tomrodinger/RS485_Controller/datasheet/assets/connection-diagram-prompt.txt

Use case: infographic-diagram
Asset type: professional technical datasheet connection illustration, landscape white background.
Primary request: Show one Gearotons RS485 Controller and exactly TWO NEMA 17 intelligent servomotors, with accurate, easy-to-follow power, RS485 A, RS485 B and COMMON GROUND connections. Use polished restrained semi-isometric technical cartoon objects with clean vector-like wiring and readable sans-serif labels. Reference image 1 shows controller hardware appearance, reference image 2 the controller including the external flat antenna. The controller is a small green ESP32-S3 PCB with two USB-C sockets, green 2-way screw terminal, 8-pin right-angle header, metal RF module and external flat black antenna.
Layout: controller left, Motor 1 center-right, Motor 2 far right. A small USB-C PD power adapter above the controller is labelled "USB-C PD supply" and "20 V capable". Its one cable goes ONLY to controller port labelled "J3 · PD POWER". Another OPTIONAL dashed cable from a small laptop goes ONLY to the OTHER controller USB-C port labelled "J5 · PROGRAM". Keep laptop tiny.
Electrical topology must be exact: controller exposes labelled functional terminal points "J1 +20 V", "J1 GND", "J2 A", "J2 B", "J2 GND". Each motor exposes four clearly separated labelled terminals "V+", "GND", "A", "B". RED power line runs from J1 +20 V to BOTH motors' V+. GREEN line runs from J2 A to Motor 1 A then Motor 2 A. BLUE line runs from J2 B to Motor 1 B then Motor 2 B. BLACK common-ground line runs from J1 GND to BOTH motor GND terminals AND connects to J2 GND. The GND connection is prominent, continuous and explicitly labelled "COMMON GROUND". Controller J1 GND and J2 GND are the same ground net. No lines connect unlike nets. Show branches using junction dots. Keep all connection routes legible and separated. The controller header 3.3 V and 5 V outputs MUST NOT connect to motor V+. You may simplify terminals into labelled schematic ports beside the illustrated objects to keep connectivity precise. All four nets are parallel shared nets; do not connect motors in series.
Text (verbatim): "Motor 1", "Motor 2", "RS485 Controller", "A → A", "B → B", "COMMON GROUND", "20 V to V+".
Style: elegant engineering documentation, green and dark charcoal palette, thin even linework, subtle shadows, realistic proportions, large whitespace and clear hierarchy. No invented specifications, no extra motors, no decorative wires, no title banner. Physical port locations are schematic, not a mating-face pinout. Do not add resistors. Make artwork large, at least 1536 pixels wide if possible.

Generated with the built-in image_gen tool on 2026-10-26. Reference images: owner-supplied component-side photo and front photo with antenna. This is a functional connection illustration; drawn terminal positions are not physical connector locations. All four nets were visually checked after generation.
