tomrodinger/RS485_Controller/diagram-review/prompts/02-motor-asset.txt

Use case: scientific-educational
Asset type: isolated product illustration asset for a technically accurate wiring manual. This is ONE motor asset only, no full diagram.
Reference image shows the real Gearotons M17 motors. Illustrate exactly ONE Gearotons M17-48 intelligent servomotor, three-quarter view slightly from above and from the connector side. Make the white SIX-position JST-PH-style SIDE connector near the bottom clearly visible, with a white mating pigtail plug seated in it. The six wire-exit positions must be individually countable. The motor is a black ribbed rectangular NEMA17 body with silver square top faceplate, four mounting holes and central short metal shaft rising upwards. Keep the form close to reference; no invented front panel or coloured screw terminals.
Style: polished restrained semi-isometric engineering illustration with subtle material shading, crisp edges, soft neutral illumination. More precise and professional than a playful cartoon. Transparent background, no desk, no labels, no text, no wire looms, no connecting cables, no arrows, no shadow on a background. Use a high enough resolution for a printable manual.
Composition: motor centered, completely within frame, generous 10% whitespace around it. Orient the connector low on the near-facing side and the mating plug's six wire-exit holes horizontally aligned and facing the viewer at the bottom. The plug should be large enough to support later precise vector wiring. Do not generate any wires; this asset will be used with exact overlaid technical connections.
