tomrodinger/RS485_Controller/diagram-review/reviews/ai-flat-technical-v1-visual-rejection.md

# Visual rejection: ai-flat-technical-v1

Inspected `diagram-review/candidates/ai-flat-technical-v1.png`.

Status: rejected; do not treat a style score as a technical pass.

- The realistic controller header shows two exposed male pins above the first attached black GND jumper. Black/green/blue therefore appear attached at physical positions 3/4/5 while the detached pinout inset claims 1/2/3. This is a hard rejection: physical endpoints disagree with the claimed pin map.
- Motor 1's duplicate A/B pair appears to end below the motor rather than continue to Motor 2. The blue network needs a separate exact trace; at a glance it appears to bypass Motor 1. The requested daisy-chain topology cannot be established confidently from the image.
- Motor 2's harness appears to contain an extra blue/teal lead, making the six-wire function/count unclear. The unused second pair is not visually distinct enough from the incoming pair.
- The two-way distribution block is a convincing physical object, but the wiring/terminal grouping is not clear enough to establish two separately isolated DC nets. Prefer explicitly separated + and GND blocks or exact vector-composed distribution wiring.

The image has stronger real-product appearance and avoids the old invented expansion-pad row, but those gains cannot overcome pin attachment and wire-count errors. I notified the parent and requested an independent electrical trace. The appropriate repair is exact wiring composition over trustworthy part artwork, not another unconstrained full-image regeneration with the same topology burden.
