tomrodinger/RS485_Controller/diagram-review/reviews/final-illustrated-and-gallery-ux-review.md

# Final illustrated revision and gallery screenshot review

## p06 / p07 targeted visual sign-off

Rendered each SVG at 1300 px width and inspected `p06-illustrated-natural-v2` and `p07-illustrated-stylized-v2`.

**Pass for owner preference review.** Scores: natural p06 **90/100**, stylized p07 **91/100**. No new endpoint, crossing, header-count, or false physical motor-face mapping veto found. This is visual sign-off on the schematic preference candidates, not product qualification or publication approval.

- GND and V+ now have an actual visible gap at the test size; neither reads as one merged label.
- “Six-wire pigtail functions” identifies the detached key locally.
- “A leads linked” / “B leads linked” communicates internal continuity without ambiguous references to J2 pin numbers.
- “Use a twisted pair” makes the intended cable treatment explicit.
- Motor connector artwork stays unmated; colored electrical lines terminate in the function key, not unverified physical cavities.
- Optional J2 reference, substantial motor returns, independent spare caps and crossing separation remain clear.

The natural rendering remains slightly stronger as a product presentation; stylized remains slightly more coherent with the schematic controller. Both merit inclusion so the owner can make that aesthetic choice. Smaller fit widths still require zoom and the existing shallow datasheet placement would require a separate print adaptation.

## Website screenshot review scope

Viewed `/tmp/rs485-gallery-desktop.png` (1512 × 1556) and `/tmp/rs485-gallery-mobile.png` (390 × 2695). The desktop capture showed the earlier three-item set; mobile showed six candidates. Findings concern visible UX, not a new independent interaction/storage test. Main agent is conducting browser tests.

## What supports the requested review task

- The active candidate, large star control, rating caption, comment label and textarea form a clear review flow.
- Desktop keeps the image beside the feedback form. Mobile stacks them without hiding the review controls.
- Candidate names, revision metadata and current position identify what receives feedback.
- The progress count, selected-card outline and comparison state provide useful orientation.
- Autosave/account/browser-copy language and export notice make persistence and sharing visible. I cannot independently certify synchronization behavior from screenshots.
- Notes are not forced into a small one-line field. Existing stars and comments remain visible in the mobile capture.

## Highest-priority UX repair

**Make diagram enlargement much easier to discover and tap on mobile.** The mobile fit view is around 12%, so the connection labels are necessarily unreadable there. Much of the viewer's height becomes empty space around a shallow landscape image, while Expand/100%/+/− are tiny toolbar actions. A user can reach the rating form without ever seeing a legible pinout.

Recommended repair: promote a clear “Expand diagram” button with a generous touch target adjacent to the viewer and add a short cue such as “Zoom in before rating; pin labels are small in fit view.” The existing expansion feature can be retained; this is a discoverability/touch-size change. Reduce unnecessary fit-view height on mobile if practical, but retain enough space for panning after zoom.

The mobile hint currently describes Ctrl/⌘ scroll and arrow keys, which does not teach touch users how to inspect the image. Replace it at mobile widths with the actual supported interaction, such as “Drag to pan. Use +/− or Expand to inspect labels.” Do not promise pinch zoom unless it is implemented and tested.

## Secondary UX issues

1. **Passive card stars resemble rating controls.** Card footers display stars beside the comparison checkbox. A user may try to rate there, but the large active-review stars are the actual control. Make card stars open/focus the corresponding review, or label them as a rating summary and add “Open to rate.” This is a potential expectation mismatch, not a demonstrated interaction failure.
2. **Small touch controls.** Compare checkboxes, viewer arrows and zoom actions look much smaller than the main review stars/buttons. The large detail-panel comparison button offers a good alternative. Improving hit areas can preserve the visual size of the icons.
3. **Small secondary text on mobile.** The save help, status chip, revision metadata, card subtitles and viewer hint are dense. They are secondary, but the enlargement instruction and save status should be easier to read than the least-important metadata.
4. **Top actions compete for limited mobile width.** Download PNGs, account status, export and import all occupy the header. They remain usable in the screenshot, but a compact overflow area for infrequent import/download actions would leave review navigation clearer. This is optional and should not delay tested rating/comment persistence.
5. **Comparison selection is reasonably clear.** A 2/2 comparison count and checked cards are shown. The screenshot cannot establish how a third selection is handled; browser testing should confirm an understandable message rather than silently refusing.

No screenshot-level blocker was found for entering stars or comments. The enlargement affordance is the most material usability improvement because reliable feedback depends on inspecting the actual connection labels.
