tomrodinger/RS485_Controller/diagram-review/round2/r2-05-natural-pigtails.pdf

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
ESP32-S3

MINI-1U

J1

J3

J5

S1

S2

GEAROTONS / RS485 CONTROLLER
Two motors. One complete connection map.

USB-C PD input · parallel motor power · one continuous RS485 bus

Controller · PCB 0.5 geometry J2 pins 2 / 3 share one paired housing

## Motor 1

White 6-way motor plug

GND | V+ | A | B | A | B

Schematic harness · mating face not shown

A ↔ A
B ↔ B

Inside motor

## Motor 2

White 6-way motor plug

GND | V+ | A | B | A | B

Schematic harness · mating face not shown

A ↔ A
B ↔ B

Inside motor

V+ · direct PD VBUS from J1

GND · full-size motor return

MOTOR POWER · PARALLEL

A/B DAISY-CHAIN · KEEP EACH PAIR TOGETHER

Spare A/B pair
Two isolated cavities

### 20 V-capable USB-C PD supply

USB-C cable → J3 PD POWER

Power in parallel. A/B continues through Motor 1 to Motor 2.
J1 and J2 GND are common on the PCB; both motors have full-size power-return wires.
20 V is nominal after PD negotiation. Wire with power off; verify voltage and polarity.
A/B lines show electrical pairing; select compatible mating parts. Each black shell has two isolated cavities.
