tomrodinger/RS485_Controller/datasheet/assets/connection-v0.4/two-motor-connection-v0.4.png

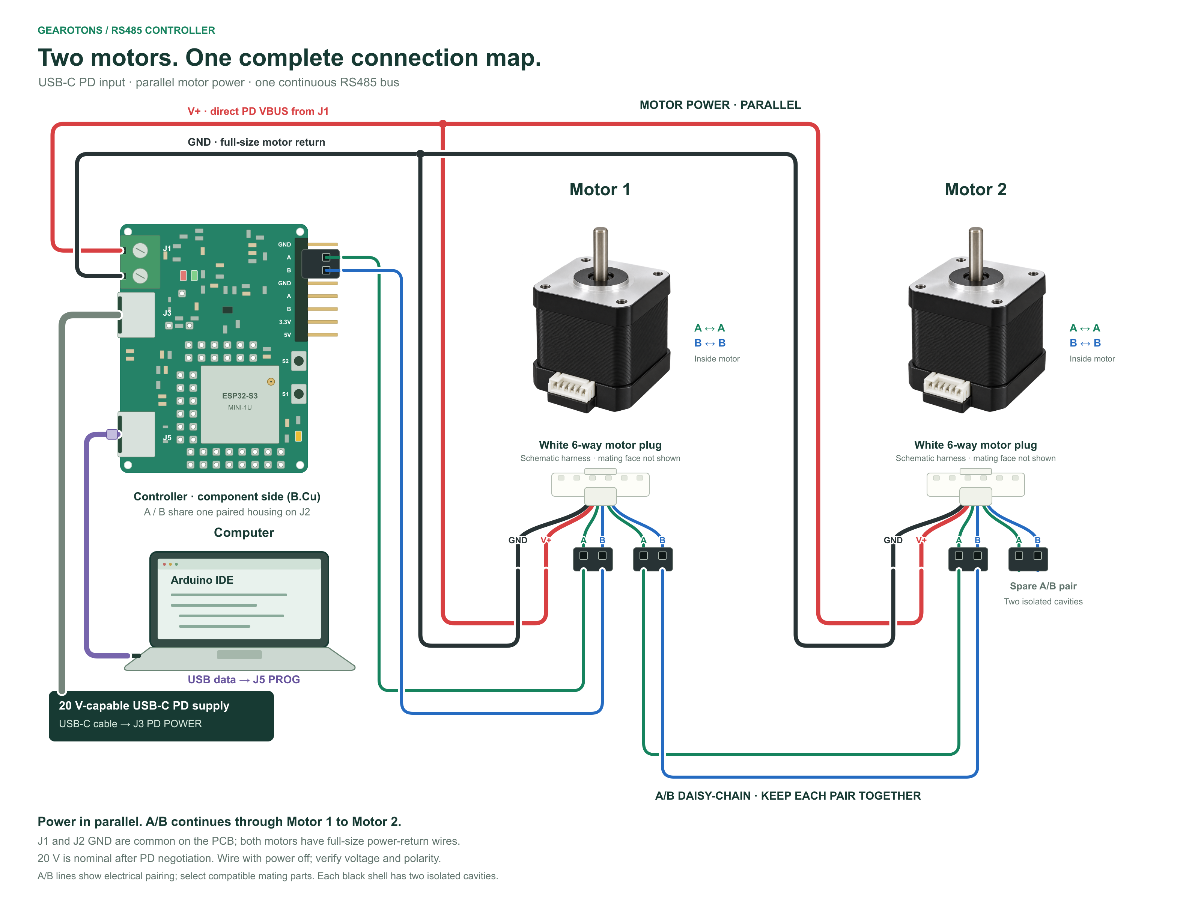
datasheet/assets/connection-v0.4/two-motor-connection-v0.4.png
