tomrodinger/RS485_Controller/datasheet/assets/technical-v4/breakout-headers.png

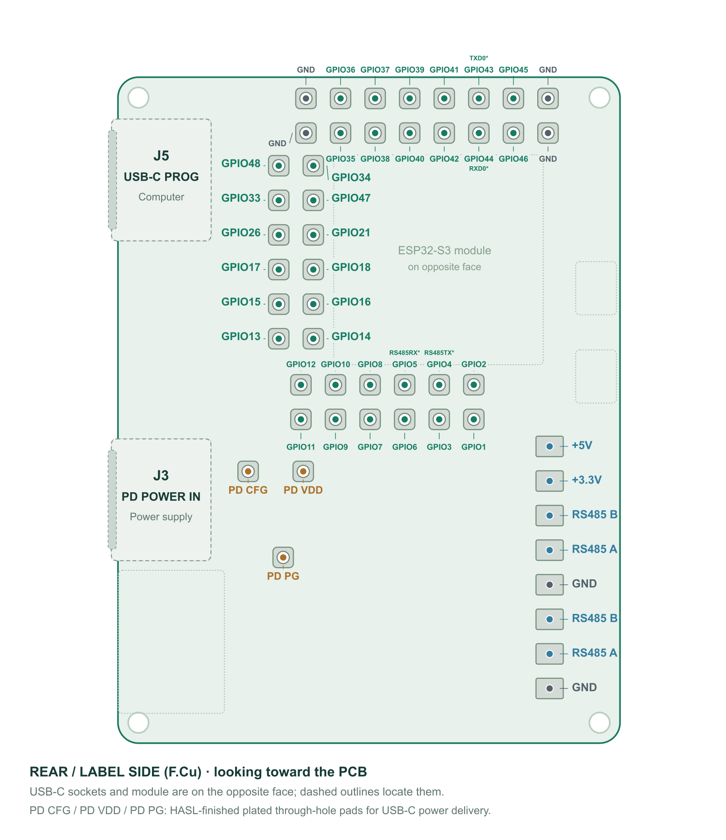
datasheet/assets/technical-v4/breakout-headers.png
