tomrodinger/RS485_Controller/datasheet/assets/technical-v4/connector-locator.png

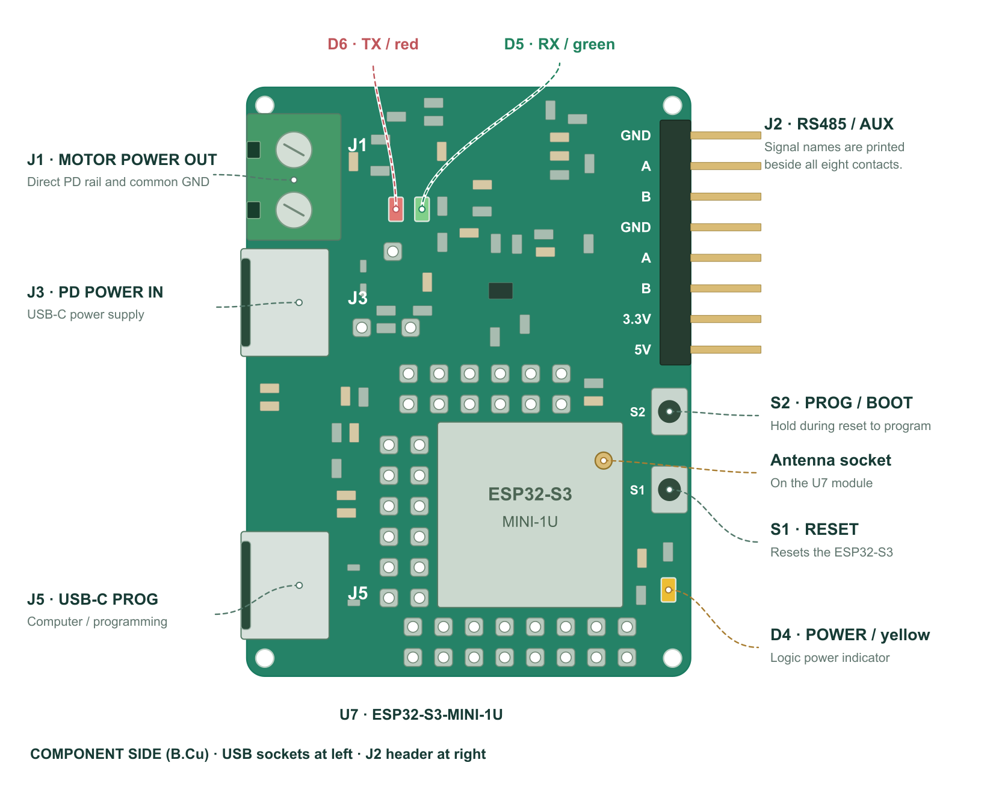
datasheet/assets/technical-v4/connector-locator.png
