tomrodinger/RS485_Controller/datasheet/assets/technical-v4/mechanical-dimensions.png

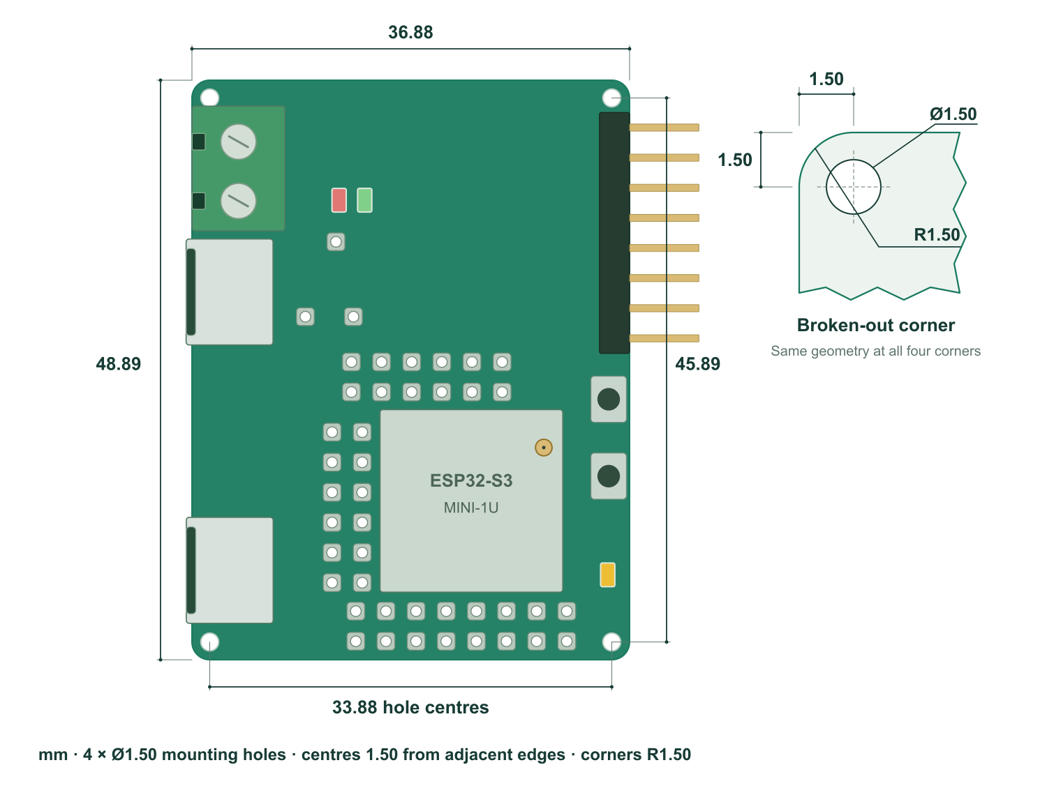
datasheet/assets/technical-v4/mechanical-dimensions.png
