tomrodinger/RS485_Controller/datasheet/assets/two-motor-connection-ai.png

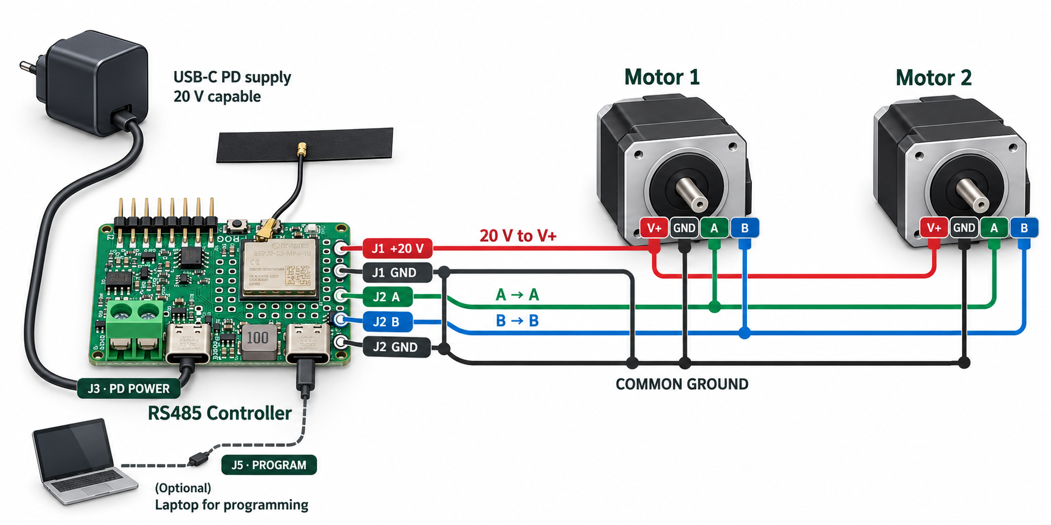
datasheet/assets/two-motor-connection-ai.png
