tomrodinger/RS485_Controller/diagram-review/candidates/ai-flat-technical-v1.png

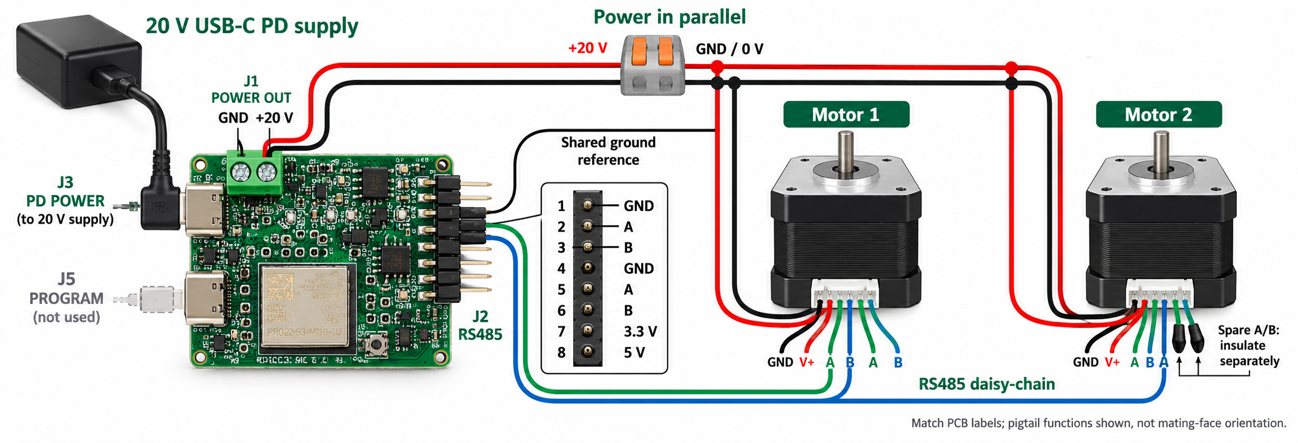
diagram-review/candidates/ai-flat-technical-v1.png
