tomrodinger/RS485_Controller/diagram-review/candidates/p01-connector-landmarks-v1.png

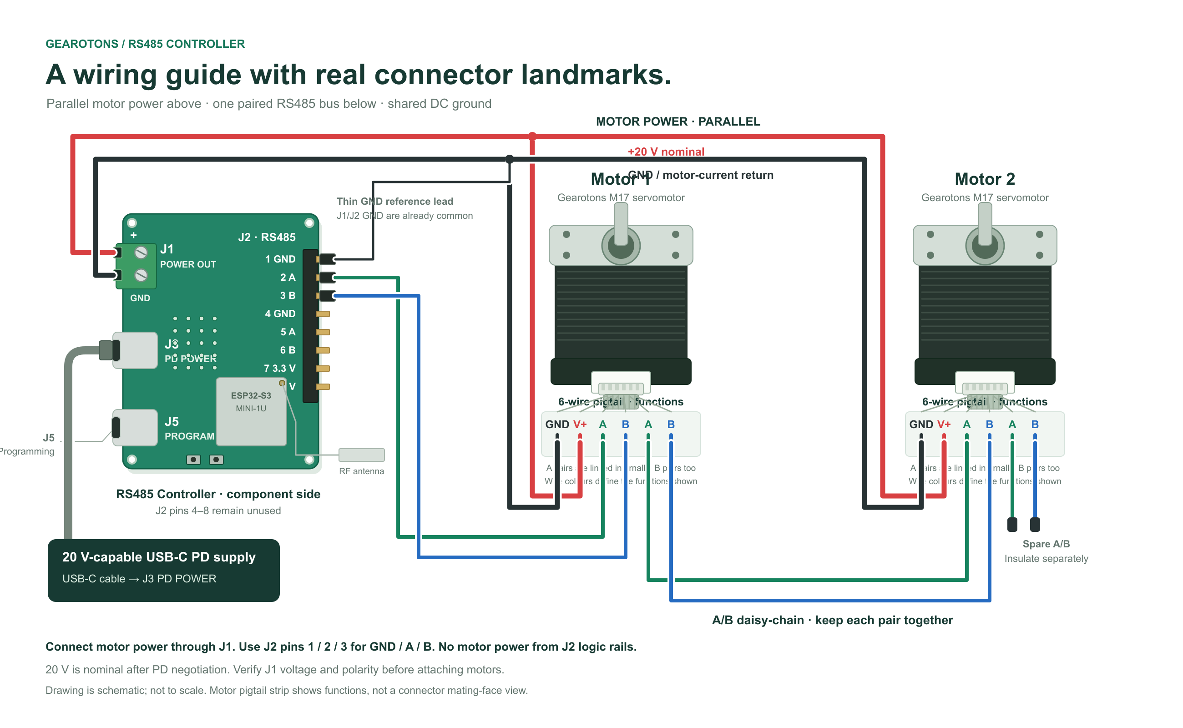
diagram-review/candidates/p01-connector-landmarks-v1.png
