tomrodinger/RS485_Controller/diagram-review/candidates/p04-illustrated-natural-v1.png

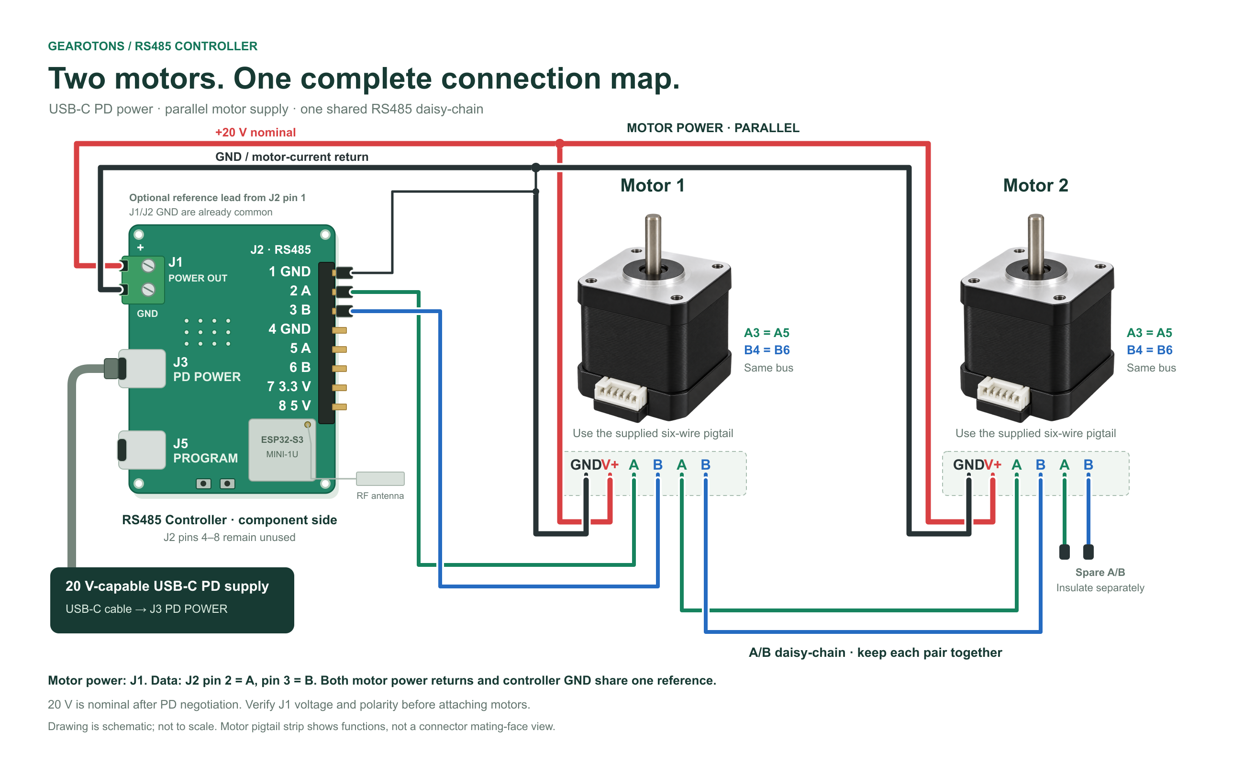
diagram-review/candidates/p04-illustrated-natural-v1.png
