tomrodinger/RS485_Controller/diagram-review/exports/connector-landmarks.png

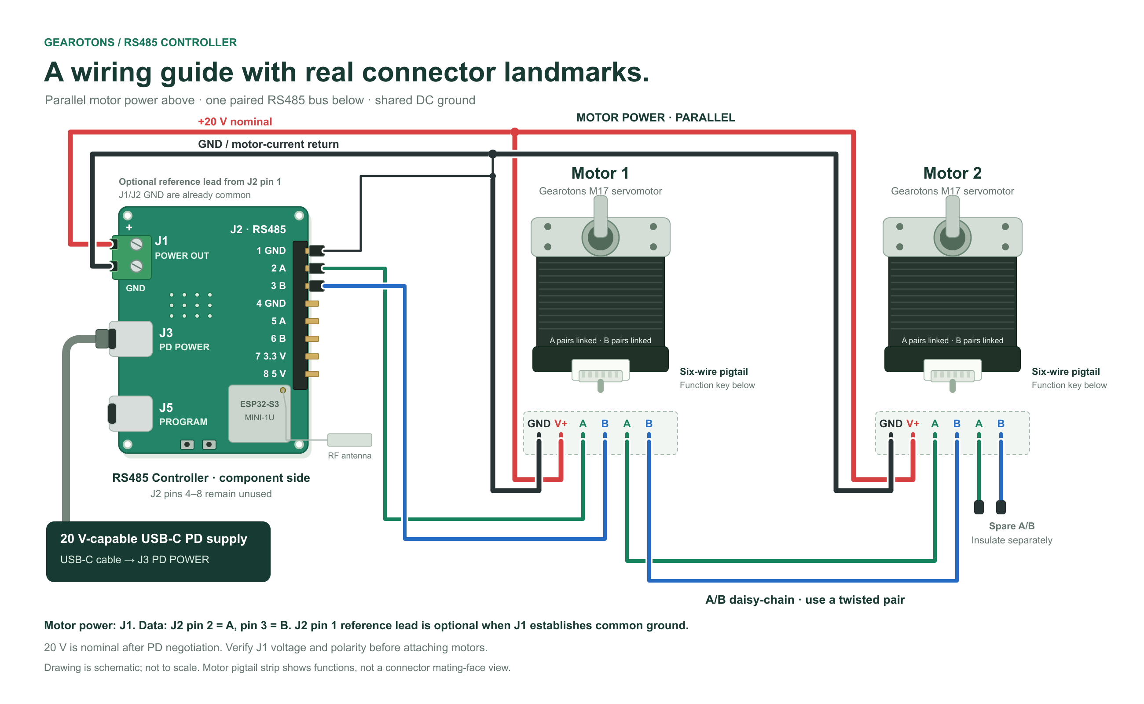
diagram-review/exports/connector-landmarks.png
