tomrodinger/RS485_Controller/diagram-review/exports/r2-01-photo-harness.png

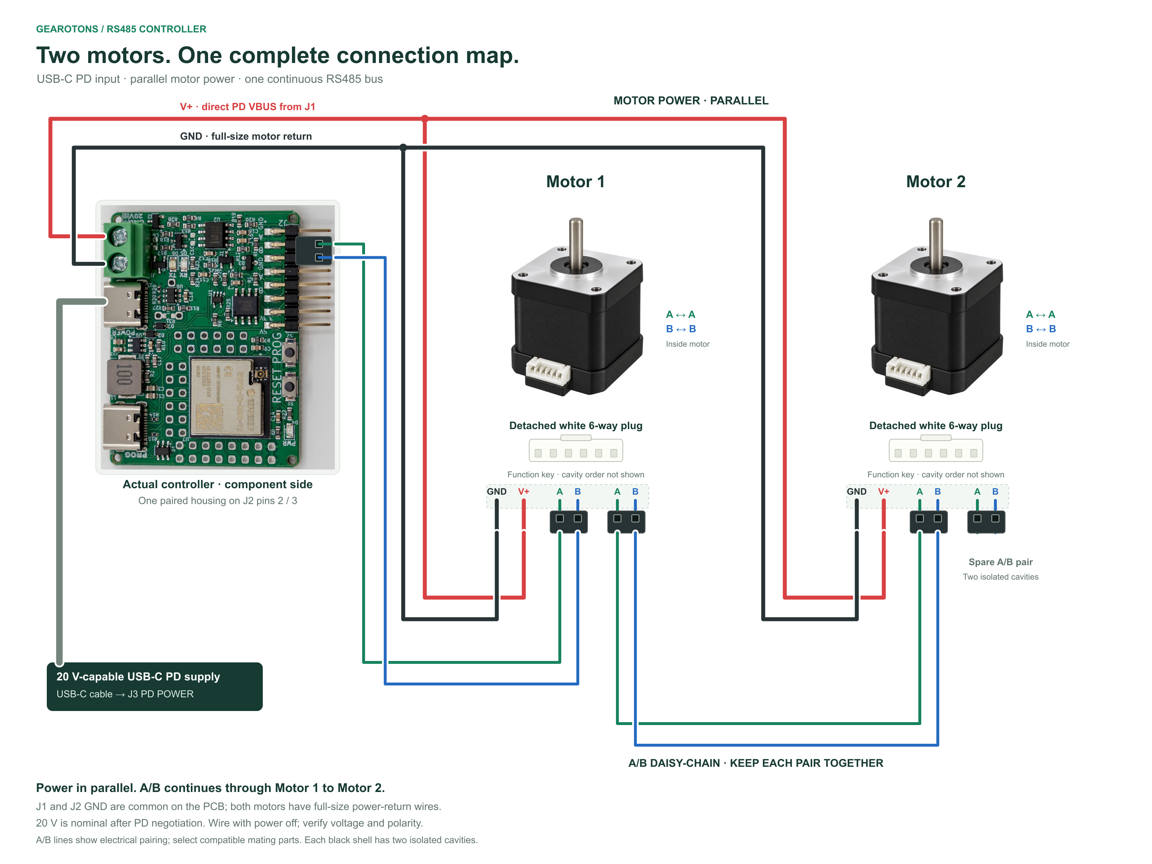
diagram-review/exports/r2-01-photo-harness.png
