tomrodinger/RS485_Controller/diagram-review/exports/round2-pngs/r2-05-natural-pigtails.png

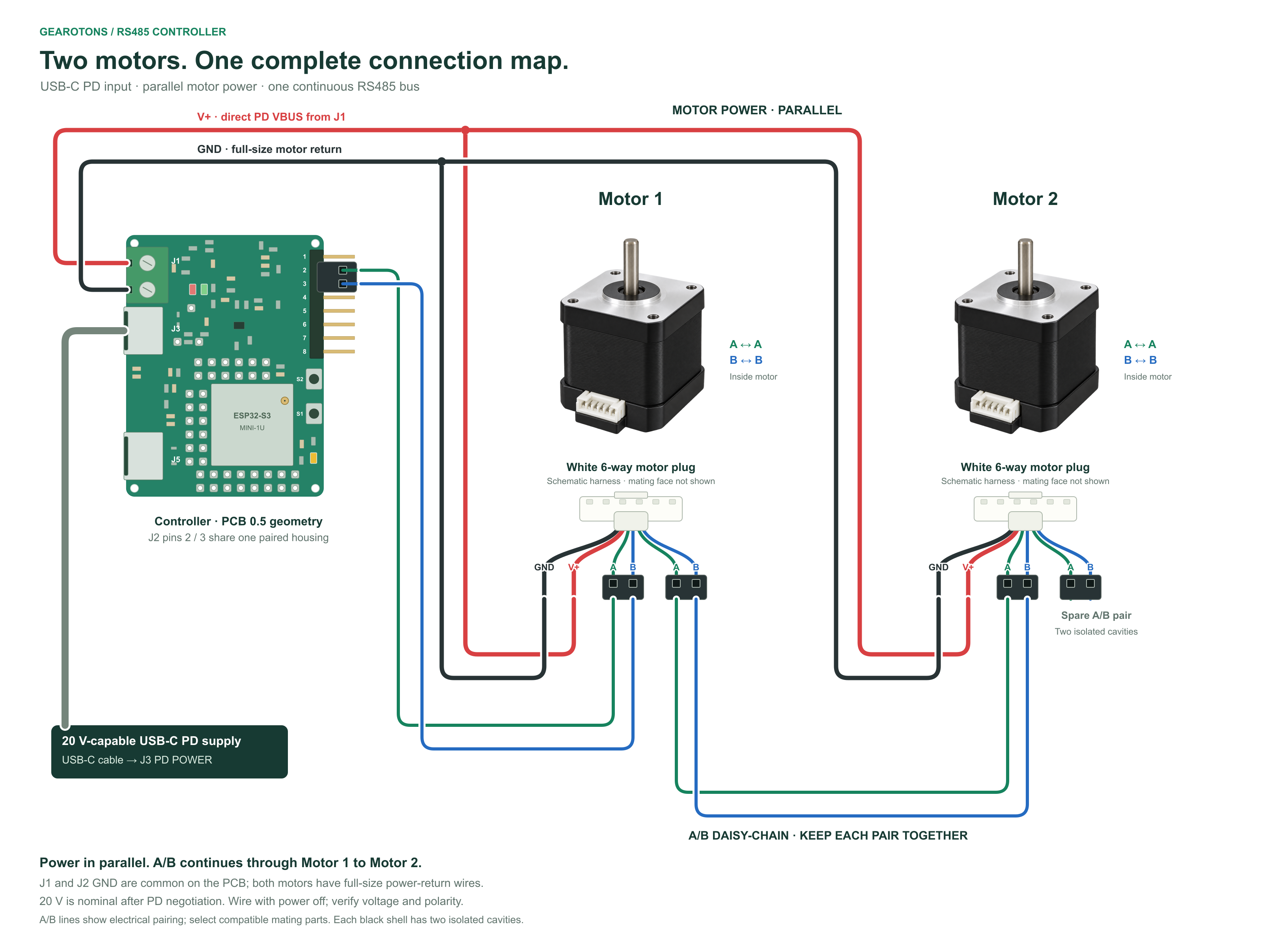
diagram-review/exports/round2-pngs/r2-05-natural-pigtails.png
