tomrodinger/RS485_Controller/diagram-review/visual-candidates/v01-precise-electrical-preview.png

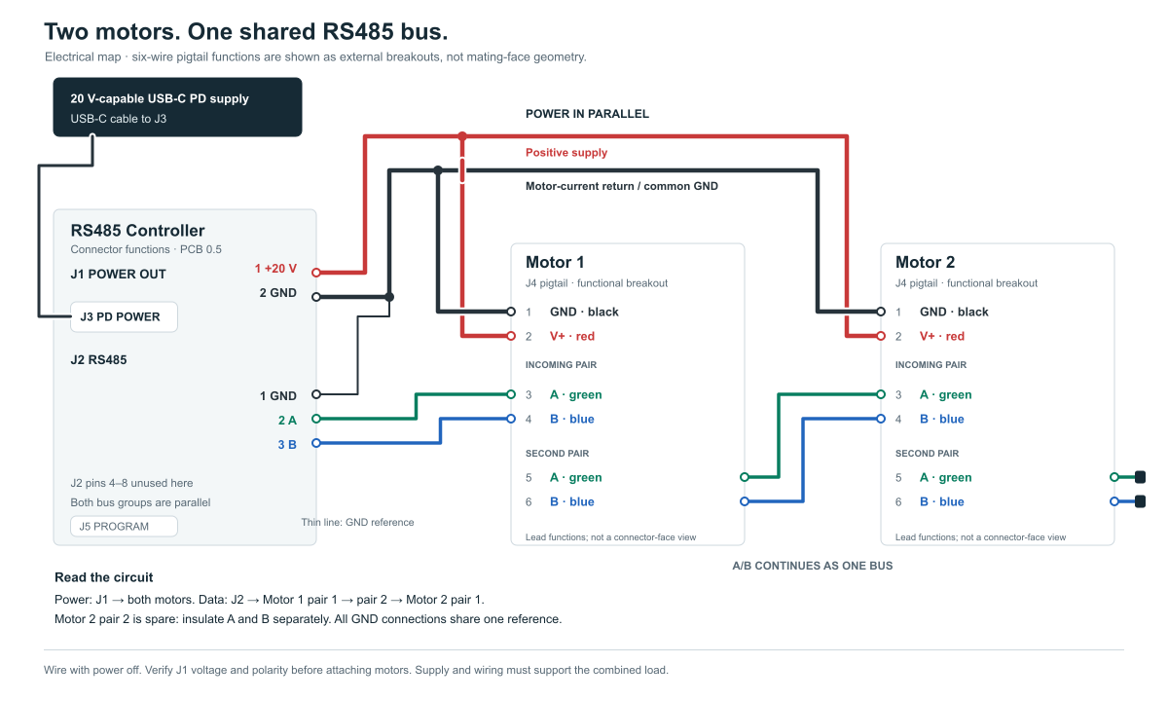
diagram-review/visual-candidates/v01-precise-electrical-preview.png
