tomrodinger/RS485_Controller/diagram-review/working/motor-asset-stylized-v1.png

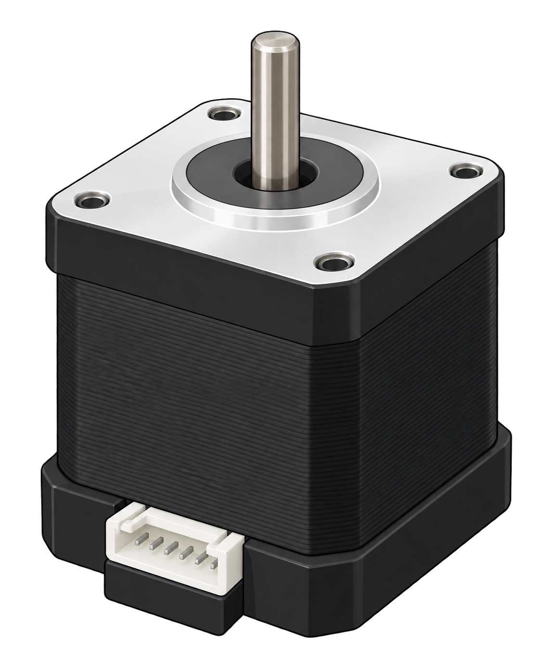
diagram-review/working/motor-asset-stylized-v1.png
