tomrodinger/RS485_Controller/diagram-review/working/motor-asset-v1.png

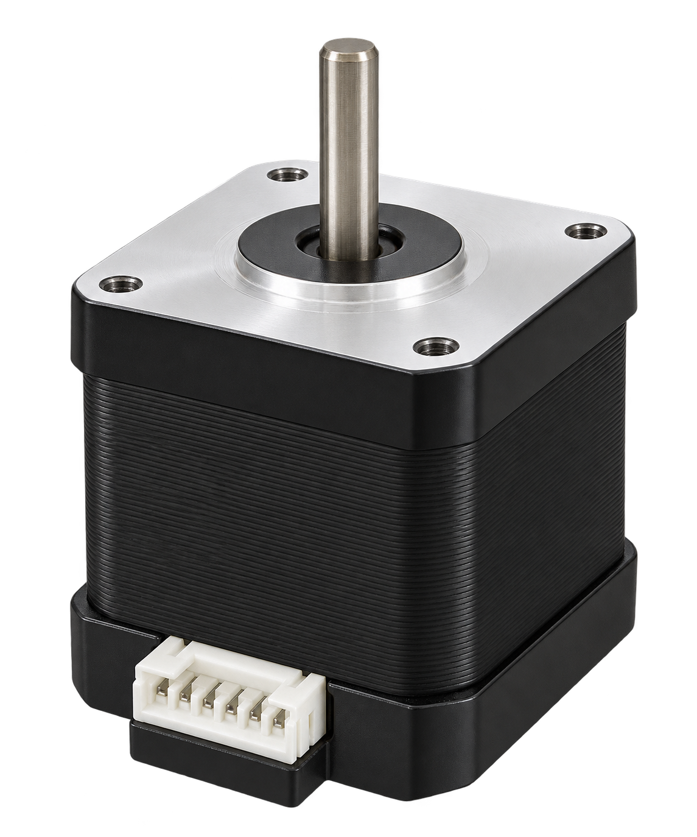
diagram-review/working/motor-asset-v1.png
