tomrodinger/RS485_Controller/images/rs485-controller/label-side-800.webp

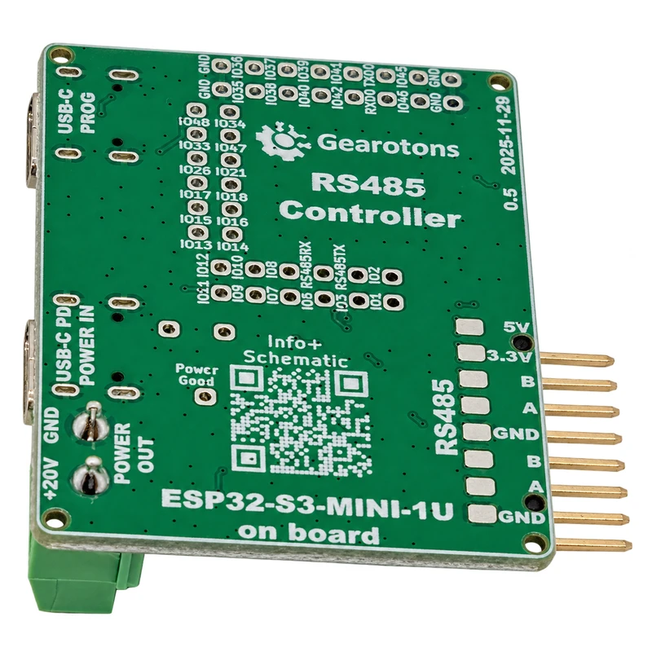
images/rs485-controller/label-side-800.webp
