tomrodinger/RS485_Controller/images/rs485-controller/ports-800.webp

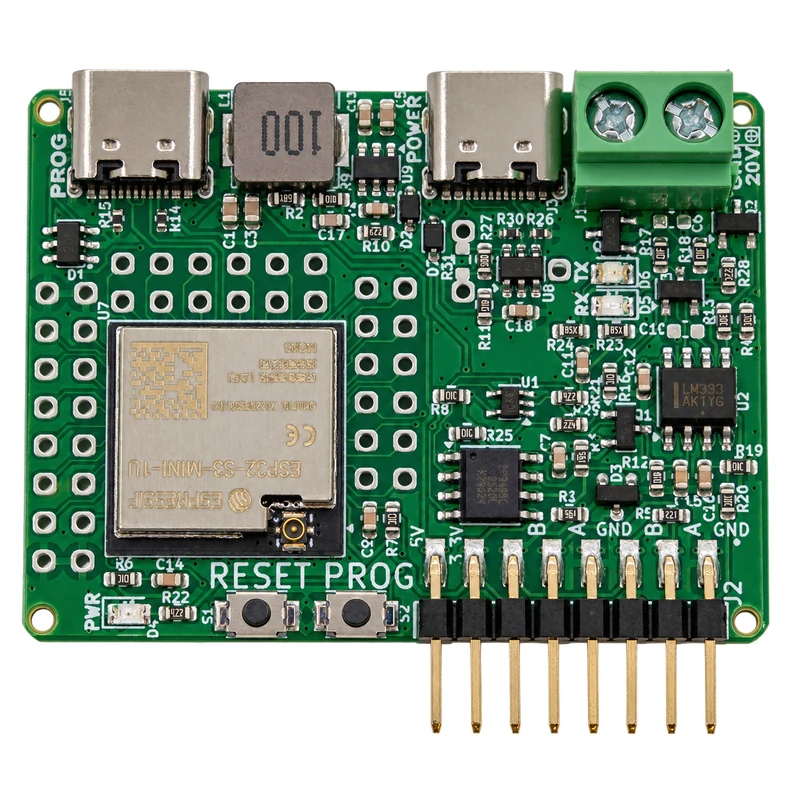
images/rs485-controller/ports-800.webp
