tomrodinger/RS485_Controller/PCB/V1_not_completed/screenshots/3Dtop.png

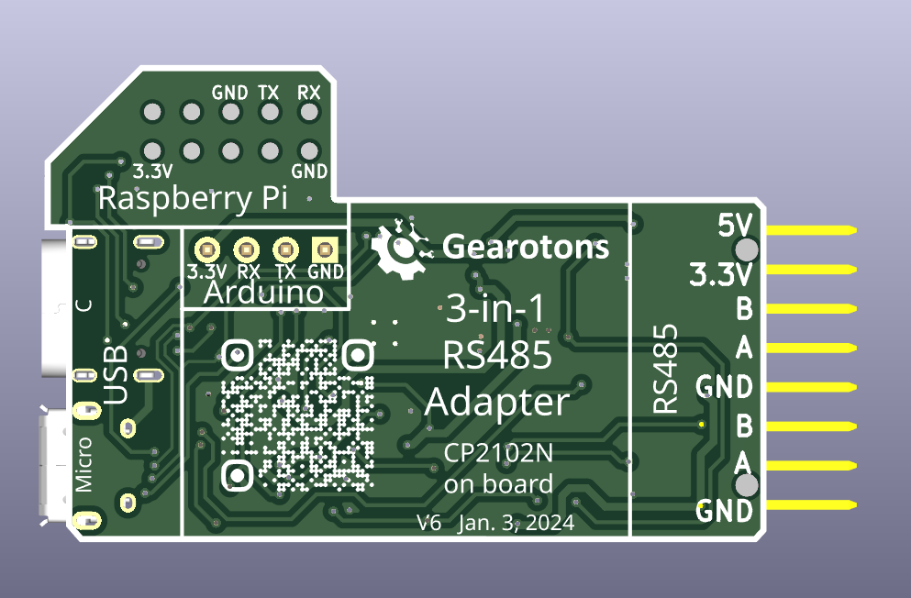
PCB/V1_not_completed/screenshots/3Dtop.png
