tomrodinger/RS485_Controller/images/rs485-controller/component-side-background-prompt.txt

Use case: background-extraction. Edit target: the supplied real product photograph of a Gearotons RS485 Controller. Remove ONLY the gray tabletop/background and all tabletop shadows, replacing them with genuinely transparent pixels. Angled isometric component-side view of the PCB without antenna; preserve the two USB-C ports, the green two-way screw terminal, eight long gold header pins, module shield and every small component and marking. Preserve the original product pixels, photographic detail, geometry, colors, focus, solder, traces, silkscreen lettering and fine edges. Cleanly cut out the board and every protruding pin/port, including the background visible between pins and through holes. Do not redraw or retouch the product or invent any text or parts. Keep the complete product and original square framing. No background color, gray matte, checkerboard artwork, halo, drop shadow, captions or watermark. Output a high-resolution transparent PNG.
