tomrodinger/RS485_Controller/PCB/0.5/production/bom.csv

Designator | Footprint | Quantity | Value | LCSC Part #
C1, C3 | 0603 | 2 | 22uF/6.3V | C59461
C11, C12, C13, C16, C4, C7 | 0603 | 6 | 100nF/50V | C14663
C14, C9 | 0603 | 2 | 10nF | C57112
C15 | 0603 | 1 | 1nF | C1588
C17 | 0603 | 1 | 47pF | C1671
C18 | 0603 | 1 | 1uF/25V | C15849
C5 | 0603 | 1 | 10uF/25V | C96446
D1 | SOT23-6L | 1 | TVS_5V | C558417
D2, D7 | SOD323 | 2 | 1N5819WS | C191023
D3 | SOT23-3 | 1 | SM712 | C293966
D4 | 0805 | 1 | yellow | C2296
D5 | 0805 | 1 | green | C2297
D6 | 0805 | 1 | red | C84256
J1 | 2P_screw_terminal | 1 | Screw_Terminal_01x02 | C8404
J2 | Connector_8-pin_SMT_hole_1.5mm | 1 | TSM-108-01-T-SH-A-P-TR | C9900147851
J3, J5 | USB_C_Receptacle_Palconn_UTC16-G | 2 | USB_C_Receptacle | C2765186
L1 | Inductor_7.3x6.6mm | 1 | 10uH | C128692
Q1, Q2, Q3 | SOT-23 | 3 | BSS84AK,215 | C127273
Q4 | SOT-23 | 1 | Q_NMOS_GSD | C8545
R1, R3 | 0603 | 2 | 560R | C23204
R10 | 0603 | 1 | 22k | C31850
R11, R12 | 0603 | 2 | 1k | C21190
R13, R20, R4 | 0603 | 3 | 20k | C4184
R14, R15, R26, R30 | 0402 | 4 | 5.1k | C25905
R16, R19, R25, R6, R7, R8 | 0603 | 6 | 10k | C25804
R17, R18 | 0603 | 2 | 10M | C7250
R2 | 0603 | 1 | 49.9 | C23185
R21, R22, R28, R29 | 0603 | 4 | 4.7k | C23162
R23, R24 | 0603 | 2 | 75R | C4275
R27 | 0603 | 1 | 200k | C25811
R5 | 0603 | 1 | 220R | C22962
R9 | 0603 | 1 | 100k | C25803
S1, S2 | button | 2 | SW_Push | C720477
U1 | Texas_R-PDSO-G5_DCK-5 | 1 | SN74LVC1G00DCK | C2976658
U2 | SOIC-8_3.9x4.9mm_P1.27mm | 1 | LM393DR2G | C7955
U5 | SOIC-8_3.9x4.9mm_P1.27mm | 1 | SP3485EN | C8963
U7 | ESP32-S2-MINI-1U | 1 | ESP32-S3-MINI-1U | C2980299
U8 | SOT-23-6 | 1 | CH221K | C5125736
U9 | SOT-23-6 | 1 | TPS54202DDC | C191884
