tomrodinger/RS485_Controller/PCB/V1_not_completed/3D/RPH1-V6-04-01-24.step

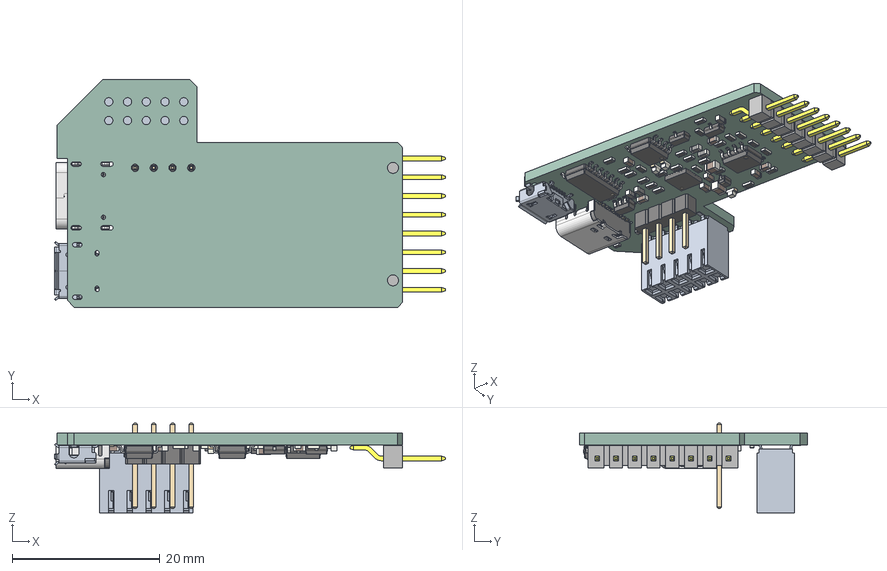
[picture p22: CAD file, 2026-11-04]
PCB/V1_not_completed/3D/RPH1-V6-04-01-24.step
52.9 x 30.9 x 12.1 mm
uw-rs485_hat-V6 PCB
