tomrodinger/RS485_Controller/diagram-review/exports/two-step.png

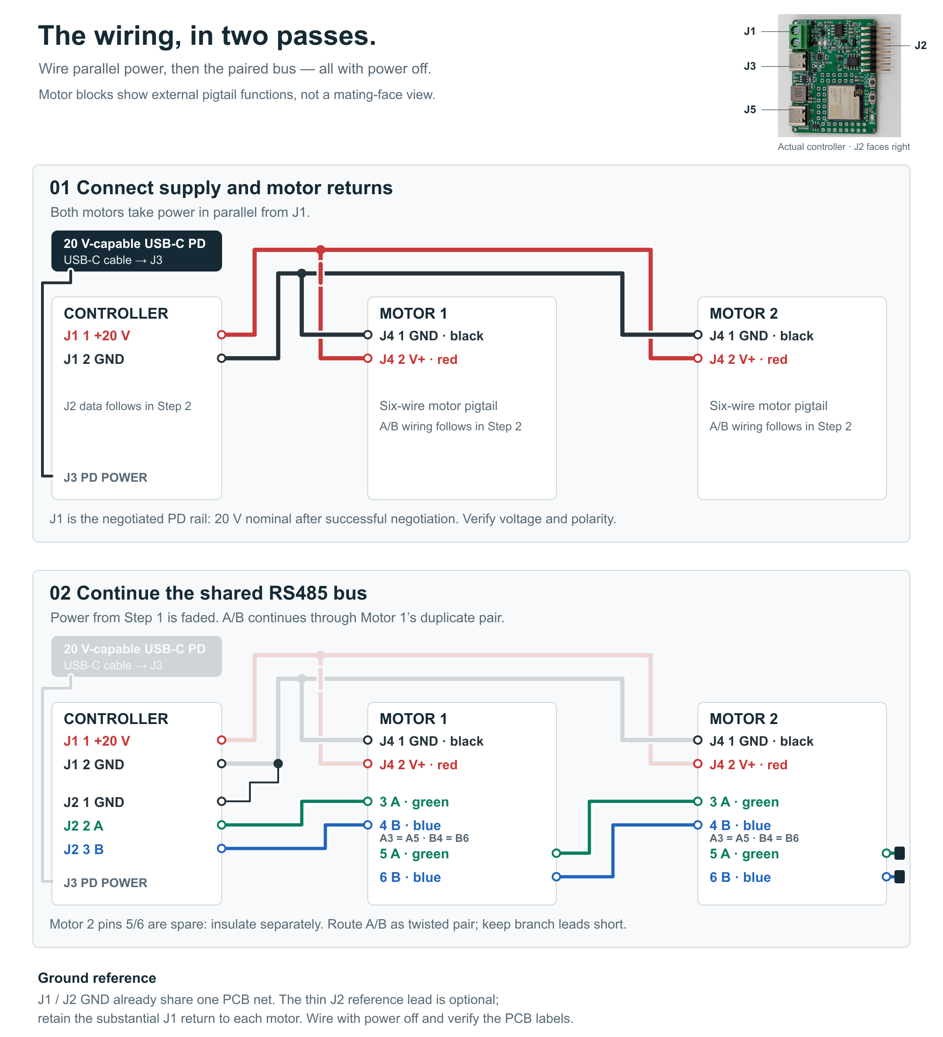
diagram-review/exports/two-step.png
