tomrodinger/RS485_Controller/diagram-review/round2/r2-03-photo-field-guide.png

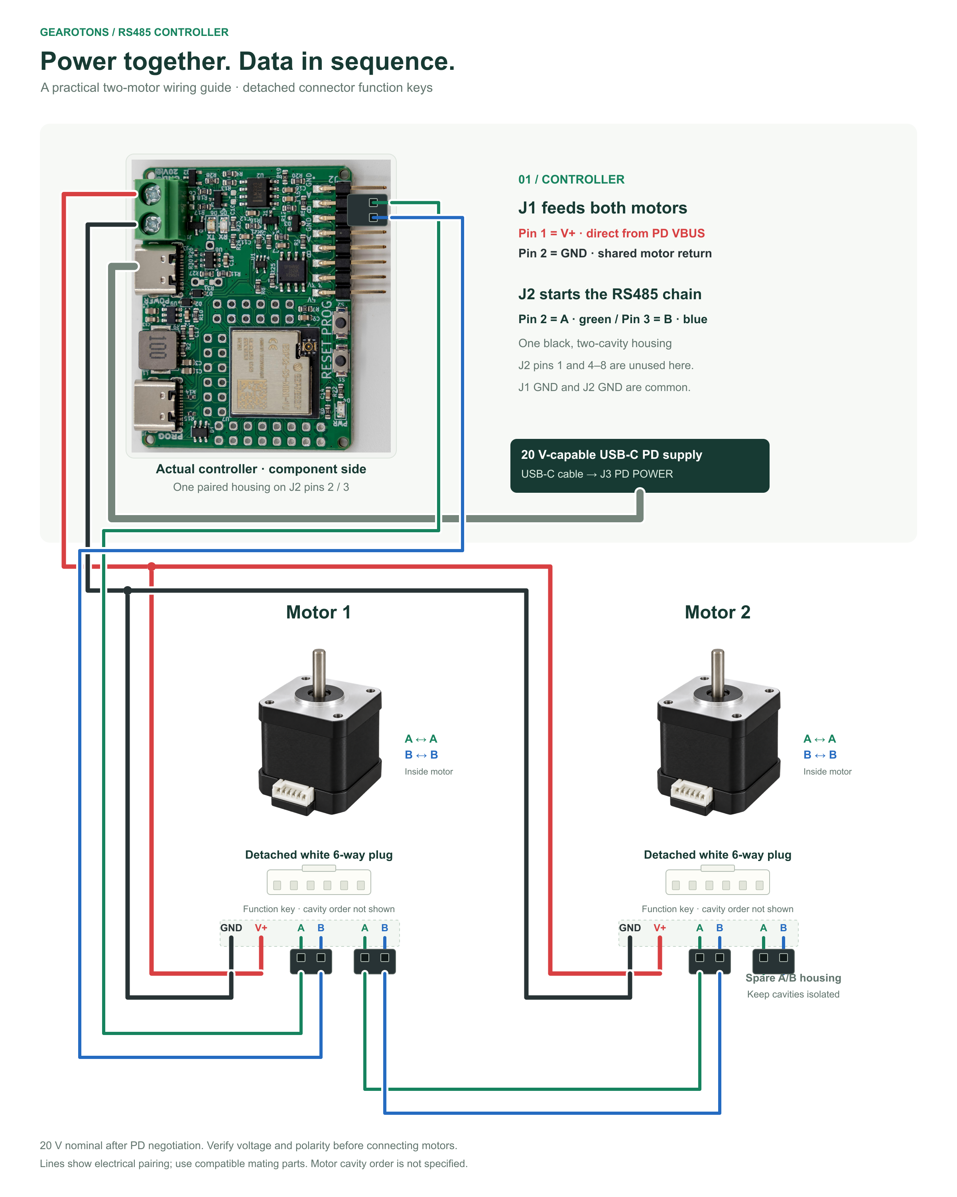
diagram-review/round2/r2-03-photo-field-guide.png
