tomrodinger/RS485_Controller/diagram-review/visual-candidates/v02-photo-guided-preview.png

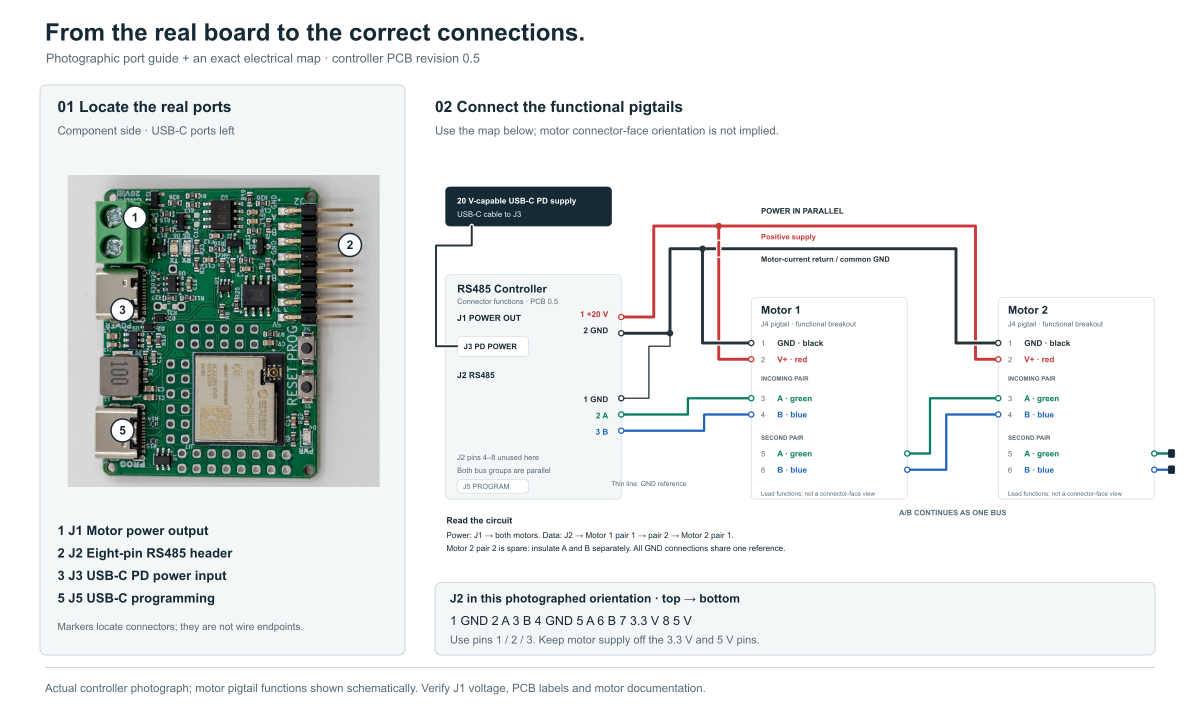
diagram-review/visual-candidates/v02-photo-guided-preview.png
