tomrodinger/RS485_Controller/PCB/V1_not_completed/schematic/V10-index-schTop.pdf

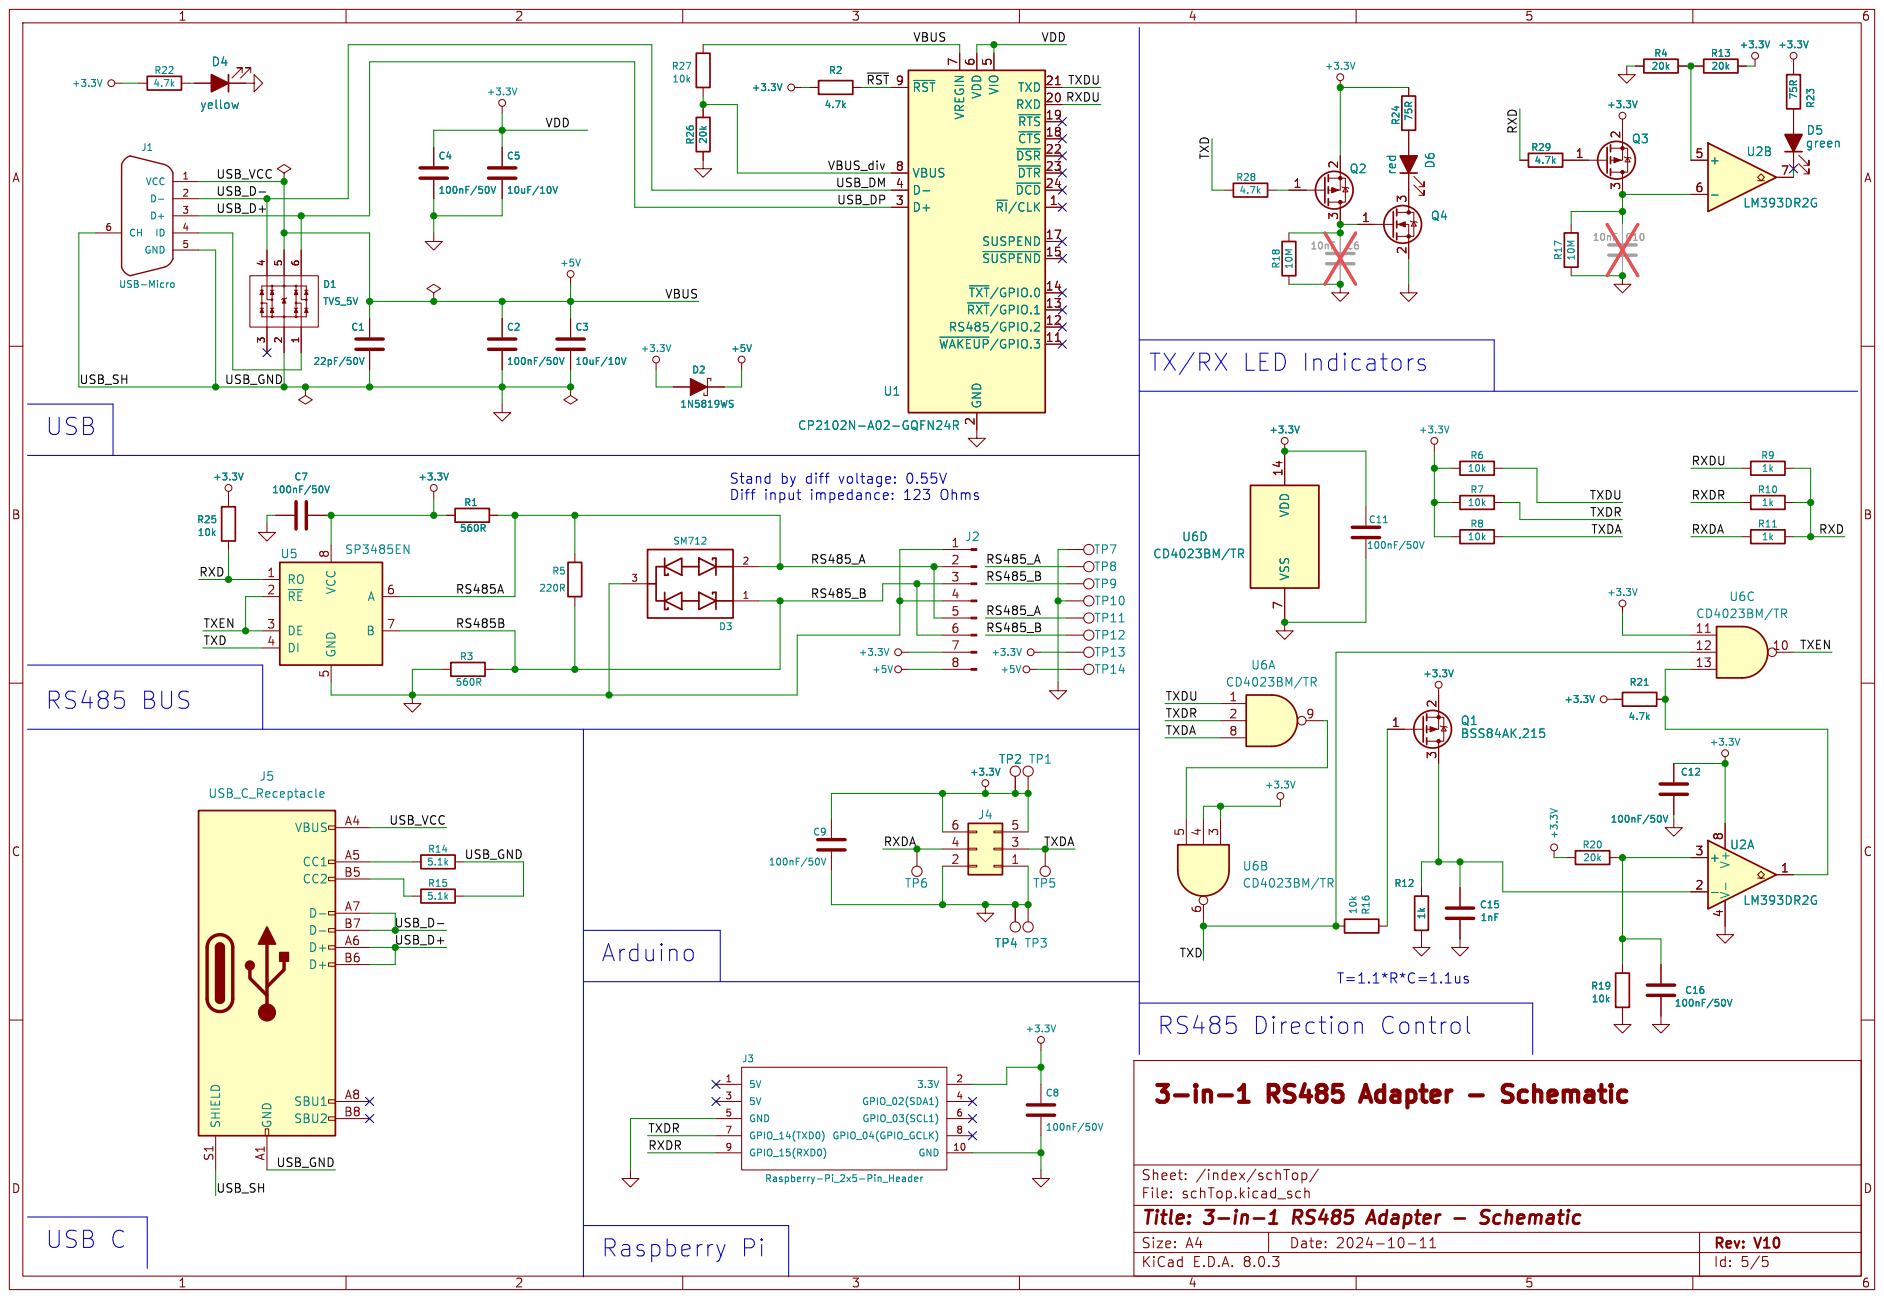
[picture p26: page 1]

2 RXD 20 TXD 21 ~{DSR} 22 ~{DTR} 23 ~{DCD} 24 D+ 3 D- 4 VIO

TX/RX LED Indicators

File: schTop.kicad_sch Sheet: /index/schTop/
