tomrodinger/RS485_Controller/PCB/0.5/schematic/0.5-index-schTop.pdf

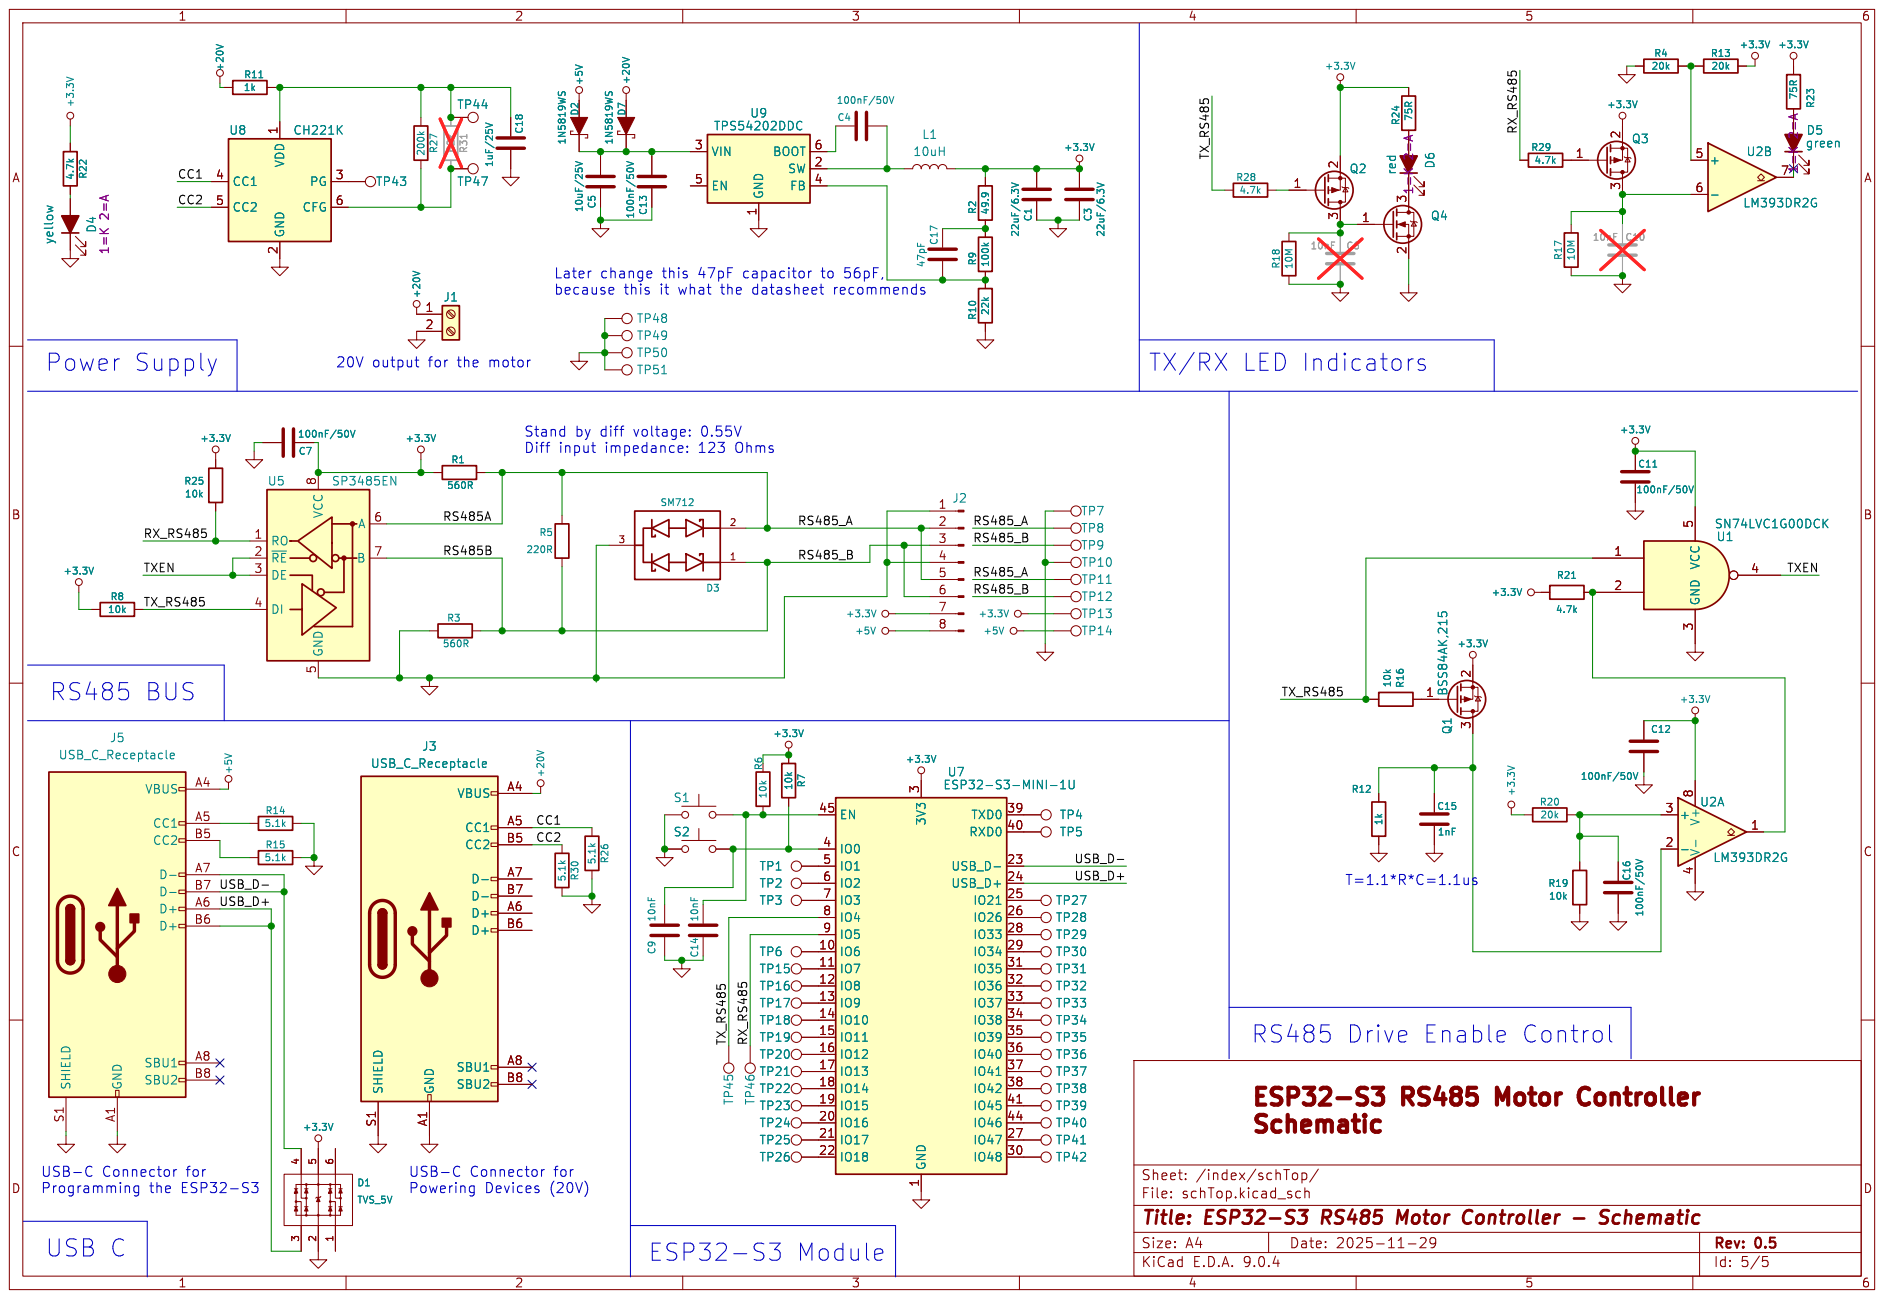
[picture p27: page 1]

T=1.1*R*C=1.1us TX/RX LED Indicators

File: schTop.kicad_sch Sheet: /index/schTop/
