tomrodinger/RS485_Controller/PCB/0.2/schematic/0.2-index-schTop.pdf

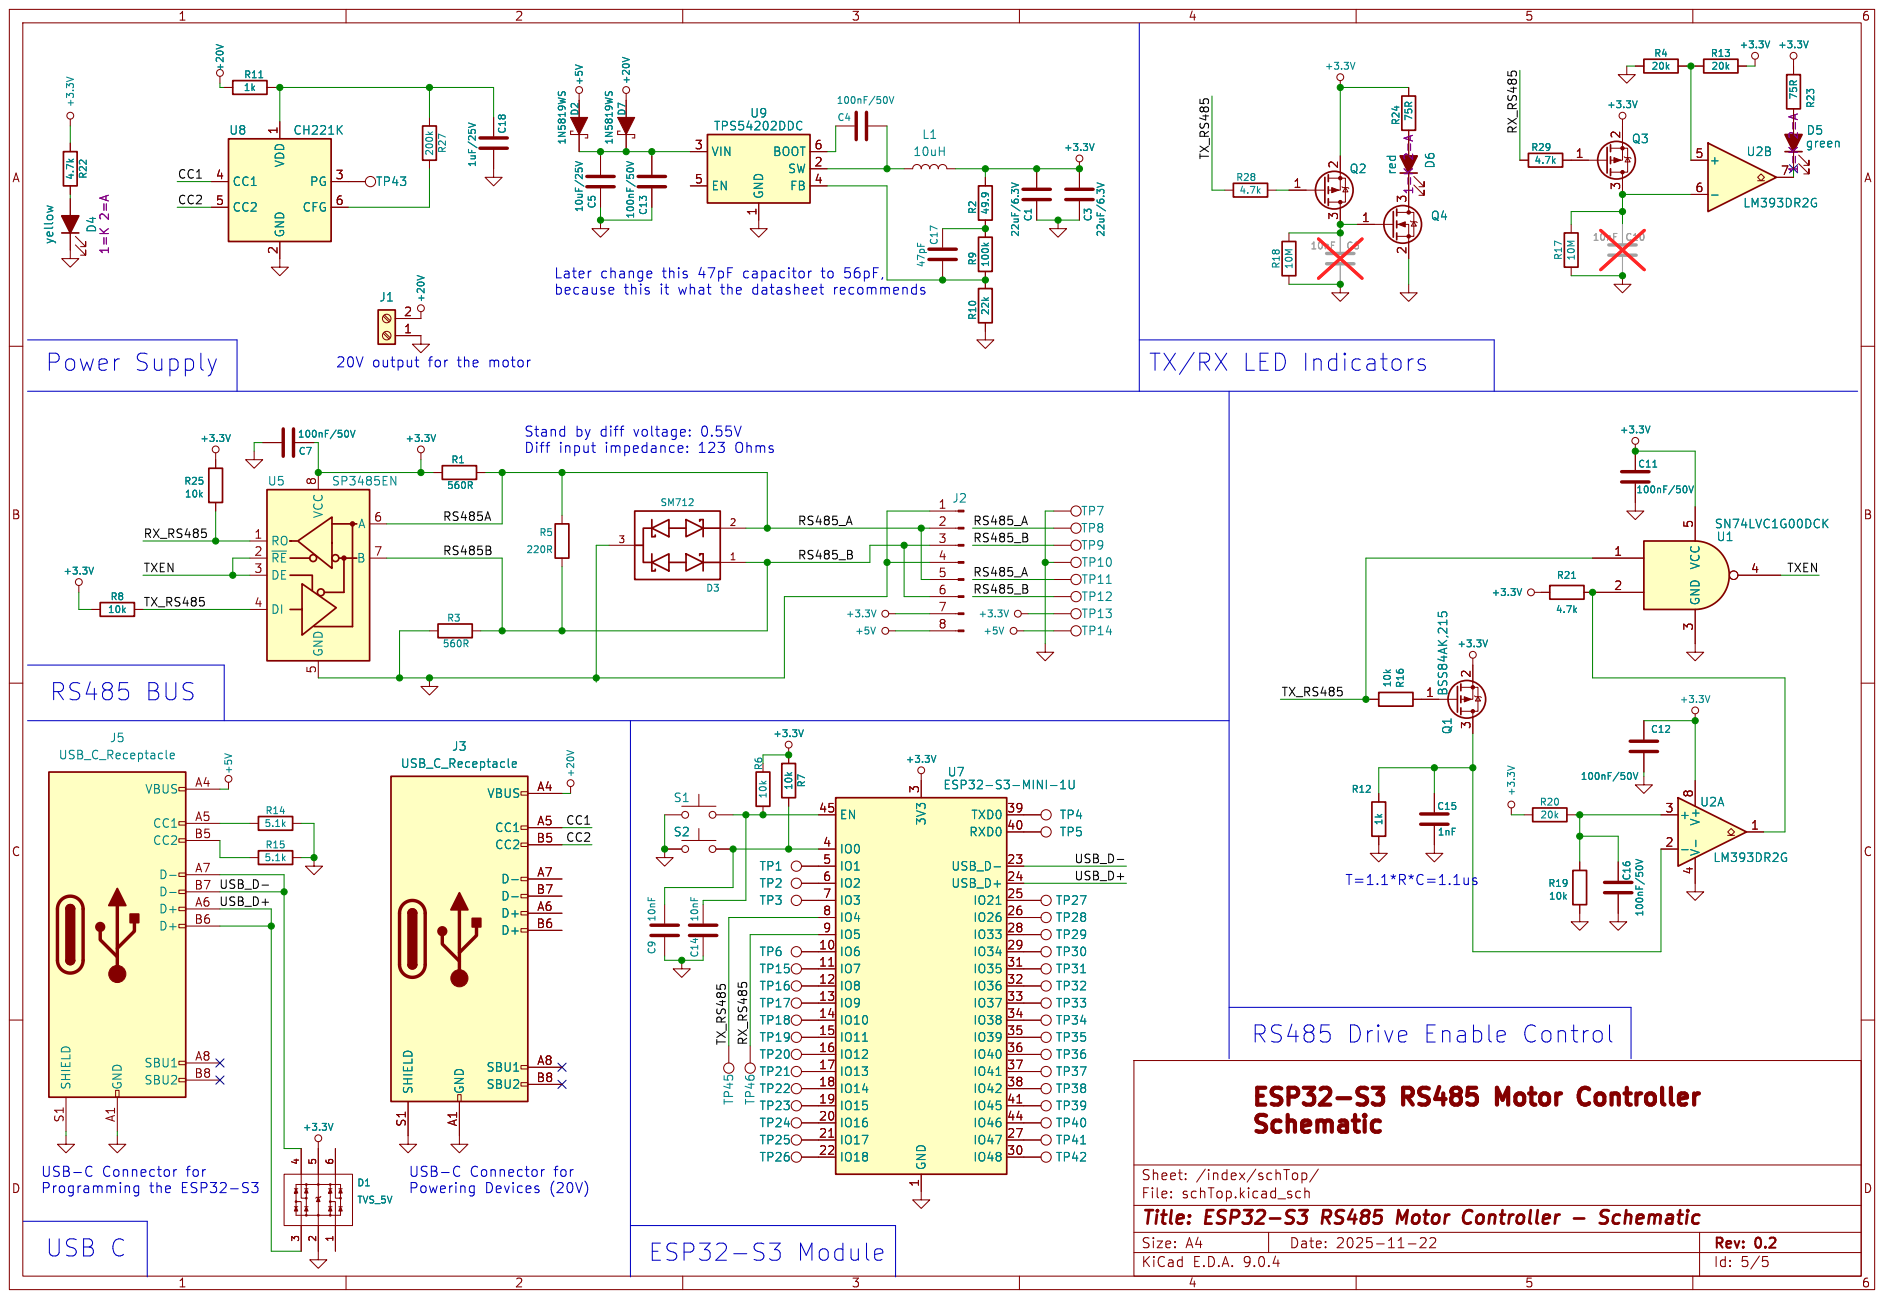
[picture p28: page 1]

TX/RX LED Indicators

File: schTop.kicad_sch Sheet: /index/schTop/
