tomrodinger/RS485_Controller/PCB/0.1/schematic/0.1-index-schTop.pdf

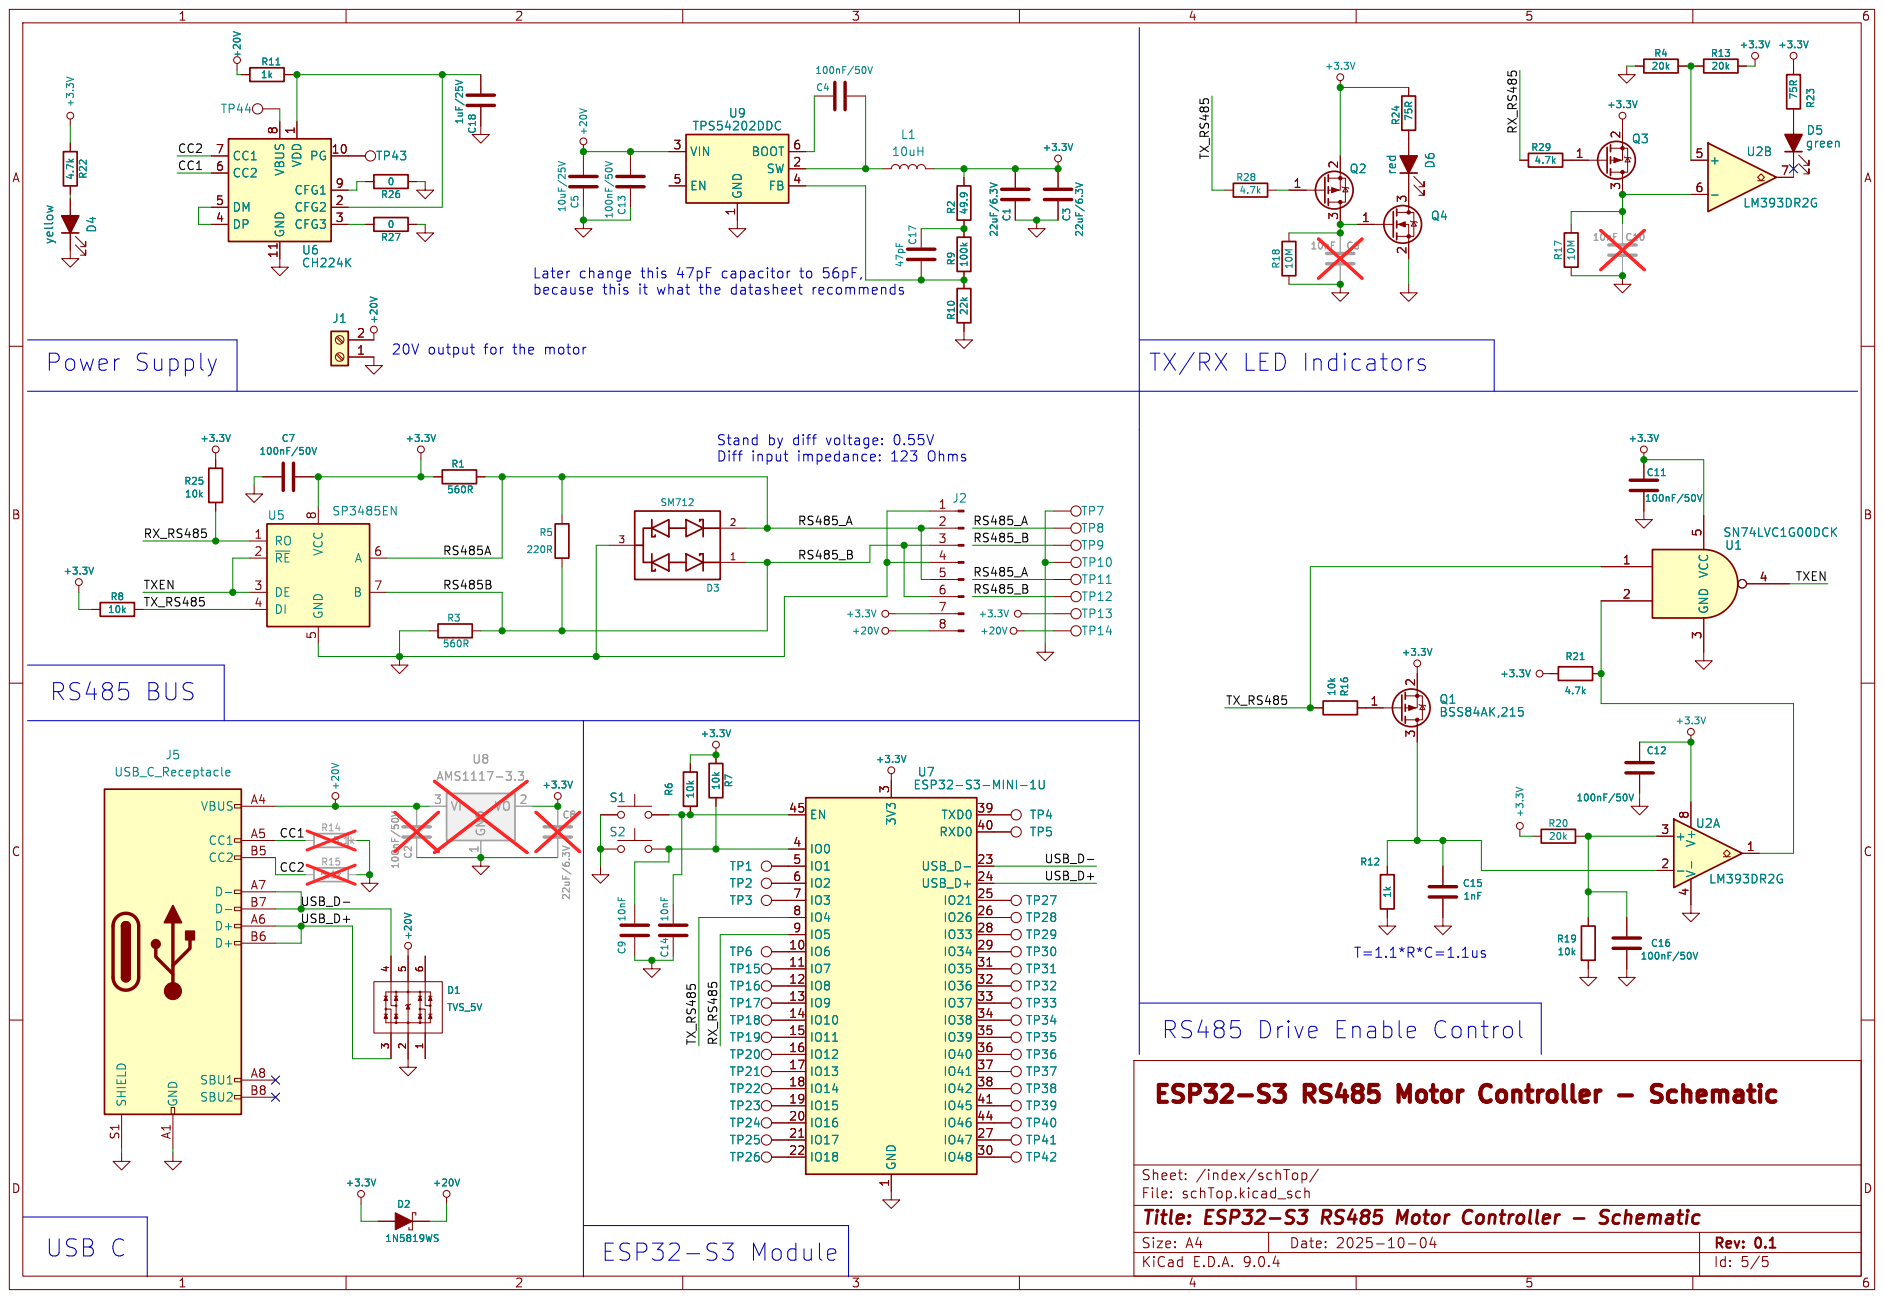
[picture p29: page 1]

File: schTop.kicad_sch Sheet: /index/schTop/ TP5 R5
