tomrodinger/RS485_Controller/(list of files, drawings)

Other design files:
datasheet/assets/technical-v2/pcb-geometry.json
