tomrodinger/RS485_Controller/PCB/V1_not_completed/V1.kicad_pcb

## KiCad design PCB/V1_not_completed/V1.kicad_pcb (2026-11-04)

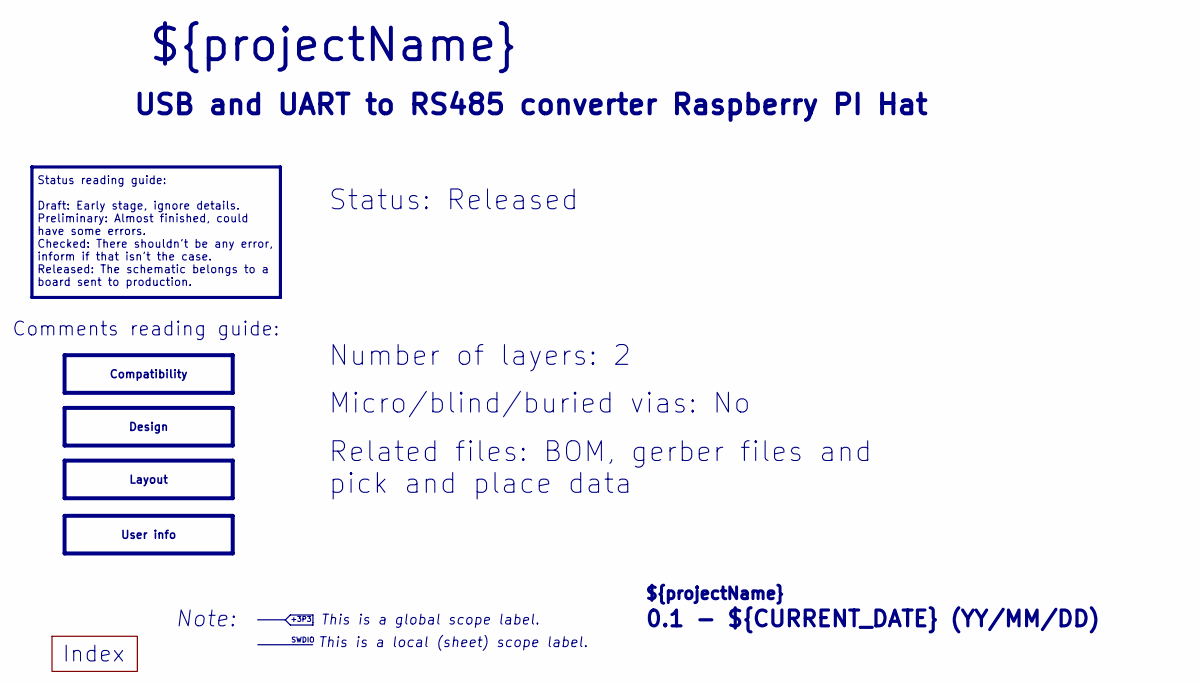
[picture p30: schematic V1.kicad_sch, ${boardName} - ${coverName}]

Notes on the sheet:
${REVISION} - ${CURRENT_DATE} (YY/MM/DD)
Status reading guide: Draft: Early stage, ignore details. Preliminary: Almost finished, could have some errors. Checked: There shouldn't be any error, inform if that isn't the case. Released: The schematic belongs to a board sent to production.
${projectName}
This is a global scope label.
Micro/blind/buried vias: No
Status: Released
Comments reading guide:
Note:
USB and UART to RS485 converter Raspberry PI Hat
Related files: BOM, gerber files and pick and place data
This is a local (sheet) scope label.
SWDIO
Index
+3P3
Number of layers: 2
Design
Compatibility
User info
Layout

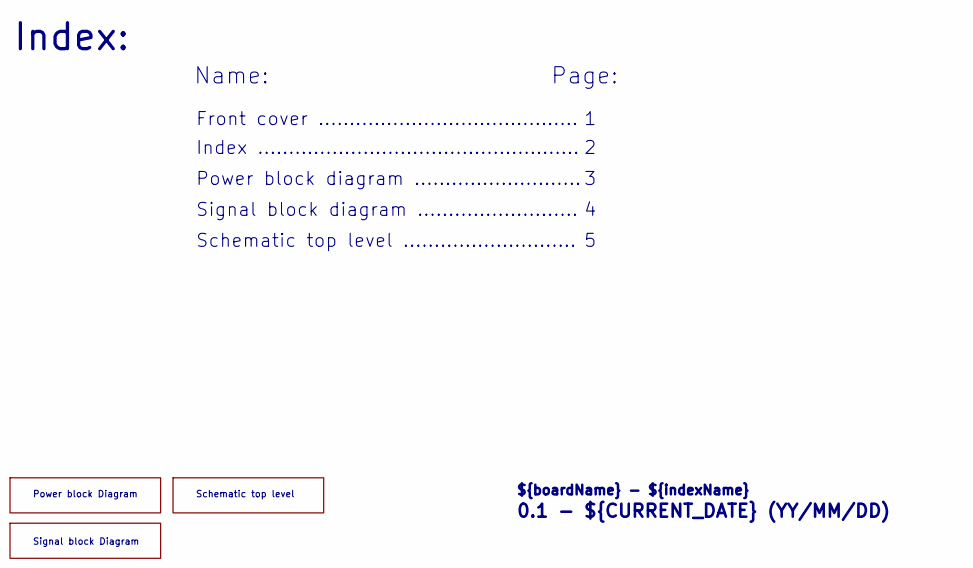
[picture p31: schematic index.kicad_sch, ${boardName} - ${indexName}]

Notes on the sheet:
Power block Diagram
Front cover ..........................................
Schematic top level
${boardName} - ${indexName}
Schematic top level ............................
Index ....................................................
${REVISION} - ${CURRENT_DATE} (YY/MM/DD)
Signal block diagram ..........................
Signal block Diagram
Name:
Page:
Power block diagram ...........................
Index:

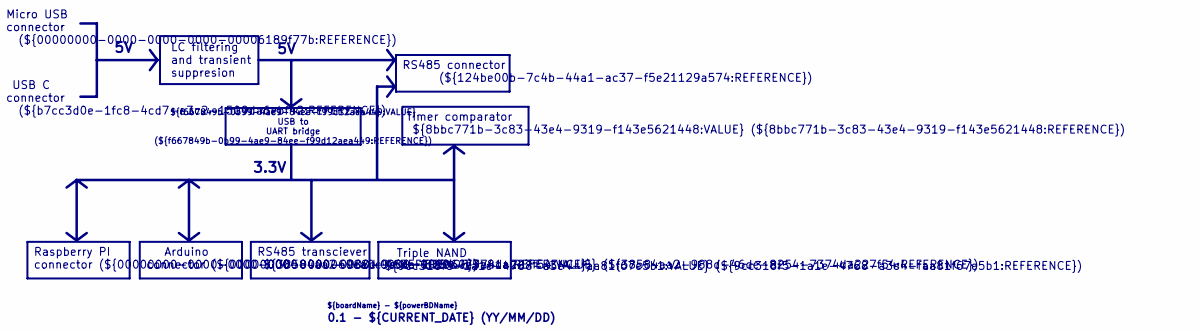
[picture p32: schematic PowerBD.kicad_sch, ${boardName} - ${powerBDName}]

Notes on the sheet:
Arduino connector (${00000000-0000-0000-0000-000060e9a81a:REFERENCE})
RS485 connector (${124be00b-7c4b-44a1-ac37-f5e21129a574:REFERENCE})
Triple NAND ${9cc318f5-1a1e-4768-a3e4-faa81f67e5b1:VALUE} (${9cc318f5-1a1e-4768-a3e4-faa81f67e5b1:REFERENCE})
Raspberry PI connector (${00000000-0000-0000-0000-000060ea0c9e:REFERENCE})
RS485 transciever ${38584aa2-988d-46de-8254-7374da227f54:VALUE} (${38584aa2-988d-46de-8254-7374da227f54:REFERENCE})
LC filtering and transient suppresion
${REVISION} - ${CURRENT_DATE} (YY/MM/DD)
USB C connector (${b7cc3d0e-1fc8-4cd7-a3c2-1509da6ebf42:REFERENCE})
Timer comparator ${8bbc771b-3c83-43e4-9319-f143e5621448:VALUE} (${8bbc771b-3c83-43e4-9319-f143e5621448:REFERENCE})
${boardName} - ${powerBDName}
Micro USB connector (${00000000-0000-0000-0000-00006189f77b:REFERENCE})
3.3V
${f667849b-0b99-4ae9-84ee-f99d12aea449:VALUE} USB to UART bridge (${f667849b-0b99-4ae9-84ee-f99d12aea449:REFERENCE})

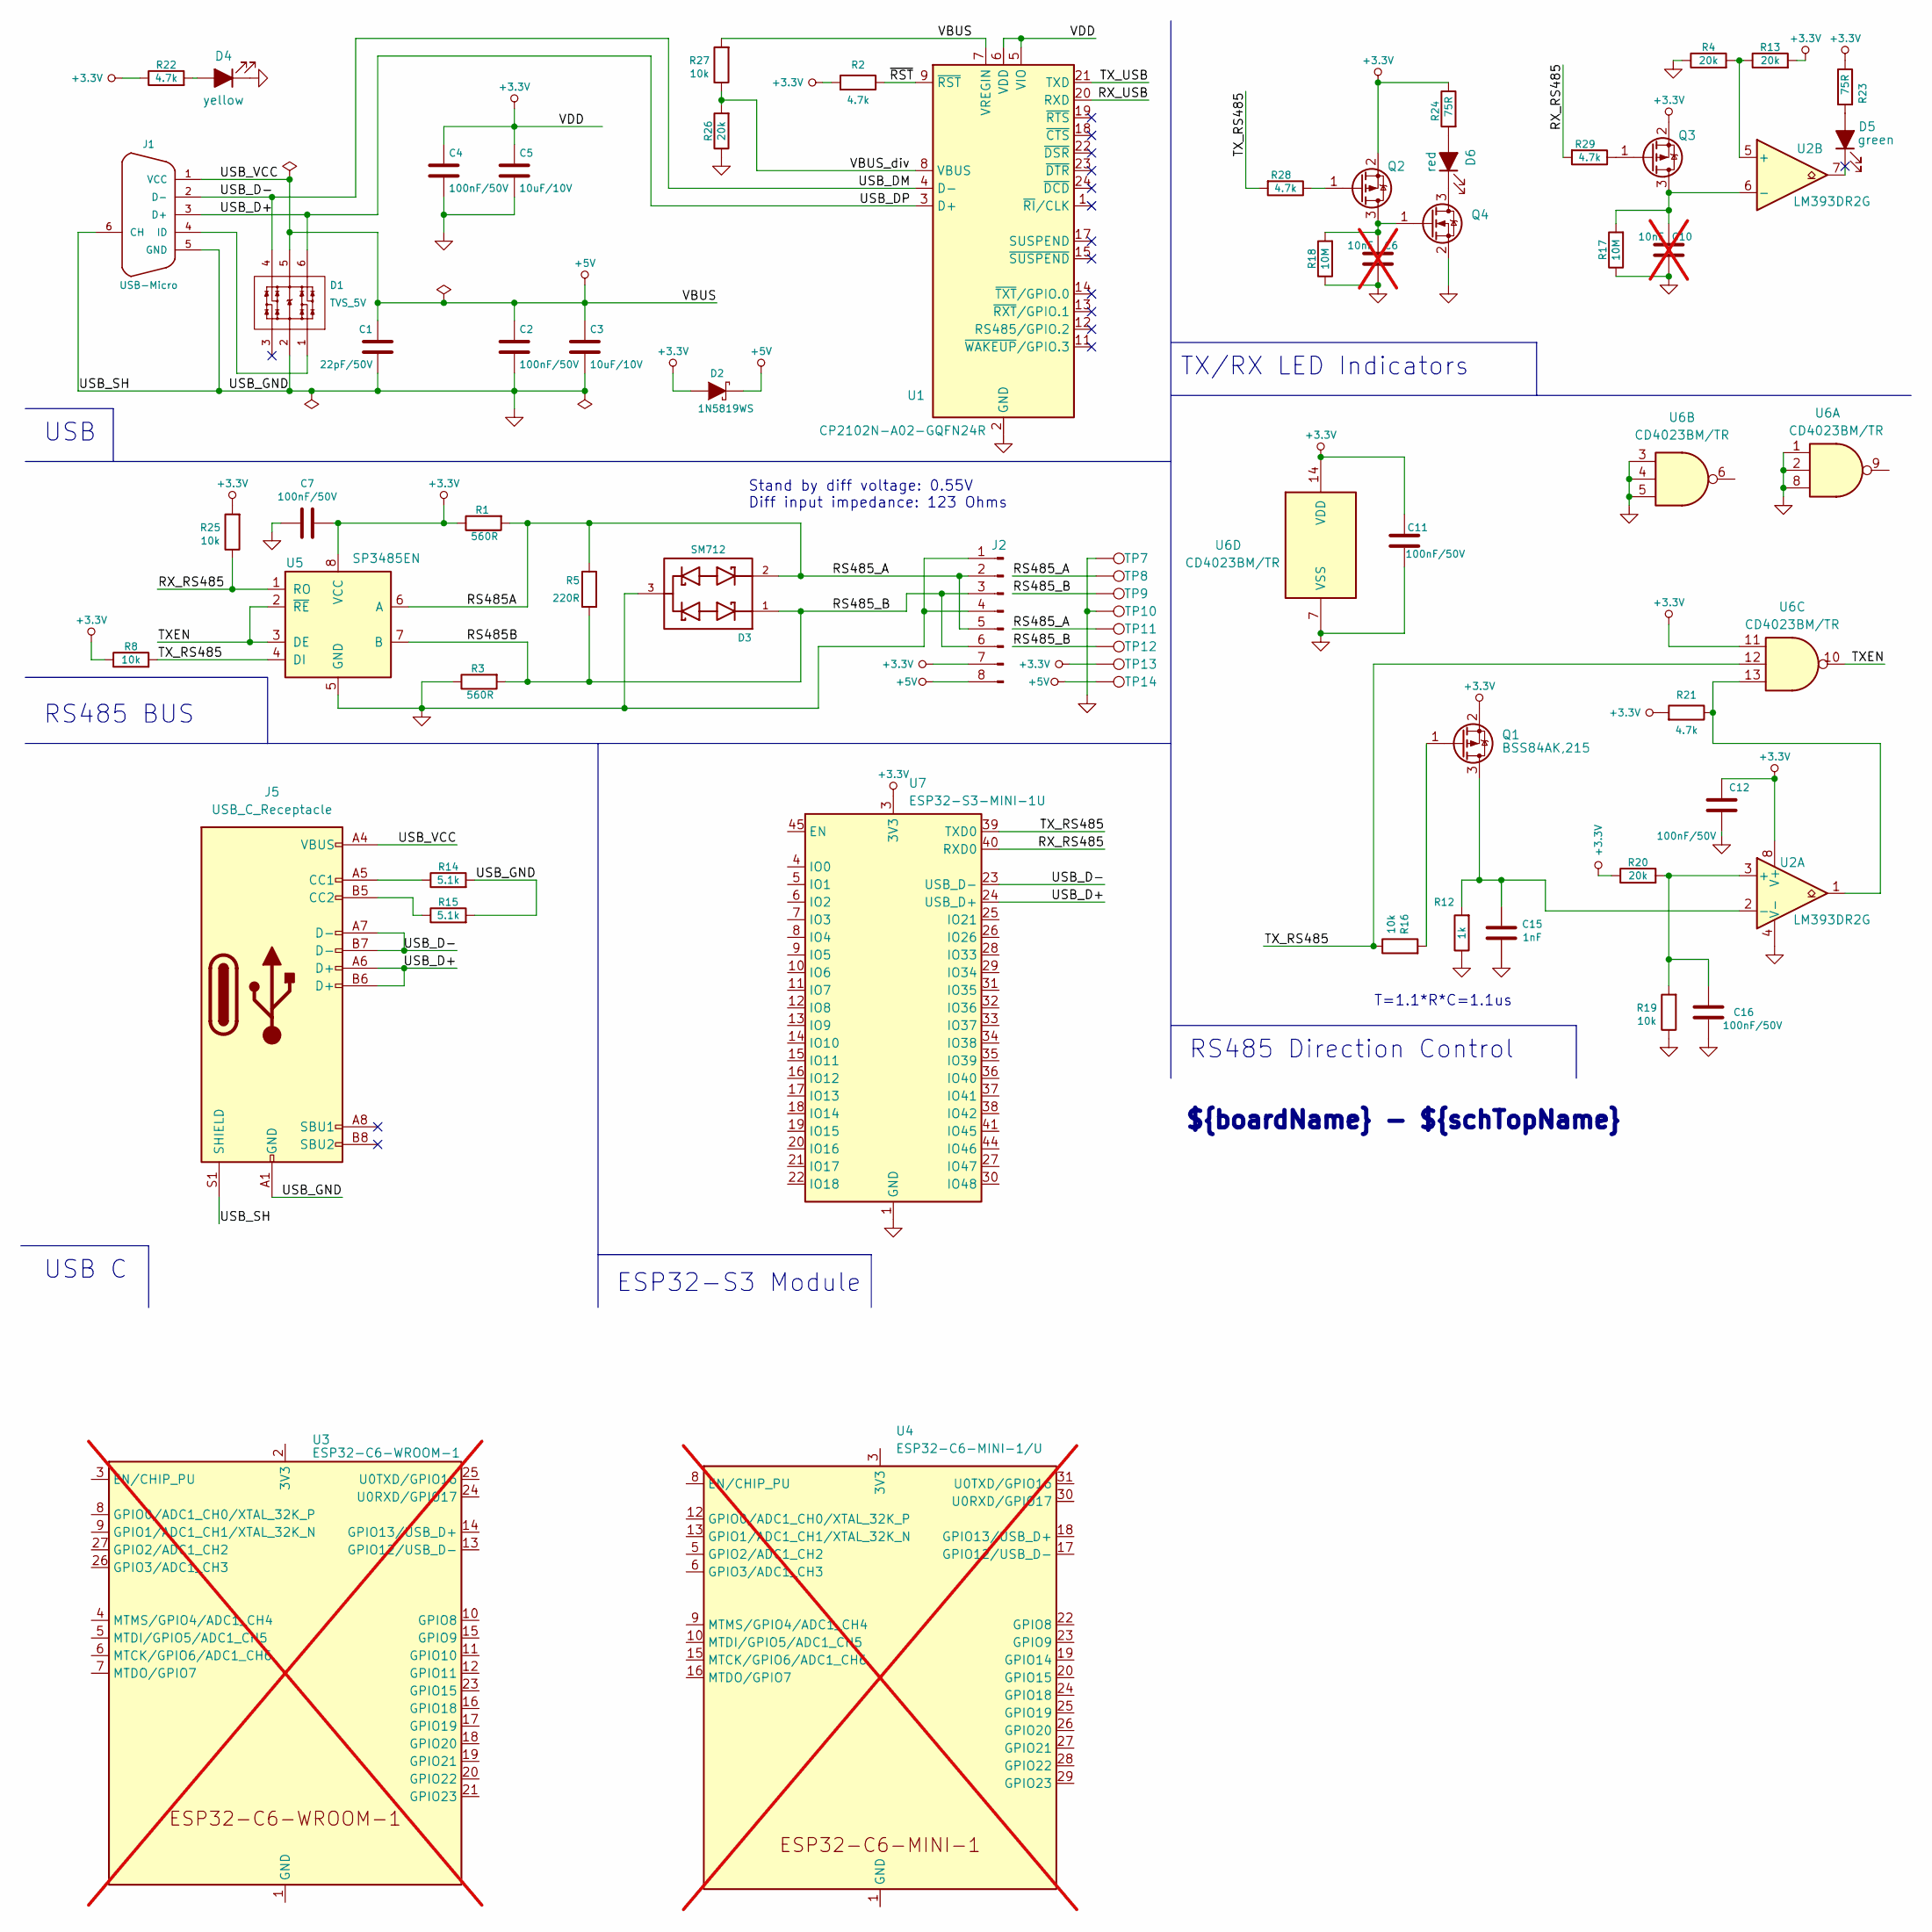
[picture p33: schematic schTop.kicad_sch, ${boardName} - ${schTopName}]

Parts:
C1: 22pF/50V; C_0603_1608Metric; Tolerance 5%; PartNumber CL10C220JB8NNNC; Digikey 1276-1023-1-ND
C2, C4, C7, C11, C12, C16: 100nF/50V; C_0603_1608Metric; Tolerance 10%; PartNumber CC0603KRX7R9BB104; Digikey 1276-6854-1-ND
C3, C5: 10uF/10V; C_0603_1608Metric; Tolerance 10%; PartNumber CL10A106KP8NNNC; LCSC C19702
C6: 10nF; C_0603_1608Metric; Tolerance 10%; PartNumber 0603B103K500NT; LCSC C57112; not fitted
C10: 10nF; C_0603_1608Metric; Tolerance 10%; PartNumber 0603B103K500NT; Digikey ---; not fitted
C15: 1nF; C_0603_1608Metric; Tolerance 10%; PartNumber CL10B102KB8NNNC; LCSC C1588
D1: TVS_5V; SOT23-6L; Tolerance _; PartNumber TPIP4220CZ6; Digikey !1727-2751-1-ND
D2: 1N5819WS; SOD323; LCSC C191023
D3: SM712; SOT23-3; Tolerance _; PartNumber SM712; Digikey !F6450CT-ND
D4: yellow; LED_0805_2012Metric; PartNumber KT-0805Y; LCSC C2296
D5: green; LED_0805_2012Metric; PartNumber KT-0805G; LCSC C2297
D6: red; LED_0805_2012Metric; PartNumber NCD0805R1; LCSC C84256
J1: USB-Micro; usb-MicroXNJ; Tolerance _; PartNumber MicroXNJ; Digikey !732-5961-1-ND
J2: TSM-108-01-T-SH-A-P-TR; SAMTEC_TSM-108-01-T-SH-A-P-TR_hole1.5mm
J5: USB_C_Receptacle; USB_C_Receptacle_Palconn_UTC16-G; LCSC C2765186
Q1, Q2, Q3: BSS84AK,215; SOT-23; Tolerance _; PartNumber BSS84AK,215; Digikey ---
Q4: Q_NMOS_GSD; SOT-23; Part Number 2N7002; LCSC C8545
R1, R3: 560R; R_0603_1608Metric; Tolerance 1%; PartNumber 0603WAF5600T5E; LCSC C23204
R2, R21, R22, R28, R29: 4.7k; R_0603_1608Metric; Tolerance 1%; PartNumber 0603WAF4701T5E; LCSC C23162
R4, R13, R20, R26: 20k; R_0603_1608Metric; Tolerance 1%; PartNumber 0603WAF2002T5E; LCSC C4184
R5: 220R; R_0603_1608Metric; Tolerance 5%; PartNumber 0603WAF2200T5E; LCSC C22962
R8, R16, R19, R25, R27: 10k; R_0603_1608Metric; Tolerance 1%; PartNumber 0603WAF1002T5E; LCSC C25804
R12: 1k; R_0603_1608Metric; Tolerance 1%; PartNumber 0603WAF1001T5E; Digikey 311-1.00KHRCT-ND
R14, R15: 5.1k; R_0402_1005Metric; Tolerance 1%; LCSC C25905
R17, R18: 10M; R_0603_1608Metric; PartNumber 0603WAF1005T5E; LCSC C7250
R23, R24: 75R; R_0603_1608Metric; Tolerance 1%; PartNumber 0603WAF750JT5E; LCSC C4275
TP7, TP8, TP9, TP10, TP11, TP12, TP13, TP14: TestPoint; testpoint_no_border
U1: CP2102N-A02-GQFN24R; QFN-24-1EP_4x4mm_P0.5mm_EP2.6x2.6mm; Tolerance _; PartNumber CP2102N-A02-GQFN24R; Digikey _
U2: LM393DR2G; SOIC-8_3.9x4.9mm_P1.27mm; Tolerance _; PartNumber LM393DR2G; Digikey _
U3: ESP32-C6-WROOM-1; not fitted
U4: ESP32-C6-MINI-1/U; ESP32-C6-MINI-1; not fitted
U5: SP3485EN; SOIC-8_3.9x4.9mm_P1.27mm; Tolerance _; PartNumber SP3485EN-L/TR; LCSC C8963
U6: CD4023BM/TR; SOIC-14_3.9x8.7mm_P1.27mm; Tolerance _; PartNumber CD4023BM/TR; Digikey _
U7: ESP32-S3-MINI-1U; ESP32-S2-MINI-1U

Connections:
+3.3V: C4.1, C5.1, C7.2, C11.2, C12.2, D2.1 (A), J2.7, Q1.2 (S), Q2.2 (S), Q3.2 (S), R1.1, R2.2, R8.1, R13.2, R20.1, R21.2, R22.1, R23.1, R24.1, R25.2, TP13.1, U1.5 (VIO), U1.6 (VDD), U2.8 (V+), U5.8 (VCC), U6.11, U6.14 (VDD), U7.3 (3V3); also elsewhere on the board
+5V: C1.1, C2.1, C3.1, D1.5 (VDD), D2.2 (K), J1.1 (VCC), J2.8, J5.A4 (VBUS), J5.A9 (VBUS), J5.B4 (VBUS), J5.B9 (VBUS), R27.2, TP14.1, U1.7 (VREGIN)
/index/schTop/RS485A: D3.2 (cathode), J2.2, J2.5, R1.2, R5.1, TP8.1, TP11.1, U5.6 (A)
/index/schTop/RS485B: D3.1 (Anode), J2.3, J2.6, R3.2, R5.2, TP9.1, TP12.1, U5.7 (B)
/index/schTop/RX_RS485: R25.1, R29.2, U5.1 (RO), U7.40 (RXD0)
/index/schTop/RX_USB: U1.20 (RXD)
/index/schTop/TXEN: U5.2 (~RE), U5.3 (DE), U6.10
/index/schTop/TX_RS485: R8.2, R16.1, R28.2, U5.4 (DI), U6.12, U7.39 (TXD0)
/index/schTop/TX_USB: U1.21 (TXD)
/index/schTop/USB_D+: D1.6 (IO4), J1.3 (D+), J5.A6 (D+), J5.B6 (D+), U1.3 (D+), U7.24 (USB_D+)
/index/schTop/USB_D-: D1.4 (IO3), J1.2 (D-), J5.A7 (D-), J5.B7 (D-), U1.4 (D-), U7.23 (USB_D-)
/index/schTop/VBUS_div: R26.2, R27.1, U1.8 (VBUS)
/index/schTop/~RST: R2.1, U1.9 (~RST)
GND: C1.2, C2.2, C3.2, C4.2, C5.2, C6.1, C7.1, C10.1, C11.1, C12.1, C15.1, C16.1, D1.2 (GND), D3.3 (AK), D4.1 (K), J1.5 (GND), J1.6 (CH), J2.1, J2.4, J5.A1 (GND), J5.A12 (GND), J5.B1 (GND), J5.B12 (GND), J5.S1 (SHIELD), Q4.2 (S), R3.1, R4.1, R12.1, R14.2, R15.2, R17.1, R18.1, R19.1, R26.1, TP7.1, TP10.1, U1.2 (GND), U1.25 (GND), U2.4 (V-), U5.5 (GND), U6.1, U6.2, U6.3, U6.4, U6.5, U6.7 (VSS), U6.8, U7.1 (GND), U7.2 (GND), U7.42 (GND), U7.43 (GND), U7.46 (GND), U7.47 (GND), U7.48 (GND), U7.49 (GND), U7.50 (GND), U7.51 (GND), U7.52 (GND), U7.53 (GND), U7.54 (GND), U7.55 (GND), U7.56 (GND), U7.57 (GND), U7.58 (GND), U7.59 (GND), U7.60 (GND), U7.61 (GND), U7.62 (GND), U7.63 (GND), U7.64 (GND), U7.65 (GND); also elsewhere on the board
unnamed: D1.1 (IO1), J1.4 (ID)
unnamed: D4.2 (A), R22.2
unnamed: D5.2 (A), R23.2
unnamed: D6.2 (A), R24.2
unnamed: D6.1 (K), Q4.3 (D)
unnamed: J5.A5 (CC1), R14.1
unnamed: J5.B5 (CC2), R15.1
unnamed: C15.2, Q1.3 (D), R12.2, U2.2 (-)
unnamed: Q1.1 (G), R16.2
unnamed: C6.2, Q2.3 (D), Q4.1 (G), R18.2
unnamed: Q2.1 (G), R28.1
unnamed: C10.2, Q3.3 (D), R17.2, U2.6 (-)
unnamed: Q3.1 (G), R29.1
unnamed: R21.1, U2.1, U6.13
unnamed: C16.2, R19.2, R20.2, U2.3 (+)
unnamed: R4.2, R13.1, U2.5 (+)
unnamed: U3.1 (GND), U3.28 (GND), U3.29 (GND)
unnamed: U4.1 (GND), U4.2 (GND), U4.11 (GND), U4.14 (GND), U4.36 (GND), U4.37 (GND), U4.38 (GND), U4.39 (GND), U4.40 (GND), U4.41 (GND), U4.42 (GND), U4.43 (GND), U4.44 (GND), U4.45 (GND), U4.46 (GND), U4.47 (GND), U4.48 (GND), U4.49 (GND), U4.50 (GND), U4.51 (GND), U4.52 (GND), U4.53 (GND)

Notes on the sheet:
Stand by diff voltage: 0.55V Diff input impedance: 123 Ohms
RS485 BUS
T=1.1*R*C=1.1us
TX/RX LED Indicators
USB C
USB
RS485 Direction Control
${boardName} - ${schTopName}
ESP32-S3 Module

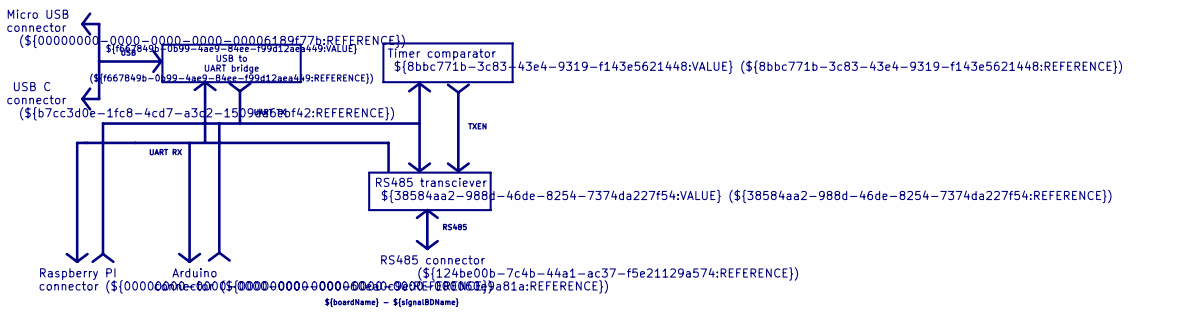
[picture p34: schematic signalBD.kicad_sch, ${boardName} - ${signalBDName}]

Notes on the sheet:
RS485 transciever ${38584aa2-988d-46de-8254-7374da227f54:VALUE} (${38584aa2-988d-46de-8254-7374da227f54:REFERENCE})
${boardName} - ${signalBDName}
RS485 connector (${124be00b-7c4b-44a1-ac37-f5e21129a574:REFERENCE})
Raspberry PI connector (${00000000-0000-0000-0000-000060ea0c9e:REFERENCE})
UART TX
USB C connector (${b7cc3d0e-1fc8-4cd7-a3c2-1509da6ebf42:REFERENCE})
UART RX
RS485
TXEN
USB
Timer comparator ${8bbc771b-3c83-43e4-9319-f143e5621448:VALUE} (${8bbc771b-3c83-43e4-9319-f143e5621448:REFERENCE})
Arduino connector (${00000000-0000-0000-0000-000060e9a81a:REFERENCE})
Micro USB connector (${00000000-0000-0000-0000-00006189f77b:REFERENCE})
${f667849b-0b99-4ae9-84ee-f99d12aea449:VALUE} USB to UART bridge (${f667849b-0b99-4ae9-84ee-f99d12aea449:REFERENCE})

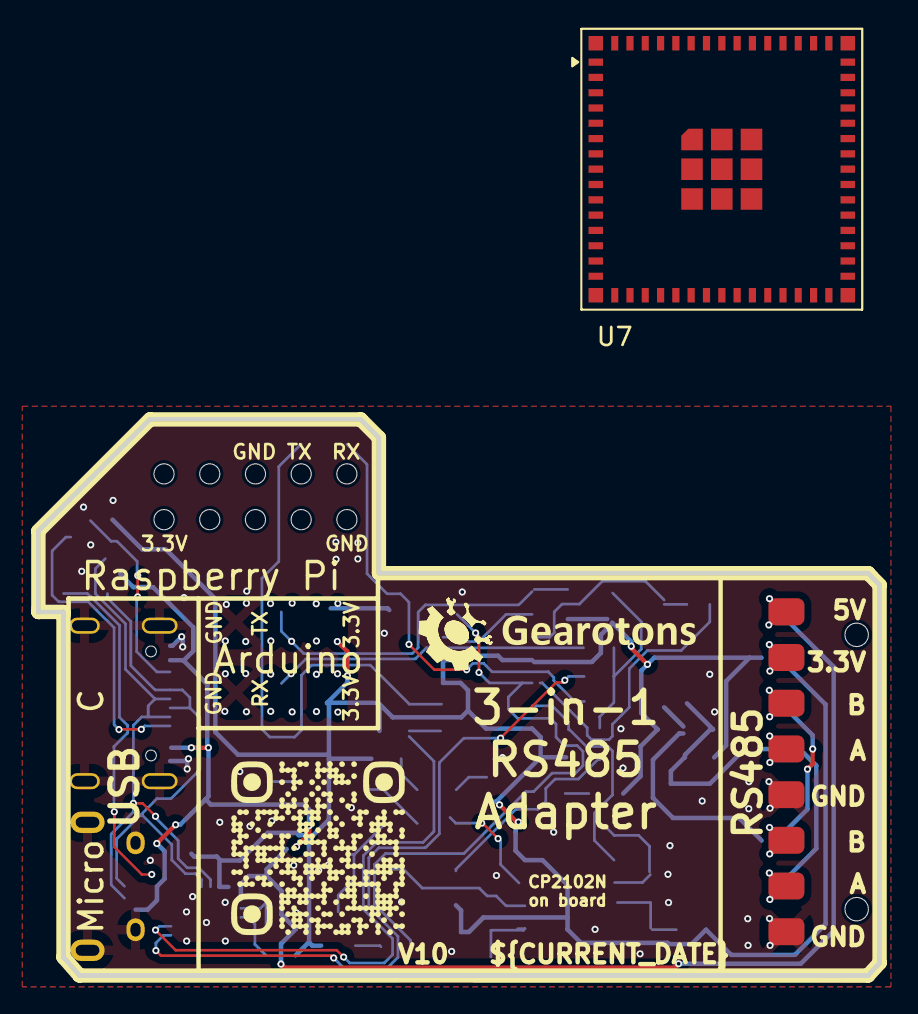
[picture p35: board V1.kicad_pcb from above]

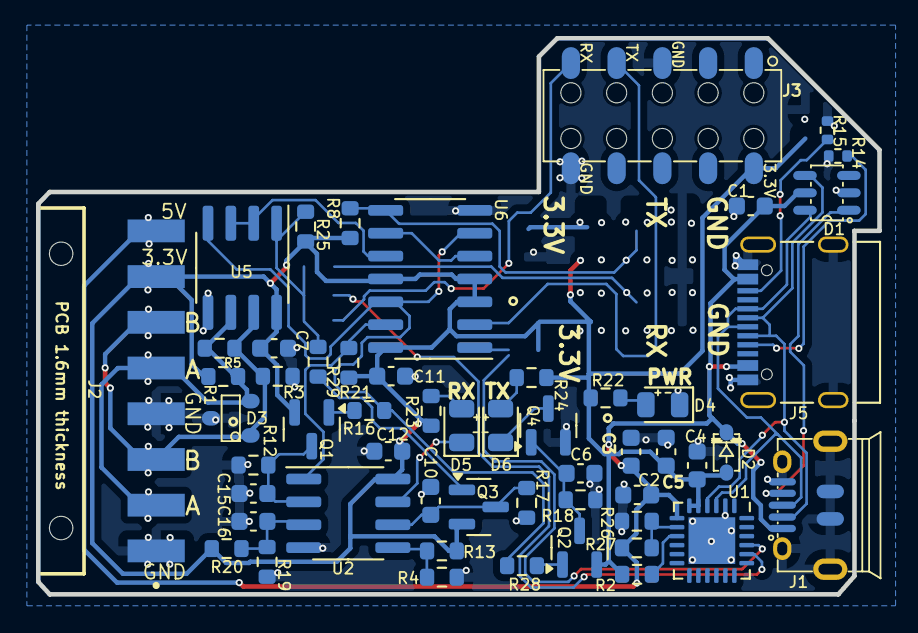
[picture p36: board V1.kicad_pcb from below]

Board: 2 copper layers, 46.7 x 30.9 mm, 63 parts (54 on the bottom side), 28 nets.

Other parts of the board:
J3: Raspberry-Pi_2x5-Pin_Header; con-WR-PHD-61031021821

Their connections:
+3.3V: J3.2 (3.3V); also elsewhere on the board
GND: J3.5 (GND), J3.10 (GND); also elsewhere on the board
