tomrodinger/RS485_Controller/PCB/0.5/0.5.kicad_pcb

## KiCad design PCB/0.5/0.5.kicad_pcb (2026-10-26)

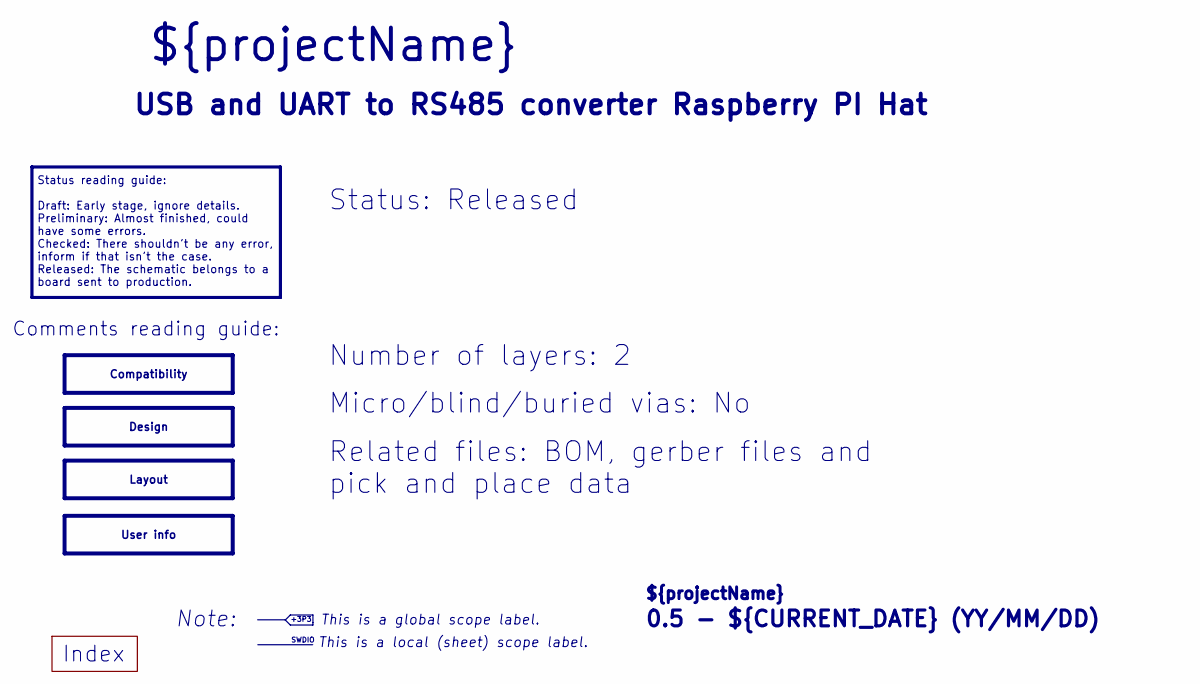
[picture p37: schematic 0.5.kicad_sch, ${boardName} - ${coverName}]

Notes on the sheet:
${REVISION} - ${CURRENT_DATE} (YY/MM/DD)
Status reading guide: Draft: Early stage, ignore details. Preliminary: Almost finished, could have some errors. Checked: There shouldn't be any error, inform if that isn't the case. Released: The schematic belongs to a board sent to production.
${projectName}
This is a global scope label.
Micro/blind/buried vias: No
Status: Released
Comments reading guide:
Note:
USB and UART to RS485 converter Raspberry PI Hat
Related files: BOM, gerber files and pick and place data
This is a local (sheet) scope label.
SWDIO
Index
+3P3
Number of layers: 2
Design
Compatibility
User info
Layout

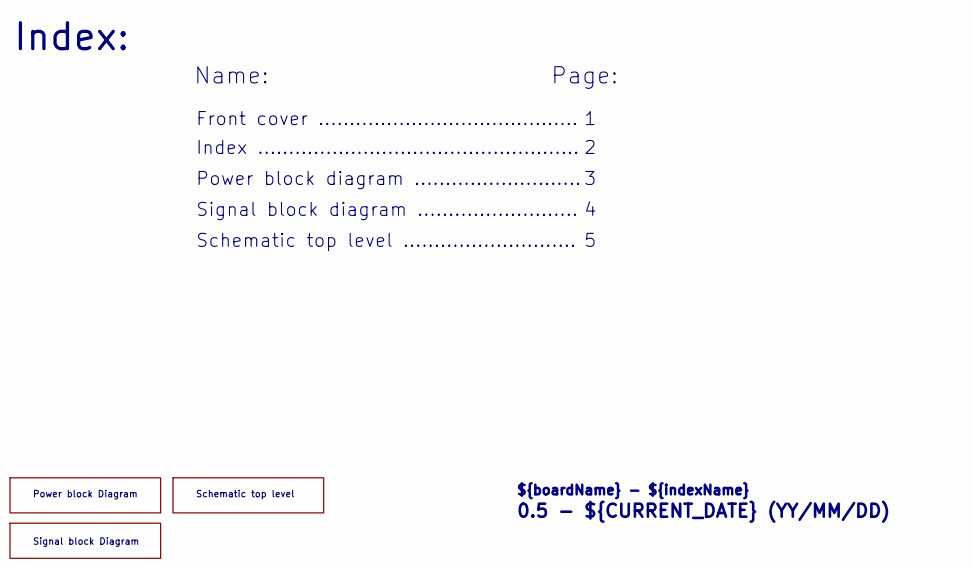
[picture p38: schematic index.kicad_sch, ${boardName} - ${indexName}]

Notes on the sheet:
Power block Diagram
Front cover ..........................................
Schematic top level
${boardName} - ${indexName}
Schematic top level ............................
Index ....................................................
${REVISION} - ${CURRENT_DATE} (YY/MM/DD)
Signal block diagram ..........................
Signal block Diagram
Name:
Page:
Power block diagram ...........................
Index:

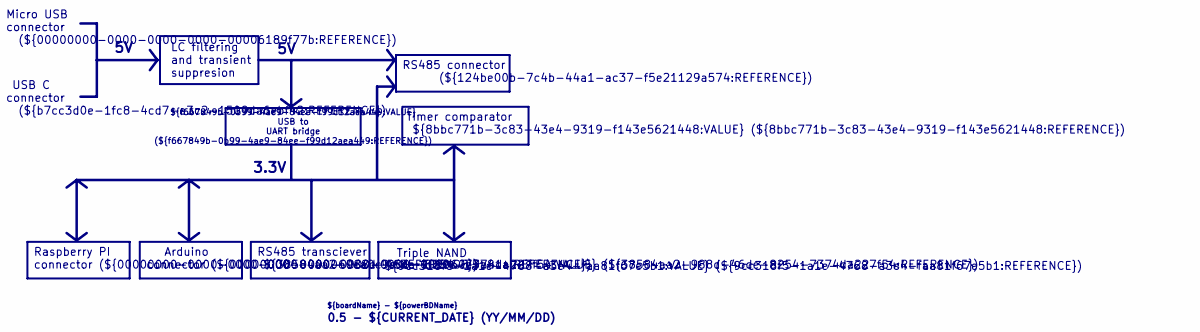
[picture p39: schematic PowerBD.kicad_sch, ${boardName} - ${powerBDName}]

Notes on the sheet:
Arduino connector (${00000000-0000-0000-0000-000060e9a81a:REFERENCE})
RS485 connector (${124be00b-7c4b-44a1-ac37-f5e21129a574:REFERENCE})
Triple NAND ${9cc318f5-1a1e-4768-a3e4-faa81f67e5b1:VALUE} (${9cc318f5-1a1e-4768-a3e4-faa81f67e5b1:REFERENCE})
Raspberry PI connector (${00000000-0000-0000-0000-000060ea0c9e:REFERENCE})
RS485 transciever ${38584aa2-988d-46de-8254-7374da227f54:VALUE} (${38584aa2-988d-46de-8254-7374da227f54:REFERENCE})
LC filtering and transient suppresion
${REVISION} - ${CURRENT_DATE} (YY/MM/DD)
USB C connector (${b7cc3d0e-1fc8-4cd7-a3c2-1509da6ebf42:REFERENCE})
Timer comparator ${8bbc771b-3c83-43e4-9319-f143e5621448:VALUE} (${8bbc771b-3c83-43e4-9319-f143e5621448:REFERENCE})
${boardName} - ${powerBDName}
Micro USB connector (${00000000-0000-0000-0000-00006189f77b:REFERENCE})
3.3V
${f667849b-0b99-4ae9-84ee-f99d12aea449:VALUE} USB to UART bridge (${f667849b-0b99-4ae9-84ee-f99d12aea449:REFERENCE})
