tomrodinger/RS485_Controller/PCB/0.5/0.5.kicad_pcb

## KiCad design PCB/0.5/0.5.kicad_pcb (continued)

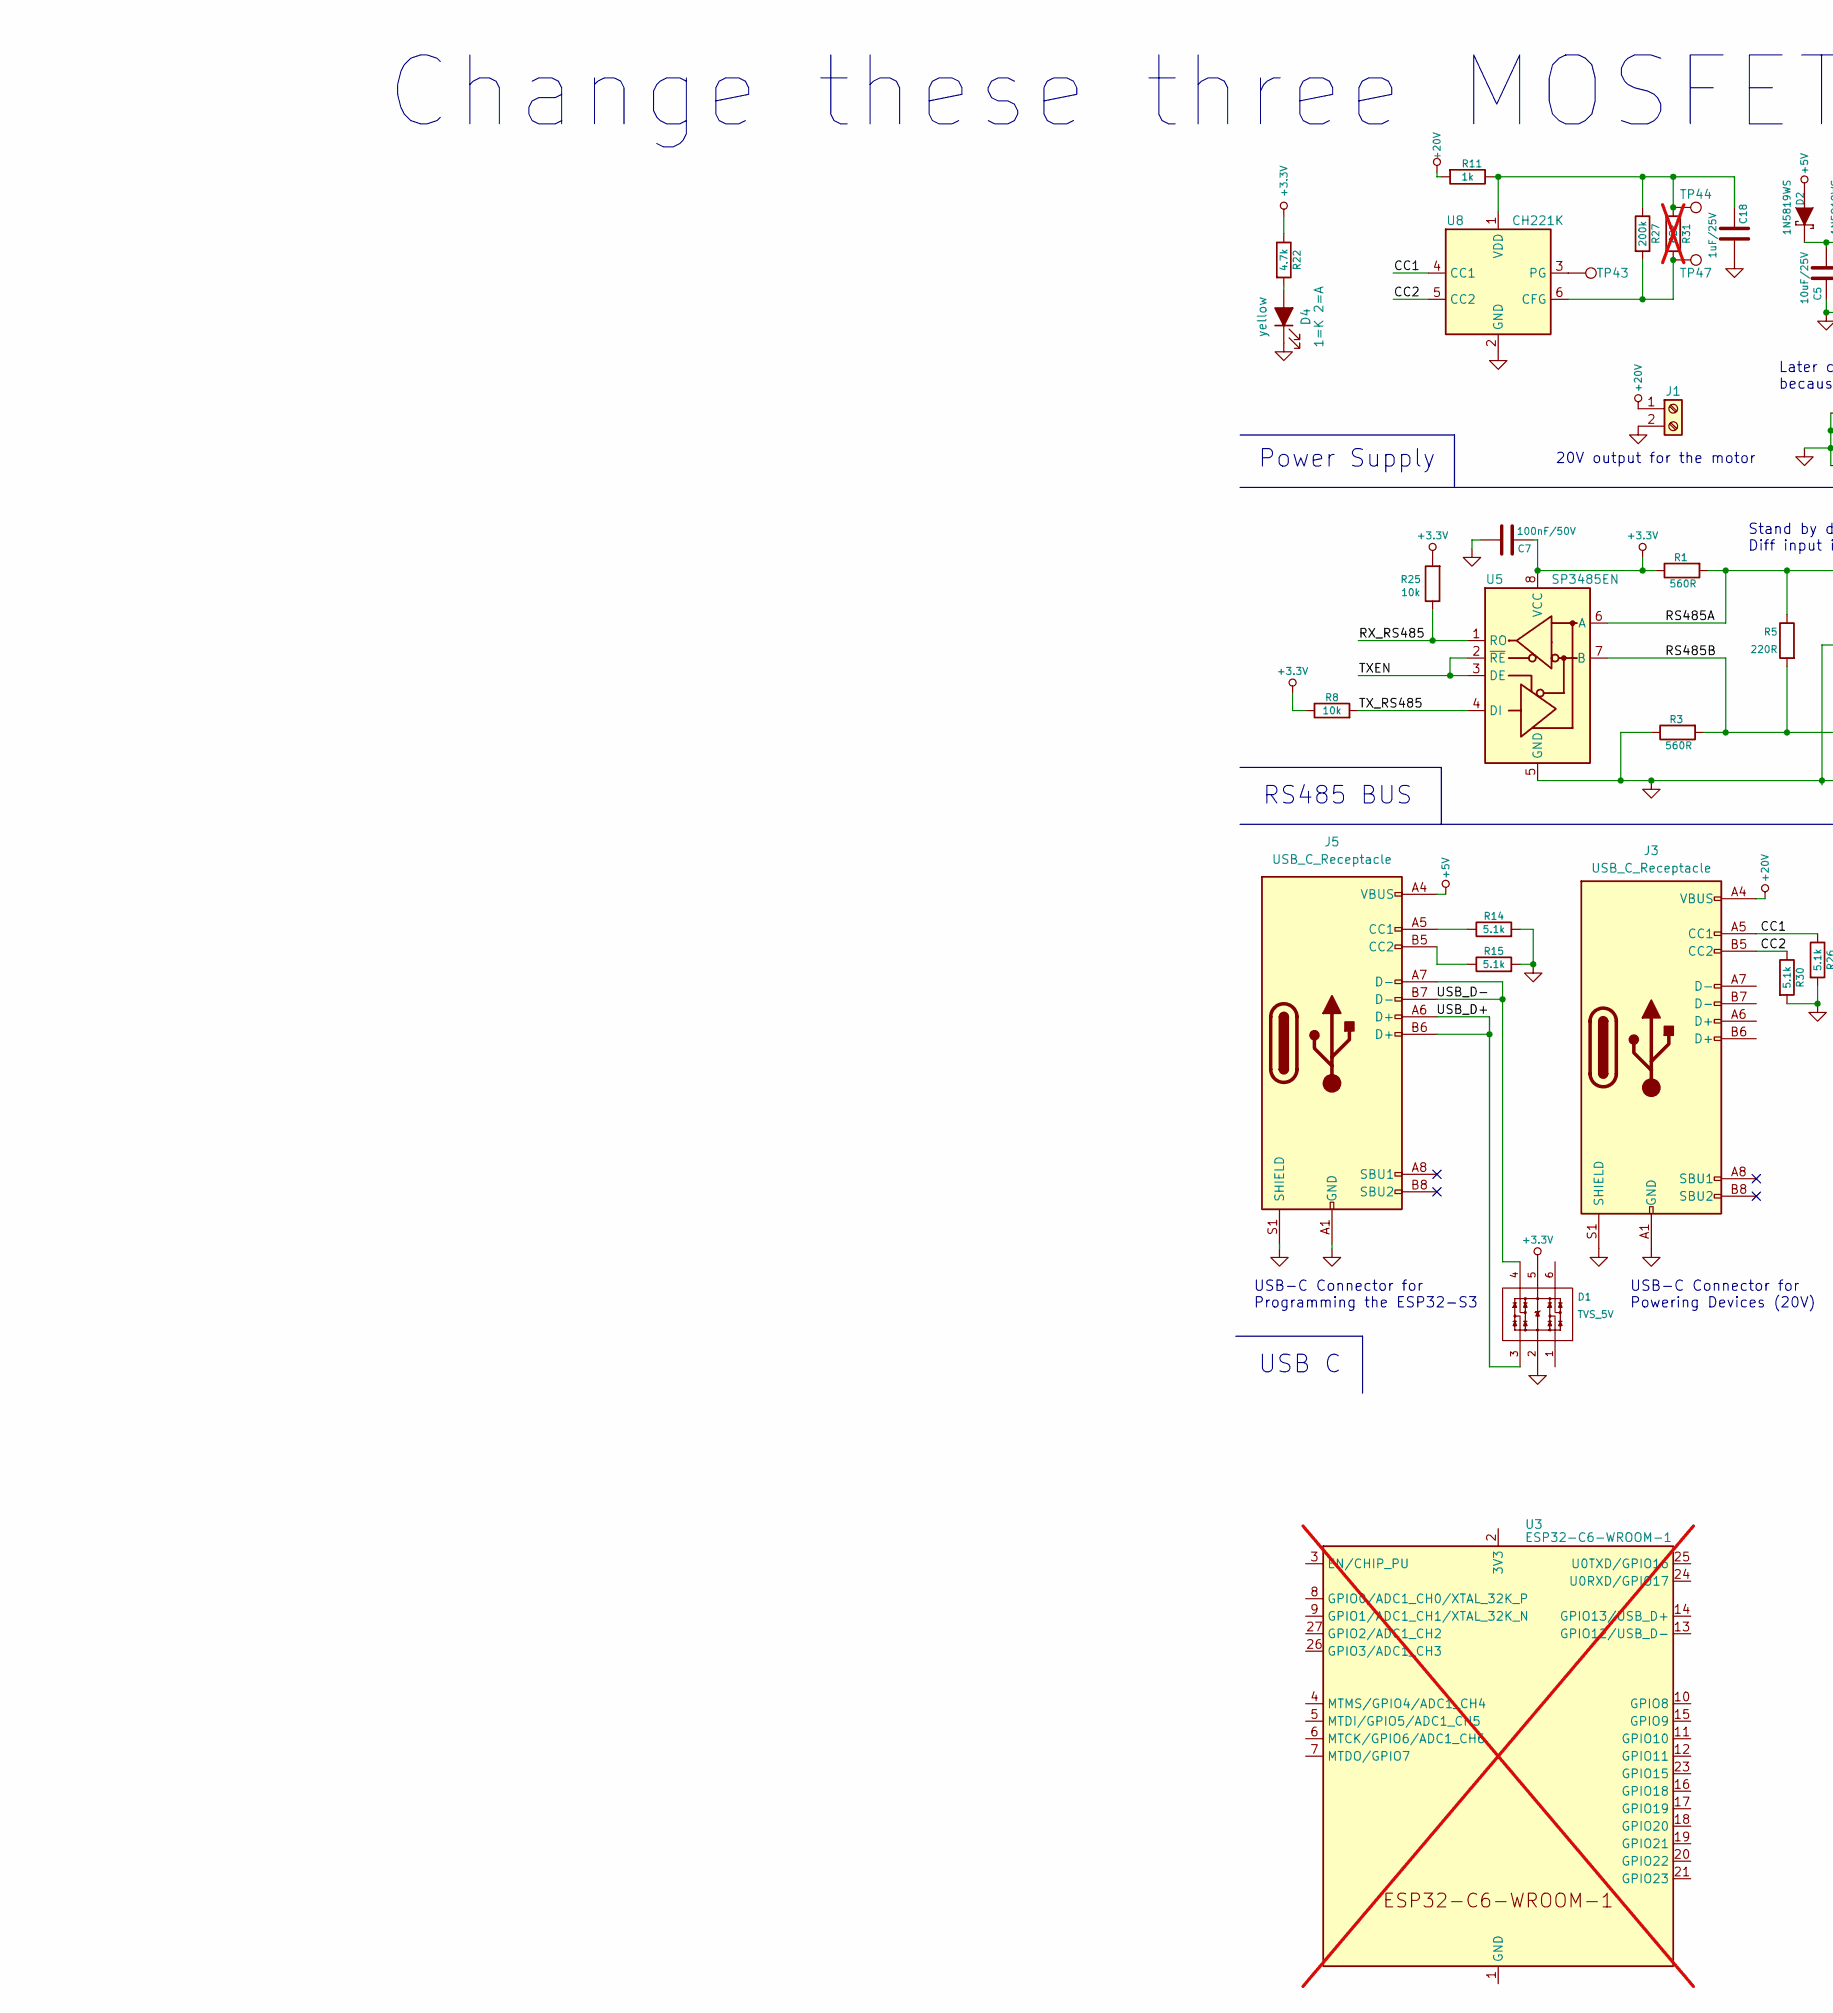
[picture p40: schematic schTop.kicad_sch, ${boardName} - ${schTopName}, part in row 1, column 1]

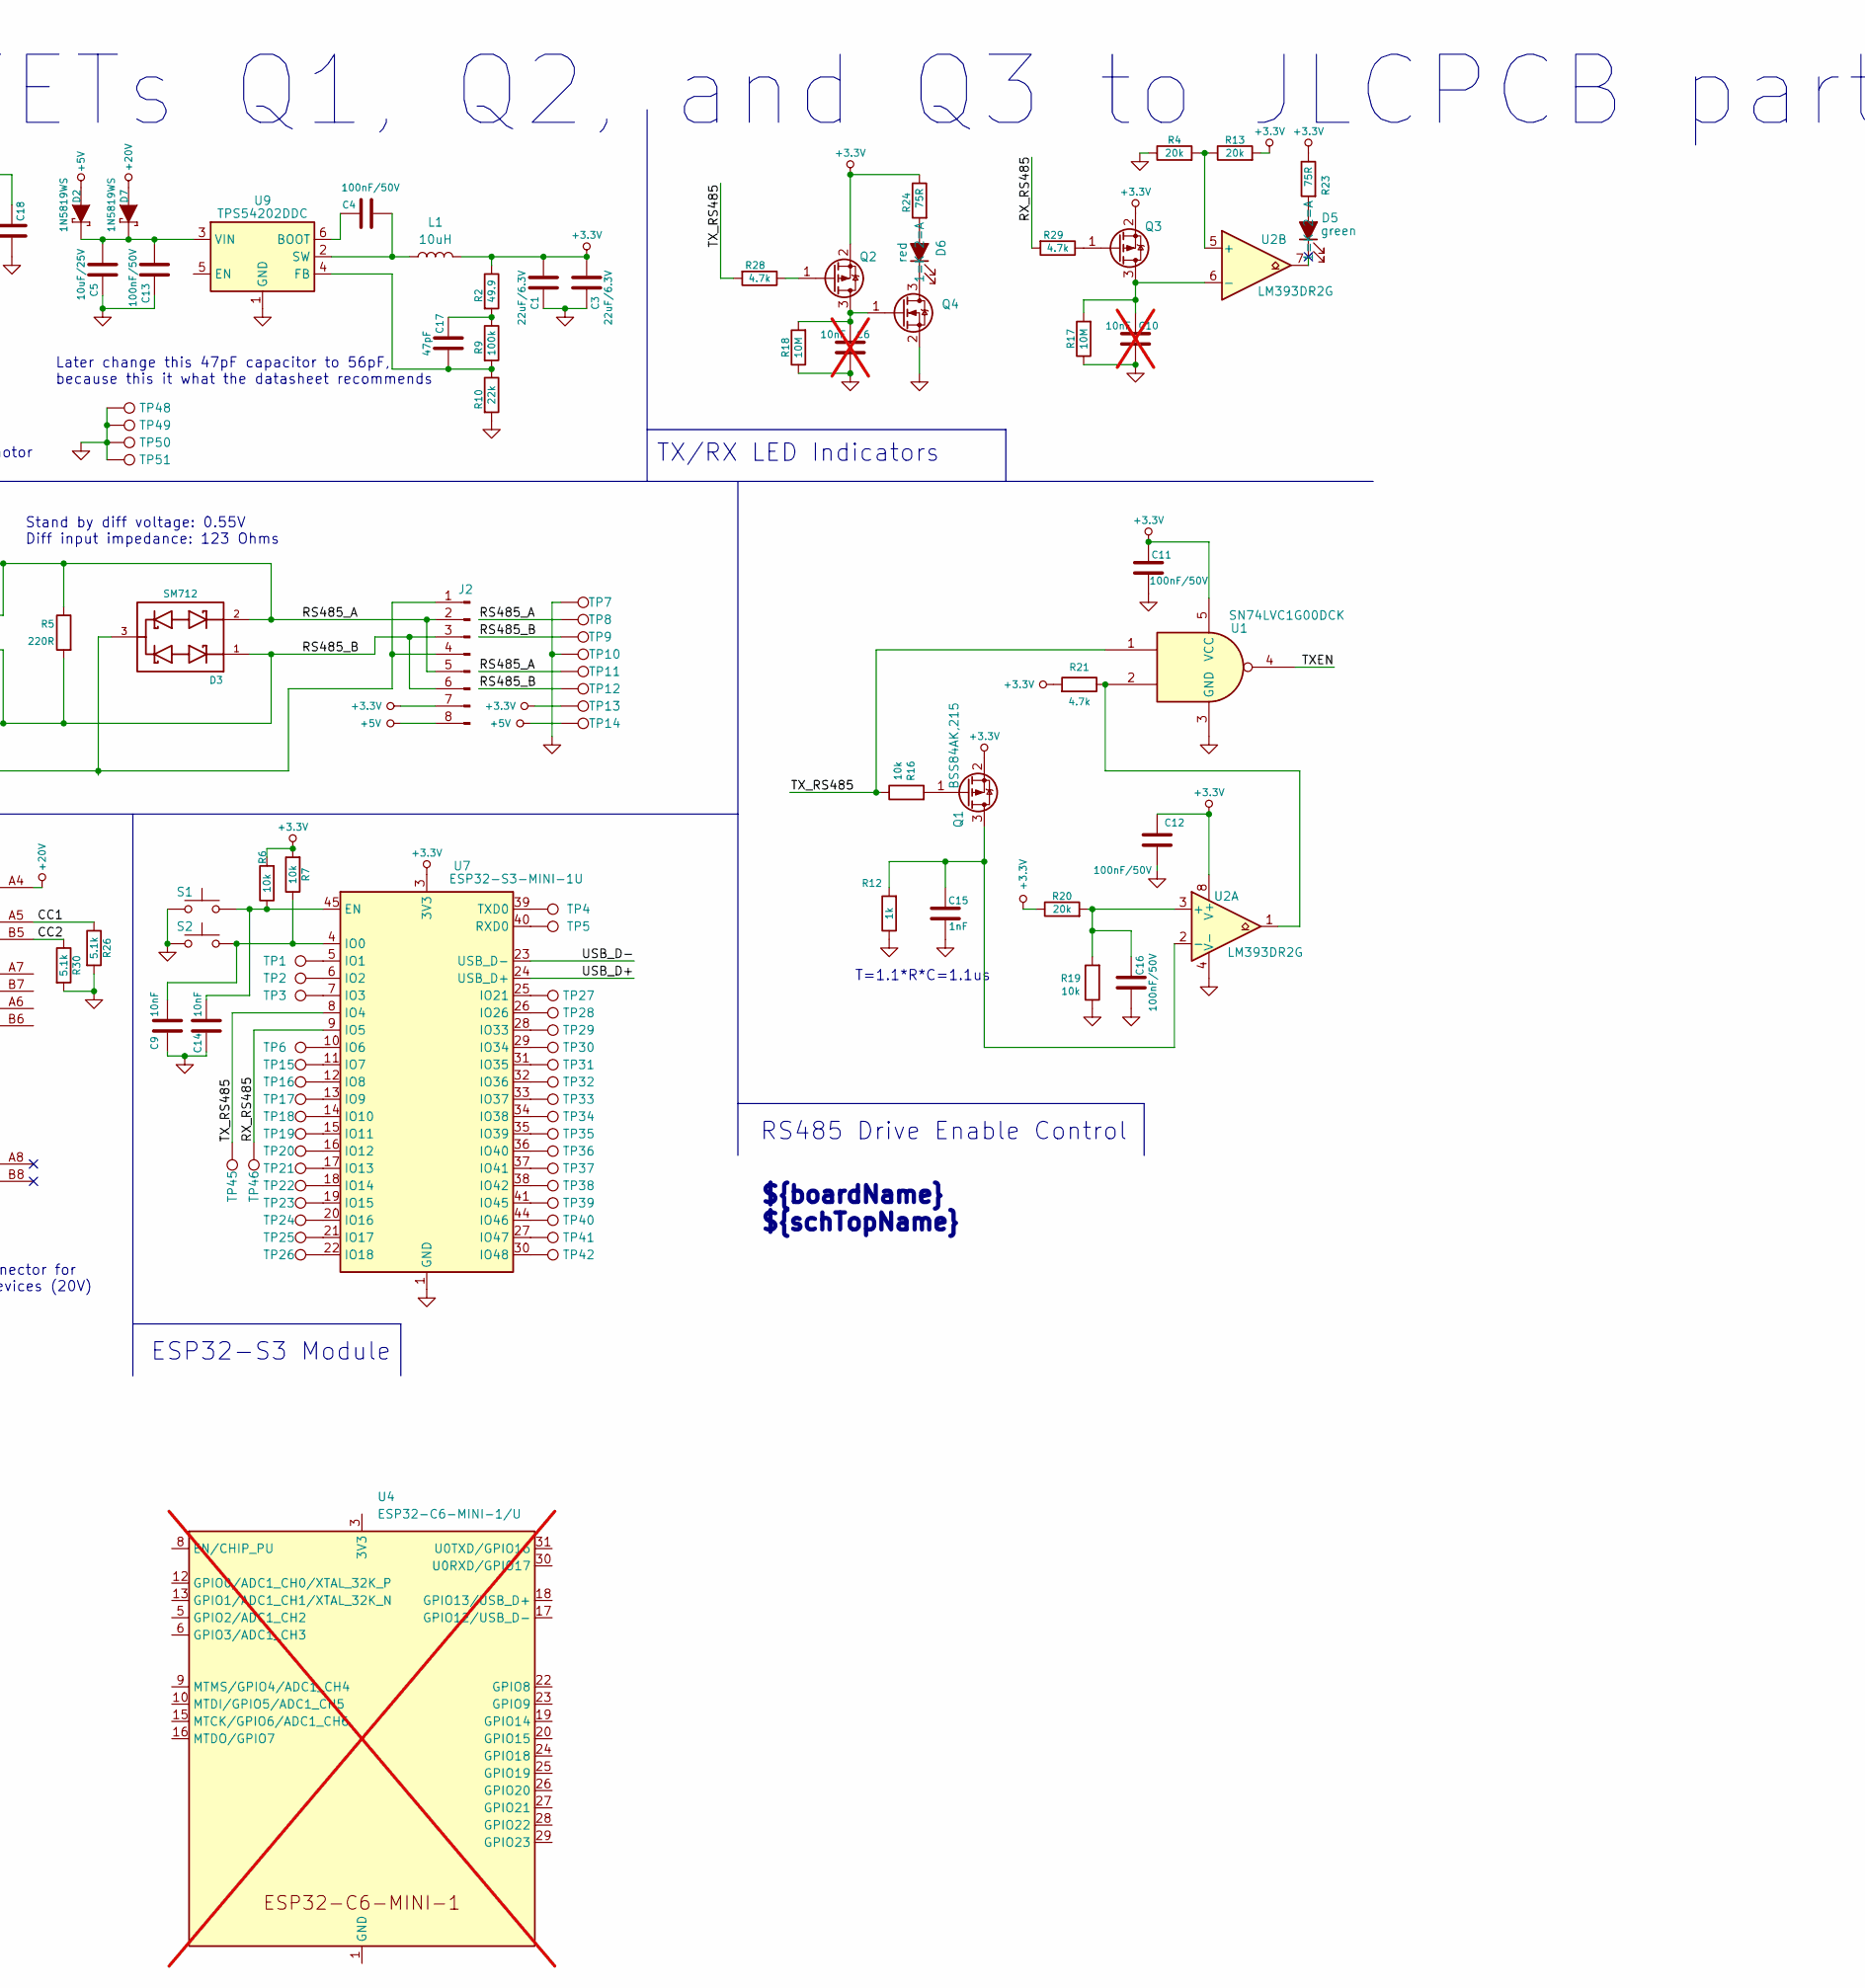
[picture p41: schematic schTop.kicad_sch, ${boardName} - ${schTopName}, part in row 1, column 2]

Parts:
C1, C3: 22uF/6.3V; C_0603_1608Metric; Tolerance 10%; PartNumber CL10A106KP8NNNC; LCSC C59461
C4, C7, C11, C12, C13, C16: 100nF/50V; C_0603_1608Metric; Tolerance 10%; PartNumber CC0603KRX7R9BB104; Digikey 1276-6854-1-ND
C5: 10uF/25V; C_0603_1608Metric; LCSC C96446
C6: 10nF; C_0603_1608Metric; Tolerance 10%; PartNumber 0603B103K500NT; LCSC C57112; not fitted
C9, C14: 10nF; C_0603_1608Metric; LCSC C57112
C10: 10nF; C_0603_1608Metric; Tolerance 10%; PartNumber 0603B103K500NT; Digikey ---; not fitted
C15: 1nF; C_0603_1608Metric; Tolerance 10%; PartNumber CL10B102KB8NNNC; LCSC C1588
C17: 47pF; C_0603_1608Metric; LCSC C1671
C18: 1uF/25V; C_0603_1608Metric; LCSC C15849
D1: TVS_5V; SOT23-6L; Tolerance _; PartNumber TPIP4220CZ6; Digikey !1727-2751-1-ND
D2, D7: 1N5819WS; SOD323; LCSC C191023
D3: SM712; SOT23-3; Tolerance _; PartNumber SM712; Digikey !F6450CT-ND
D4: yellow; LED_0805_2012Metric; PartNumber KT-0805Y; LCSC C2296
D5: green; LED_0805_2012Metric; PartNumber KT-0805G; LCSC C2297
D6: red; LED_0805_2012Metric; PartNumber NCD0805R1; LCSC C84256
J1: Screw_Terminal_01x02; 2P_screw_terminal; LCSC C8404
J2: TSM-108-01-T-SH-A-P-TR; Connector_8-pin_SMT_hole_1.5mm; LCSC C9900147851
J3, J5: USB_C_Receptacle; USB_C_Receptacle_Palconn_UTC16-G; LCSC C2765186
L1: 10uH; Inductor_7.3x6.6mm; LCSC C128692
Q1, Q2, Q3: BSS84AK,215; SOT-23; Tolerance _; PartNumber BSS84AK,215; Digikey ---
Q4: Q_NMOS_GSD; SOT-23; Part Number 2N7002; LCSC C8545
R1, R3: 560R; R_0603_1608Metric; Tolerance 1%; PartNumber 0603WAF5600T5E; LCSC C23204
R2: 49.9; R_0603_1608Metric; LCSC C23185
R4, R13, R20: 20k; R_0603_1608Metric; Tolerance 1%; PartNumber 0603WAF2002T5E; LCSC C4184
R5: 220R; R_0603_1608Metric; Tolerance 5%; PartNumber 0603WAF2200T5E; LCSC C22962
R6, R7, R8, R16, R19, R25: 10k; R_0603_1608Metric; Tolerance 1%; PartNumber 0603WAF1002T5E; LCSC C25804
R9: 100k; R_0603_1608Metric; LCSC C25803
R10: 22k; R_0603_1608Metric; LCSC C31850
R11, R12: 1k; R_0603_1608Metric; Tolerance 1%; PartNumber 0603WAF1001T5E; Digikey 311-1.00KHRCT-ND
R14, R15, R26, R30: 5.1k; R_0402_1005Metric; Tolerance 1%; LCSC C25905
R17, R18: 10M; R_0603_1608Metric; PartNumber 0603WAF1005T5E; LCSC C7250
R21, R22, R28, R29: 4.7k; R_0603_1608Metric; Tolerance 1%; PartNumber 0603WAF4701T5E; LCSC C23162
R23, R24: 75R; R_0603_1608Metric; Tolerance 1%; PartNumber 0603WAF750JT5E; LCSC C4275
R27: 200k; R_0603_1608Metric; LCSC C25811
R31: 62k; R_0603_1608Metric; LCSC C23221; not fitted
S1, S2: SW_Push; button; LCSC C720477
TP1, TP2, TP3, TP4, TP5, TP6, TP15, TP16, TP17, TP18, TP19, TP20, TP21, TP22, TP23, TP24, TP25, TP26, TP27, TP28, TP29, TP30, TP31, TP32, TP33, TP34, TP35, TP36, TP37, TP38, TP39, TP40, TP41, TP42, TP43, TP44, TP45, TP46, TP47, TP48, TP49, TP50, TP51: TestPoint; testpoint_no_border
TP7, TP8, TP9, TP10, TP11, TP12, TP13, TP14: TestPoint; testpoint_no_border_surface_mount
U1: SN74LVC1G00DCK; Texas_R-PDSO-G5_DCK-5; LCSC C2976658
U2: LM393DR2G; SOIC-8_3.9x4.9mm_P1.27mm; Tolerance _; PartNumber LM393DR2G; Digikey _
U3: ESP32-C6-WROOM-1; not fitted
U4: ESP32-C6-MINI-1/U; ESP32-C6-MINI-1; not fitted
U5: SP3485EN; SOIC-8_3.9x4.9mm_P1.27mm; Tolerance _; PartNumber SP3485EN-L/TR; LCSC C8963
U7: ESP32-S3-MINI-1U; ESP32-S2-MINI-1U; LCSC C2980299
U8: CH221K; SOT-23-6; LCSC C5125736
U9: TPS54202DDC; SOT-23-6; LCSC C191884

Connections:
+3.3V: C1.1, C3.1, C7.2, C11.2, C12.2, D1.5 (VDD), J2.7, L1.2, Q1.2 (S), Q2.2 (S), Q3.2 (S), R1.1, R2.1, R6.2, R7.2, R8.1, R13.2, R20.1, R21.2, R22.1, R23.1, R24.1, R25.2, TP13.1, U1.5 (VCC), U2.8 (V+), U5.8 (VCC), U7.3 (3V3)
+5V: D2.1 (A), J2.8, J5.A4 (VBUS), J5.A9 (VBUS), J5.B4 (VBUS), J5.B9 (VBUS), TP14.1
+20V: D7.1 (A), J1.1, J3.A4 (VBUS), J3.A9 (VBUS), J3.B4 (VBUS), J3.B9 (VBUS), R11.2
/index/schTop/CC1: J3.A5 (CC1), R26.1, U8.4 (CC1)
/index/schTop/CC2: J3.B5 (CC2), R30.1, U8.5 (CC2)
/index/schTop/RS485A: D3.2 (cathode), J2.2, J2.5, R1.2, R5.1, TP8.1, TP11.1, U5.6 (A)
/index/schTop/RS485B: D3.1 (Anode), J2.3, J2.6, R3.2, R5.2, TP9.1, TP12.1, U5.7 (B)
/index/schTop/RX_RS485: R25.1, R29.2, TP46.1, U5.1 (RO), U7.9 (IO5)
/index/schTop/TXEN: U1.4, U5.2 (~RE), U5.3 (DE)
/index/schTop/TX_RS485: R8.2, R16.1, R28.2, TP45.1, U1.1, U5.4 (DI), U7.8 (IO4)
/index/schTop/USB_D+: D1.3 (IO2), J5.A6 (D+), J5.B6 (D+), U7.24 (USB_D+)
/index/schTop/USB_D-: D1.4 (IO3), J5.A7 (D-), J5.B7 (D-), U7.23 (USB_D-)
GND: C1.2, C3.2, C5.2, C6.1, C7.1, C9.1, C10.1, C11.1, C12.1, C13.2, C14.1, C15.1, C16.1, C18.2, D1.2 (GND), D3.3 (AK), D4.1 (K), J1.2, J2.1, J2.4, J3.A1 (GND), J3.A12 (GND), J3.B1 (GND), J3.B12 (GND), J3.S1 (SHIELD), J5.A1 (GND), J5.A12 (GND), J5.B1 (GND), J5.B12 (GND), J5.S1 (SHIELD), Q4.2 (S), R3.1, R4.1, R10.2, R12.1, R14.2, R15.2, R17.1, R18.1, R19.1, R26.2, R30.2, S1.1, S2.1, TP7.1, TP10.1, TP48.1, TP49.1, TP50.1, TP51.1, U1.3 (GND), U2.4 (V-), U5.5 (GND), U7.1 (GND), U7.2 (GND), U7.42 (GND), U7.43 (GND), U7.46 (GND), U7.47 (GND), U7.48 (GND), U7.49 (GND), U7.50 (GND), U7.51 (GND), U7.52 (GND), U7.53 (GND), U7.54 (GND), U7.55 (GND), U7.56 (GND), U7.57 (GND), U7.58 (GND), U7.59 (GND), U7.60 (GND), U7.61 (GND), U7.62 (GND), U7.63 (GND), U7.64 (GND), U7.65 (GND), U8.2 (GND), U9.1 (GND)
unnamed: C17.1, R2.2, R9.1
unnamed: C5.1, C13.1, D2.2 (K), D7.2 (K), U9.3 (VIN)
unnamed: D4.2 (A), R22.2
unnamed: D5.2 (A), R23.2
unnamed: D6.2 (A), R24.2
unnamed: D6.1 (K), Q4.3 (D)
unnamed: J5.A5 (CC1), R14.1
unnamed: J5.B5 (CC2), R15.1
unnamed: C15.2, Q1.3 (D), R12.2, U2.2 (-)
unnamed: Q1.1 (G), R16.2
unnamed: C6.2, Q2.3 (D), Q4.1 (G), R18.2
unnamed: Q2.1 (G), R28.1
unnamed: C10.2, Q3.3 (D), R17.2, U2.6 (-)
unnamed: Q3.1 (G), R29.1
unnamed: R21.1, U1.2, U2.1
unnamed: C16.2, R19.2, R20.2, U2.3 (+)
unnamed: R4.2, R13.1, U2.5 (+)
unnamed: U3.1 (GND), U3.28 (GND), U3.29 (GND)
unnamed: U4.1 (GND), U4.2 (GND), U4.11 (GND), U4.14 (GND), U4.36 (GND), U4.37 (GND), U4.38 (GND), U4.39 (GND), U4.40 (GND), U4.41 (GND), U4.42 (GND), U4.43 (GND), U4.44 (GND), U4.45 (GND), U4.46 (GND), U4.47 (GND), U4.48 (GND), U4.49 (GND), U4.50 (GND), U4.51 (GND), U4.52 (GND), U4.53 (GND)
unnamed: C14.2, R6.1, S1.2, U7.45 (EN)
unnamed: C9.2, R7.1, S2.2, U7.4 (IO0)
unnamed: TP1.1, U7.5 (IO1)
unnamed: TP2.1, U7.6 (IO2)
unnamed: TP3.1, U7.7 (IO3)
unnamed: TP6.1, U7.10 (IO6)
unnamed: TP15.1, U7.11 (IO7)
unnamed: TP16.1, U7.12 (IO8)
unnamed: TP17.1, U7.13 (IO9)
unnamed: TP18.1, U7.14 (IO10)
unnamed: TP19.1, U7.15 (IO11)
unnamed: TP20.1, U7.16 (IO12)
unnamed: TP21.1, U7.17 (IO13)
unnamed: TP22.1, U7.18 (IO14)
unnamed: TP23.1, U7.19 (IO15)
unnamed: TP24.1, U7.20 (IO16)
unnamed: TP25.1, U7.21 (IO17)
unnamed: TP26.1, U7.22 (IO18)
unnamed: TP27.1, U7.25 (IO21)
unnamed: TP28.1, U7.26 (IO26)
unnamed: TP29.1, U7.28 (IO33)
unnamed: TP30.1, U7.29 (IO34)
unnamed: TP31.1, U7.31 (IO35)
unnamed: TP32.1, U7.32 (IO36)
unnamed: TP33.1, U7.33 (IO37)
unnamed: TP34.1, U7.34 (IO38)
unnamed: TP35.1, U7.35 (IO39)
unnamed: TP36.1, U7.36 (IO40)
unnamed: TP37.1, U7.37 (IO41)
unnamed: TP38.1, U7.38 (IO42)
unnamed: TP39.1, U7.41 (IO45)
unnamed: TP40.1, U7.44 (IO46)
unnamed: TP41.1, U7.27 (IO47)
unnamed: TP42.1, U7.30 (IO48)
unnamed: TP5.1, U7.40 (RXD0)
unnamed: TP4.1, U7.39 (TXD0)
unnamed: R27.2, R31.2, TP47.1, U8.6 (CFG)
unnamed: TP43.1, U8.3 (PG)
unnamed: C18.1, R11.1, R27.1, R31.1, TP44.1, U8.1 (VDD)
unnamed: C4.2, U9.6 (BOOT)
unnamed: C17.2, R9.2, R10.1, U9.4 (FB)
unnamed: C4.1, L1.1, U9.2 (SW)

Notes on the sheet:
Stand by diff voltage: 0.55V Diff input impedance: 123 Ohms
Later change this 47pF capacitor to 56pF, because this it what the datasheet recommends
RS485 BUS
T=1.1*R*C=1.1us
20V output for the motor
Change these three MOSFETs Q1, Q2, and Q3 to JLCPCB part C5337191 to save cost.
TX/RX LED Indicators
USB C
Power Supply
USB-C Connector for Programming the ESP32-S3
RS485 Drive Enable Control
USB-C Connector for Powering Devices (20V)
${boardName} ${schTopName}
ESP32-S3 Module


Notes on the sheet:
RS485 transciever ${38584aa2-988d-46de-8254-7374da227f54:VALUE} (${38584aa2-988d-46de-8254-7374da227f54:REFERENCE})
${boardName} - ${signalBDName}
RS485 connector (${124be00b-7c4b-44a1-ac37-f5e21129a574:REFERENCE})
Raspberry PI connector (${00000000-0000-0000-0000-000060ea0c9e:REFERENCE})
UART TX
USB C connector (${b7cc3d0e-1fc8-4cd7-a3c2-1509da6ebf42:REFERENCE})
UART RX
RS485
TXEN
USB
Timer comparator ${8bbc771b-3c83-43e4-9319-f143e5621448:VALUE} (${8bbc771b-3c83-43e4-9319-f143e5621448:REFERENCE})
Arduino connector (${00000000-0000-0000-0000-000060e9a81a:REFERENCE})
Micro USB connector (${00000000-0000-0000-0000-00006189f77b:REFERENCE})
${f667849b-0b99-4ae9-84ee-f99d12aea449:VALUE} USB to UART bridge (${f667849b-0b99-4ae9-84ee-f99d12aea449:REFERENCE})

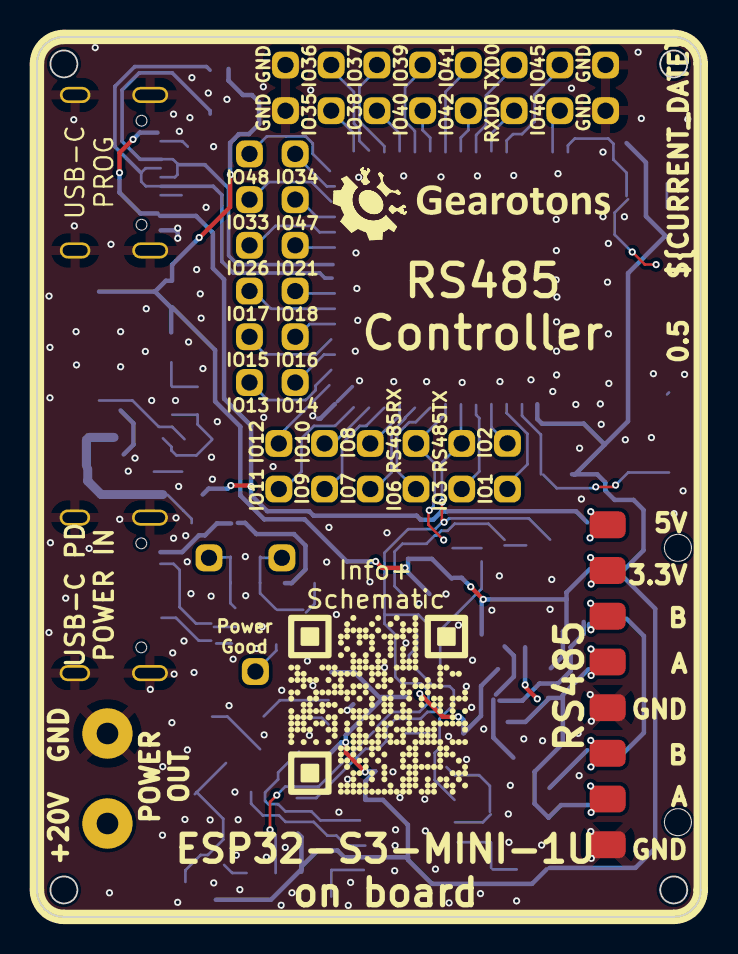
[picture p42: board 0.5.kicad_pcb from above]

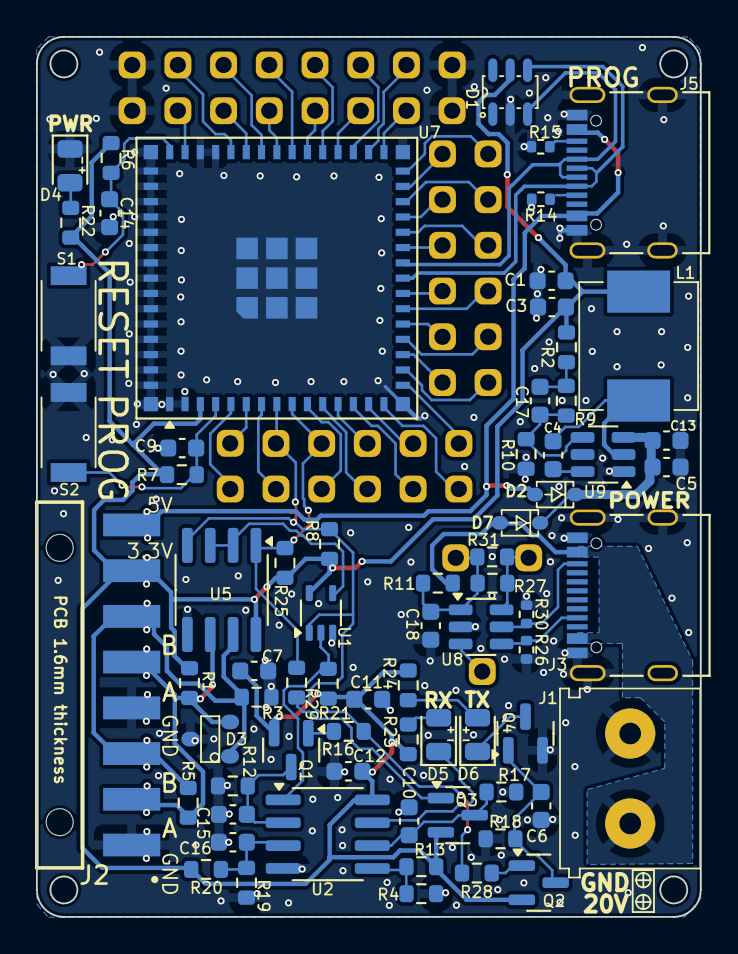
[picture p43: board 0.5.kicad_pcb from below]

Board: 2 copper layers, 36.9 x 48.9 mm, 122 parts (108 on the bottom side), 72 nets.
