tomrodinger/RS485_Controller/datasheet/generate_datasheet_v1_0.py

#!/usr/bin/env python3
"""Build the public RS485 Controller datasheet, document revision 1.0.

Technical figures retain vector geometry. The Arduino example is preserved
from the published M17 reference; internal provenance remains in local records.
"""
from pathlib import Path
from xml.sax.saxutils import escape
import argparse
import hashlib
import json
import os
import tempfile

os.environ['SOURCE_DATE_EPOCH'] = '1793664000'
import fitz
from PIL import Image
from reportlab.pdfgen import canvas
from reportlab.pdfbase.pdfmetrics import stringWidth
from reportlab.lib import colors
from reportlab.lib.pagesizes import A4, A3, landscape
from reportlab.lib.styles import ParagraphStyle
from reportlab.platypus import Paragraph, Table, TableStyle

ROOT = Path(__file__).resolve().parent
REPO = ROOT.parent
M = 43
GREEN = colors.HexColor('#08765b')
DARK = colors.HexColor('#153a32')
INK = colors.HexColor('#203c39')
GRAY = colors.HexColor('#586c69')
LIGHT = colors.HexColor('#eef6f3')
RULE = colors.HexColor('#d5e4df')
DATE = '4 November 2026'
VERSION = '1.0'
ESPRESSIF_URL = 'https://www.espressif.com/sites/default/files/documentation/esp32-s3-mini-1_mini-1u_datasheet_en.pdf'
PD_DATASHEET_URL = 'https://www.wch-ic.com/downloads/CH224DS1_PDF.html'
STYLE = ParagraphStyle('body', fontName='Helvetica', fontSize=9.7, leading=14.6, textColor=INK)
SMALL = ParagraphStyle('small', parent=STYLE, fontSize=8.2, leading=11.8, textColor=GRAY)
SCHEMATIC = ROOT / 'assets/release-v1.0/controller-schematic.pdf'
FIGURES = {
    'locator': 'connector-locator.pdf',
    'mechanical': 'mechanical-dimensions.pdf',
    'gpio-overview': 'gpio-overview.pdf',
    'gpio-detail': 'gpio-detail.pdf',
}


def sha256(path):
    return hashlib.sha256(Path(path).read_bytes()).hexdigest()


class Sheet:
    def __init__(self, path):
        self.c = canvas.Canvas(str(path), pagesize=A4, pageCompression=1, invariant=1)
        self.c.setTitle(f'Gearotons RS485 Controller — PCB 0.5 — Datasheet v{VERSION}')
        self.c.setAuthor('Gearotons')
        self.c.setSubject('Power, connector locations, GPIO pad maps, mechanical dimensions, Arduino programming example and controller schematic')
        self.page = 0
        self.w, self.h = A4
        self.figures = []
        self.sections = []
        self.placeholders = []

    @property
    def cw(self):
        return self.w - 2 * M

    def text(self, value, x, y, size=10, color=INK, font='Helvetica'):
        self.c.setFillColor(color)
        self.c.setFont(font, size)
        self.c.drawString(x, self.h - y - size * .85, value)

    def para(self, value, y, x=M, w=None, style=STYLE):
        p = Paragraph(value, style)
        _, height = p.wrap(self.cw if w is None else w, self.h)
        if y + height > self.h - 55:
            raise ValueError(f'Page {self.page} paragraph overflow: {y + height:.1f}: {value[:70]}')
        p.drawOn(self.c, x, self.h - y - height)
        return y + height

    def line(self, x1, y1, x2, y2, color=RULE, width=.7):
        self.c.setStrokeColor(color)
        self.c.setLineWidth(width)
        self.c.line(x1, self.h - y1, x2, self.h - y2)

    def rect(self, x, y, width, height, fill=LIGHT, radius=6, stroke=None):
        self.c.setFillColor(fill)
        self.c.setStrokeColor(stroke or fill)
        self.c.roundRect(x, self.h - y - height, width, height, radius, fill=1, stroke=bool(stroke))

    def image(self, path, x, y, width, height):
        with Image.open(path) as image:
            iw, ih = image.size
        scale = min(width / iw, height / ih)
        dw, dh = iw * scale, ih * scale
        self.c.drawImage(str(path), x + (width - dw) / 2, self.h - y - dh, dw, dh, mask='auto')
        return dh

    def new(self, kicker, title, subtitle, size=A4, compact=False, subtitle_style=SMALL):
        if self.page:
            self.c.showPage()
        self.w, self.h = size
        self.c.setPageSize(size)
        self.page += 1
        self.sections.append({'page': self.page, 'title': title, 'size_points': list(size)})
        if compact:
            self.image(ROOT / 'assets/gearotons-logo.png', M, 18, 95, 25)
            self.text(title, M + 122, 23, 17, DARK, 'Helvetica-Bold')
            self.line(M, 53, self.w - M, 53)
            self.para(subtitle, 64, style=SMALL)
        else:
            self.image(ROOT / 'assets/gearotons-logo.png', M, 27, 116, 30)
            self.line(M, 67, self.w - M, 67)
            self.text(kicker.upper(), M, 84, 8, GREEN, 'Helvetica-Bold')
            self.text(title, M, 103, 25, DARK, 'Helvetica-Bold')
            self.para(subtitle, 139, style=subtitle_style)
        self.line(M, self.h - 44, self.w - M, self.h - 44)
        self.text(f'RS485 Controller  |  PCB 0.5  |  Datasheet v{VERSION}  |  {DATE}', M, self.h - 33, 7, GRAY)
        self.text(f'{self.page:02}', self.w - M - 12, self.h - 33, 8, GREEN, 'Helvetica-Bold')

    def h2(self, value, y):
        self.text(value, M, y, 13, DARK, 'Helvetica-Bold')
        return y + 24

    def table(self, headers, rows, widths, y, x=M, font_size=9, padding=8):
        head = ParagraphStyle('thead', parent=SMALL, fontName='Helvetica-Bold', textColor=colors.white, fontSize=8.5, leading=12)
        body = ParagraphStyle('cell', parent=STYLE, fontSize=font_size, leading=font_size * 1.4)
        data = [[Paragraph(str(cell), head) for cell in headers]] + [[Paragraph(str(cell), body) for cell in row] for row in rows]
        table = Table(data, colWidths=widths, hAlign='LEFT')
        table.setStyle(TableStyle([
            ('BACKGROUND', (0, 0), (-1, 0), DARK),
            ('ROWBACKGROUNDS', (0, 1), (-1, -1), [colors.white, LIGHT]),
            ('VALIGN', (0, 0), (-1, -1), 'MIDDLE'),
            ('LEFTPADDING', (0, 0), (-1, -1), 10),
            ('RIGHTPADDING', (0, 0), (-1, -1), 10),
            ('TOPPADDING', (0, 0), (-1, -1), padding),
            ('BOTTOMPADDING', (0, 0), (-1, -1), padding),
            ('LINEBELOW', (0, -1), (-1, -1), .6, RULE),
        ]))
        _, height = table.wrap(sum(widths), self.h)
        if y + height > self.h - 55:
            raise ValueError(f'Page {self.page} table overflow: {y + height:.1f}')
        table.drawOn(self.c, x, self.h - y - height)
        return y + height

    def note(self, title, body, y):
        p = Paragraph(body, SMALL)
        _, height = p.wrap(self.cw - 26, self.h)
        total = height + 46
        if y + total > self.h - 55:
            raise ValueError(f'Page {self.page} note overflow: {y + total:.1f}')
        self.rect(M, y, self.cw, total)
        self.text(title, M + 13, y + 11, 10, GREEN, 'Helvetica-Bold')
        p.drawOn(self.c, M + 13, self.h - y - 31 - height)
        return y + total

    def vector(self, path, y, height, allow_missing=False):
        path = Path(path)
        if not path.exists():
            if not allow_missing:
                raise FileNotFoundError(f'Required technical asset is missing: {path}')
            self.rect(M, y, self.cw, height, stroke=RULE)
            self.para(f'<b>INTERIM LAYOUT ONLY — VERIFIED FIGURE PENDING</b><br/>{escape(path.name)}', y + 32, x=M + 24, w=self.cw - 48)
            self.placeholders.append(str(path))
        elif path.suffix.lower() == '.pdf':
            with fitz.open(path) as source:
                if len(source) != 1:
                    raise ValueError(f'Technical figures must be single-page PDFs; supply additional detail pages separately: {path}')
            self.figures.append({'page': self.page - 1, 'path': path, 'rect': [M, y, self.w - M, y + height]})
        else:
            self.image(path, M, y, self.cw, height)
        return y + height

    def code(self, path, y, font_size=8.1, leading=10.6):
        text = Path(path).read_text()
        lines = text.rstrip('\n').split('\n')
        widest = max(stringWidth(line, 'Courier', font_size) for line in lines)
        if widest > self.cw - 26:
            raise ValueError(f'Code line is wider than page: {path}, {widest:.2f} > {self.cw - 26:.2f}')
        height = 24 + leading * len(lines)
        if y + height > self.h - 55:
            raise ValueError(f'Code block overflow: {path}')
        self.rect(M, y, self.cw, height, fill=colors.HexColor('#f1f5f3'), stroke=RULE)
        for i, line in enumerate(lines):
            self.text(line, M + 13, y + 12 + i * leading, font_size, INK, 'Courier')
        return y + height

    def save(self):
        self.c.save()


def validate_examples():
    provenance = json.loads((ROOT / 'review/example-provenance-v0.2.json').read_text())
    provenance['examples'] = [entry for entry in provenance['examples'] if entry['language'] == 'Arduino']
    for example in provenance['examples']:
        path = REPO / example['snapshot']
        if sha256(path) != example['sha256']:
            raise ValueError(f'Canonical code snapshot changed: {path}')
        if not example['matches_pdf_ignoring_layout_whitespace']:
            raise ValueError('Canonical PDF/source correspondence was not verified.')
    return provenance


def compose_vectors(layout, output, figures, sections):
    document = fitz.open(layout)
    for figure in figures:
        with fitz.open(figure['path']) as source:
            document[figure['page']].show_pdf_page(fitz.Rect(figure['rect']), source, 0, keep_proportion=True, overlay=True)
    document.set_metadata({**document.metadata, 'title': f'Gearotons RS485 Controller — PCB 0.5 — Datasheet v{VERSION}', 'author': 'Gearotons'})
    document.set_toc([[1, section['title'], section['page']] for section in sections])
    document.save(output, garbage=4, deflate=True, no_new_id=True)
    document.close()


def build(output, technical_dir, allow_missing=False, connection_illustration=None):
    provenance = validate_examples()
    if connection_illustration and sha256(connection_illustration) == '8ebcae4624b29a2fcdbbd408a0a26a6627be6a1d25f8c829b9c6b11a98c39df7':
        raise ValueError('The v0.1 AI connection image is excluded from v0.4.')
    assets = {key: technical_dir / name for key, name in FIGURES.items()}
    figure_manifest = technical_dir / 'figures.json'
    if figure_manifest.exists():
        for key, filename in json.loads(figure_manifest.read_text()).items():
            if key in assets:
                assets[key] = technical_dir / filename
    with tempfile.TemporaryDirectory(prefix='controller-v02-') as temp:
        layout = Path(temp) / 'layout.pdf'
        s = Sheet(layout)
        cw = s.cw

        cover_subtitle = ParagraphStyle('cover-subtitle', parent=STYLE, fontName='Helvetica-Bold', fontSize=11, leading=15, textColor=GREEN)
        s.new('Programmable motion control', 'RS485 Controller',
              'ESP32-S3 development board for Gearotons servomotors and other RS485 devices',
              subtitle_style=cover_subtitle)
        s.text('Affordable and Simple All-in-One Motion Control', M, 185, 12, GREEN, 'Helvetica-Bold')
        s.text('From Education to Innovation', M, 206, 10, GREEN)
        s.image(REPO / 'images/rs485-controller/component-side.jpg', M, 238, cw, 300)
        s.para('External antenna included. Cables, power supply and motors are separate system components.', 550, style=SMALL)
        y = s.h2('A compact controller for shared-bus motion', 584)
        y = s.para('Run motor-control logic directly on the ESP32-S3-MINI-1U module. The board combines native USB programming, a half-duplex RS485 interface, a USB-C PD power input and accessible GPIO pads.', y) + 12
        for text in [
            '<b>Embedded control:</b> dual-core LX7 processor, up to 240 MHz; 2.4 GHz Wi-Fi and Bluetooth 5 LE capabilities depend on application firmware.',
            '<b>Simple wiring:</b> two parallel A/B/GND groups, automatic RS485 direction circuitry, reset and programming buttons.',
            '<b>Motor-power integration:</b> standard assembly requests 20 V USB-C PD, with a direct motor-power output at the screw terminal.',
            '<b>Visible bus activity:</b> bright LEDs indicate transmission (red TX) and reception (green RX).',
        ]:
            y = s.para(text, y) + 9

        s.new('Specifications', 'Electrical & power', 'Power inputs, onboard supply rails and RS485 interface specifications.')
        y = s.table(['Parameter', 'Specification / conditions'], [
            ('Processor / module', 'ESP32-S3-MINI-1U; dual-core Xtensa LX7, up to 240 MHz.'),
            ('Wireless hardware', '2.4 GHz Wi-Fi 802.11b/g/n and Bluetooth 5 LE; external antenna included. Wireless control requires suitable firmware.'),
            ('Programming supply, J5', '5 V nominal USB input and native ESP32-S3 USB data. J5 alone is sufficient to power and program the module; motor power is separate.'),
            ('PD power input, J3', 'Requests 20 V using CH221K and R27 = 200 kΩ. Actual voltage depends on the source and successful PD negotiation.'),
            ('Motor-power output, J1', 'Pin 1 = J3 VBUS rail (labelled +20 V); pin 2 = GND. Direct pass-through, not a separately regulated 20 V output.'),
            ('Logic / RS485 interface', '3.3 V logic; SP3485EN half-duplex differential transceiver. Controller, USB and motor grounds are common; no galvanic isolation.'),
            ('RS485 example setting', '230400 baud, 8 data bits, no parity, 1 stop bit. TX = GPIO4; RX = GPIO5. Board maximum baud rate is not specified.'),
            ('Bus loading / protection', 'R5 = 220 Ω across A/B. R1 = 560 Ω pulls A high; R3 = 560 Ω pulls B low. SM712 transient suppressor on the bus.'),
            ('Auxiliary power pins, J2', '3.3 V rail and J5-associated 5 V rail. Available external current is not specified. The 5 V rail is not generated from the PD input.'),
        ], [147, cw - 147], 177)
        y = s.note('USB-C PD request and actual motor voltage', 'The CH221K requests 20 V from the USB-C power supply. If the source cannot supply 20 V and instead delivers 15 V or 12 V, Gearotons M17 motors can still operate. Below 12 V, the motors will likely not work correctly. Measure J1 before connecting motors and ensure the supply and cable can support the motor load. J5 alone does not provide motor power at J1.', y + 20)
        s.para('<b>Unspecified product ratings:</b> board current consumption, continuous motor-power pass-through current, maximum cable length, environmental limits and product-level ESD/EMC ratings. Component ratings do not define board-level limits.', y + 16, style=SMALL)

        s.new('Interfaces · physical locator', 'Power, programming & status', 'Locate connectors, switches and indicator LEDs before connecting or programming the controller.')
        y = s.vector(assets['locator'], 175, 455, allow_missing)
        y = s.para('Component-side view (B.Cu). J1 supplies motor power; J2 provides the RS485 interface and auxiliary rails. Attach the included antenna to the U7 coax socket before using the radio. Connector pinouts and controls are listed on the next page.', y + 12, style=SMALL)
        s.note('Separate the two USB-C functions', '<b>J3:</b> USB-C PD motor-power input. <b>J5:</b> native USB programming and 5 V logic power. The J3 USB data pins are unconnected. USB-C connector shape does not indicate which function it provides.', y + 18)

        s.new('Interfaces · electrical reference', 'Connector pinout & controls', 'The two RS485 groups on J2 are electrically parallel; all grounds share one reference.')
        y = s.table(['J2 pin', 'Signal', 'Use'], [
            ('1', 'GND', 'Common ground'), ('2', 'A', 'RS485 A'), ('3', 'B', 'RS485 B'),
            ('4', 'GND', 'Same net as pin 1'), ('5', 'A', 'Same bus as pin 2'), ('6', 'B', 'Same bus as pin 3'),
            ('7', '3.3 V', 'Logic supply rail; external load not rated'), ('8', '5 V', 'Programming USB supply rail; external load not rated'),
        ], [58, 74, cw - 132], 177)
        y = s.h2('Power, programming, switches and indicators', y + 22)
        y = s.table(['Reference', 'Function'], [
            ('J1 · POWER OUT', 'Two-way screw terminal. Pin 1 is the positive PD rail; pin 2 is GND. Verify polarity on the board.'),
            ('J3 · PD POWER IN', 'USB-C power input and PD negotiation. This socket does not program the ESP32-S3.'),
            ('J5 · USB-C PROG', 'Native USB D−/D+ connect to GPIO19/GPIO20. Use a data-capable USB cable.'),
            ('S1 · RESET', 'Pulls the module EN signal low to reset the controller.'),
            ('S2 · PROG', 'Pulls GPIO0 low; hold during reset to enter ROM download mode.'),
            ('D4 · yellow LED', 'Logic-power indication.'),
            ('D5 · green LED', 'Receive activity; indication depends on bus traffic.'),
            ('D6 · red LED', 'Transmit activity; indication depends on bus traffic.'),
        ], [128, cw - 128], y, font_size=8.6)
        s.para('Keep motor supply voltage off J2. Its 3.3 V and 5 V pins are auxiliary logic rails, not motor-power terminals. Refer to the physical locator and actual PCB labels for orientation.', y + 14, style=SMALL)

        if connection_illustration:
            s.new('System wiring · selected illustration', 'Two-motor connection diagram',
                  'System connections: computer USB to J5 PROG and USB-C PD power supply to J3.',
                  size=landscape(A3), compact=True)
            s.vector(connection_illustration, 88, s.h - 165, False)
            s.para('Computer: J5 USB-C PROG. Motor-power supply: J3 PD POWER IN. Connector mating faces are not shown; match actual labels.', s.h - 70, style=SMALL)
        s.new('System wiring', 'Connect two servomotors', 'The illustrated USB-C PD arrangement requests 20 V; the motor rail follows the actual supply voltage.')
        y = 177
        y = s.para('Use the following net-by-net connections for both motors. Connect the data bus along one route and distribute motor supply/return wiring for the combined motor current.', y) + 20
        y = s.table(['Net', 'Controller connection', 'Motor 1 and Motor 2'], [
            ('V+', 'J1 pin 1 (actual J3 voltage)', 'Each motor V+ / positive supply'),
            ('GND', 'J1 pin 2 and J2 pin 1 or 4', 'Each motor GND / supply return'),
            ('A', 'J2 pin 2 or 5', 'A to A, onward along the bus'),
            ('B', 'J2 pin 3 or 6', 'B to B, onward along the bus'),
        ], [70, 183, cw - 253], y)
        steps = [
            ('Check power while disconnected', 'With motors disconnected, connect the USB-C PD source to J3 and measure J1. Check the actual voltage and polarity, then turn the source off before wiring the motors.'),
            ('Wire the common ground and motor supply', 'Connect both motor supply returns and controller GND. Motor returns must be sized for motor current; the data-ground lead must not be the only motor-current return.'),
            ('Connect the differential bus', 'Connect A to A and B to B. Route A/B as a twisted pair along one bus, keeping branches short. Give each motor a distinct alias before addressed motion commands.'),
            ('Power and test deliberately', 'Secure both motors before discovery or movement examples. The power supply, cable and distribution wiring must support the combined load.'),
        ]
        y += 22
        for number, (title, body) in enumerate(steps, 1):
            y = s.para(f'<b>{number}. {title}.</b> {body}', y) + 14
        y = s.para('The M17 motor reference specifies 12–24 V operation. A 15 V or 12 V supply can run the motors even when 20 V is unavailable; below 12 V they will likely not work correctly. R5 already loads A/B with 220 Ω. Select additional end termination for the complete bus instead of adding resistors at every motor. No fixed motor-count guarantee is specified.', y, style=SMALL)
        s.note('Using a separate motor power supply', 'Keep J5 USB-C PROG connected to power the controller. Connect a suitable external supply positive directly to each motor V+, and its negative to each motor GND. Also connect the external supply negative to controller GND (J2 pin 1 or 4, or J1 pin 2). This common-ground connection is required for RS485 communication. Leave J3 and J1 pin 1 unused in this arrangement.', y + 18)

        s.new('Mechanical integration', 'Detailed PCB dimensions', 'PCB revision 0.5. Nominal dimensions in millimetres; connector overhang and antenna excluded.')
        y = s.vector(assets['mechanical'], 176, 470, allow_missing)
        y = s.para('Nominal PCB outline, corner radius, mounting-hole diameter, hole-centre spacing and edge insets are shown above. Manufacturing tolerances are not specified; allow appropriate enclosure clearance.', y + 12, style=SMALL)
        s.note('Mounting and assembled envelope', 'PCB thickness is 1.6 mm nominal. Keep clearance around underside components and connector solder joints. Overall assembled height and antenna/cable envelope are not specified. The Ø1.50 mm holes are not M2 or M3 clearance holes.', y + 18)

        s.new('GPIO access · unpopulated through holes', 'Breakout headers — solder required',
              'Rear / label-side view (F.Cu). Breakout headers are not fitted; solder headers or wires to the required through-hole pads.',
              size=A3, compact=True)
        y = s.vector(assets['gpio-overview'], 95, s.h - 285, allow_missing)
        y = s.para('<b>Signal legend:</b> Green: GPIO. Gray: GND. Amber: PD-control points. Blue: RS485 and auxiliary contacts. Label colours indicate function; pads have a HASL finish. Dashed outlines locate components fitted on the opposite face.', y + 12, style=SMALL) + 6
        y = s.para('<b>* PCB label aliases:</b> GPIO43 = TXD0 (UART0 transmit); GPIO44 = RXD0 (UART0 receive). The final character in TXD0/RXD0 is zero. These are the same physical pins, with functions selected by firmware. GPIO4 = RS485TX; GPIO5 = RS485RX. These logic signals are wired to the onboard RS485 circuitry; they are not the differential A/B bus and are not independent spare GPIO.', y, style=SMALL) + 8
        y = s.para('<b>Shared functions:</b> GPIO0/3/45/46 are module strapping signals; GPIO0 is connected to PROG. Use 3.3 V logic and avoid disturbing boot, USB or RS485.', y, style=SMALL) + 8
        y = s.para(f'<b>PD CFG, PD VDD and PD PG:</b> HASL-finished plated through-hole pads connected to the CH221K power-delivery chip, not GPIO. See the <link href="{PD_DATASHEET_URL}" color="#08765b"><u>CH221K datasheet</u></link> for pin functions and voltage configuration. Breakout headers are not fitted; J2 is separate.', y, style=SMALL) + 6
        s.para(f'<b>Module reference:</b> <link href="{ESPRESSIF_URL}" color="#08765b"><u>Official Espressif ESP32-S3-MINI-1 / MINI-1U datasheet (PDF)</u></link>.', y, style=SMALL)

        s.new('Bring-up', 'Getting started', 'Prepare the hardware and software, establish communication, then enable motion deliberately.')
        y = 180
        steps = [
            ('Prepare the hardware', 'Attach the included external antenna. With power off, check the motor polarity and A/B/GND connections. Secure the mechanism before running any movement example.'),
            ('Use the programming port', 'For programming only, connect J5 USB-C PROG to a computer with a data-capable cable. This powers the ESP32-S3; no motor supply or J3 connection is needed.'),
            ('Install Arduino support', 'Install the Arduino ESP32 board package and “Servomotor by Gearotons” from Library Manager. Select an ESP32-S3 target; configure native USB CDC for the USB serial console as appropriate for the board package.'),
            ('Enter download mode if needed', 'Hold S2 PROG, press and release S1 RESET, then release PROG. Select the detected USB device and upload the application.'),
            ('Verify motor power and identity', 'For motion, use J3/J1 or a suitable separate motor supply. With a separate supply, connect its negative to controller GND as well as motor GND. Check voltage and polarity before connecting motors; use the intended alias and secure the mechanism for one full rotation.'),
        ]
        for number, (title, body) in enumerate(steps, 1):
            s.rect(M, y, 24, 24, fill=GREEN, radius=5)
            s.text(str(number), M + 8, y + 5, 10, colors.white, 'Helvetica-Bold')
            y = s.para(f'<b>{title}.</b> {body}', y, x=M + 36, w=cw - 36) + 20
        y = s.h2('Arduino example for the controller', y + 2)
        y = s.para('Install Servomotor by Gearotons in the Arduino IDE, then upload the basic motor-control program. The example uses GPIO4 for RS485 TX and GPIO5 for RS485 RX.', y) + 18
        s.note('The example commands motor motion', 'The program enables the motor drive, requests one shaft rotation in one second, then disables the drive. Match the motor alias and serial connection to the intended motor, and secure the mechanism before running it.', y)

        s.new('Getting started · Arduino IDE', 'Install the Arduino library', 'Install Servomotor by Gearotons directly from the Arduino IDE.')
        y = s.para('Install the library through the Arduino Library Manager:', 177) + 12
        for step in [
            '1. Open Arduino IDE',
            '2. Go to Sketch → Include Library → Manage Libraries',
            '3. Search for "Servomotor"',
            '4. Find the library called "Servomotor by Gearotons" and click Install',
        ]:
            y = s.para(escape(step), y) + 8
        y += 5
        height = s.image(ROOT / 'assets/arduino-install-v0.3/arduino_library_installation.png', M, y, cw, 430)
        s.para('The screenshot uses Tools → Manage Libraries. Install Servomotor by Gearotons and select an ESP32-S3 board target for this controller; the ESP32-C3 selection shown is an example.', y + height + 10, style=SMALL)

        s.new('Getting started · Arduino example', 'Arduino: basic motor control', 'Basic motor control using the Servomotor by Gearotons Arduino library.')
        y = s.para('Install “Servomotor by Gearotons” using Arduino Library Manager. This example uses GPIO4 TX and GPIO5 RX for the onboard RS485 interface.', 176, style=SMALL) + 14
        y = s.code(ROOT / 'assets/examples-v0.2/arduino_library_example.cpp', y, font_size=8.1, leading=10.35)
        s.para('Set ALIAS to the intended motor alias before uploading. The program commands one shaft rotation in one second, then disables the motor drive.', y + 15, style=SMALL)

        s.new('Design reference', 'Controller schematic & resources', 'Circuit schematic, manufacturer documentation and software resources for PCB revision 0.5.')
        y = s.h2('Full controller schematic', 181)
        y = s.para('The following page shows the complete PCB revision 0.5 controller schematic, including power regulation, USB-C PD negotiation, native USB, RS485, controls and indicator circuitry.', y) + 18
        y = s.h2('Official module documentation', y)
        y = s.para(f'<link href="{ESPRESSIF_URL}" color="#08765b"><u>Espressif ESP32-S3-MINI-1 / ESP32-S3-MINI-1U datasheet</u></link><br/>Manufacturer reference for the module pin definitions, boot configuration, radio, electrical specifications and module mechanical details.', y) + 24
        y = s.h2('Power-delivery chip documentation', y)
        y = s.para(f'<link href="{PD_DATASHEET_URL}" color="#08765b"><u>WCH CH224-family datasheet — CH221K sections</u></link><br/>Refer to the CH221K pin descriptions and voltage-configuration table for PD CFG, PD VDD and PD PG. The standard 200 kΩ configuration requests 20 V from the USB-C power supply.', y) + 24
        y = s.h2('Software, tutorials and design files', y)
        y = s.para('<b>Controller source:</b> <link href="https://github.com/tomrodinger/RS485_Controller" color="#08765b"><u>github.com/tomrodinger/RS485_Controller</u></link><br/><b>Motor setup and protocol:</b> <link href="https://tutorial.gearotons.com" color="#08765b"><u>tutorial.gearotons.com</u></link><br/><b>Arduino library:</b> <link href="https://github.com/tomrodinger/Servomotor_Arduino_Library" color="#08765b"><u>github.com/tomrodinger/Servomotor_Arduino_Library</u></link><br/><b>Feedback:</b> <link href="https://tutorial.gearotons.com/feedback" color="#08765b"><u>tutorial.gearotons.com/feedback</u></link>', y) + 24
        s.new('Appendix · circuit schematic', 'Full controller schematic', 'RS485 Controller · PCB revision 0.5', size=landscape(A3), compact=True)
        s.vector(SCHEMATIC, 88, s.h - 143, False)

        s.new('Product photography', 'More views of the controller', 'Included external antenna, USB-C and power connectors, and rear PCB labels.')
        s.image(REPO / 'images/rs485-controller/with-antenna.jpg', M, 178, cw, 310)
        s.para('Controller with the supplied external antenna connected.', 495, style=SMALL)
        photo_width = (cw - 22) / 2
        s.image(REPO / 'images/rs485-controller/ports.jpg', M, 529, photo_width, 202)
        s.image(REPO / 'images/rs485-controller/label-side.jpg', M + photo_width + 22, 529, photo_width, 202)
        s.para('USB-C sockets and motor-power terminal', 738, w=photo_width, style=SMALL)
        s.para('Rear / label side', 738, x=M + photo_width + 22, w=photo_width, style=SMALL)
        s.para('Mass: 11.7 g including the supplied external antenna.', 766, style=SMALL)
        s.save()
        compose_vectors(layout, output, s.figures, s.sections)

    result = {
        'version': VERSION, 'date': DATE, 'output': str(output), 'sha256': sha256(output),
        'pages': s.sections, 'vector_figures': [{'page': item['page'] + 1, 'path': str(item['path']), 'sha256': sha256(item['path'])} for item in s.figures],
        'interim_placeholders': s.placeholders, 'connection_illustration': str(connection_illustration) if connection_illustration else None,
        'connection_illustration_sha256': sha256(connection_illustration) if connection_illustration else None,
        'arduino_installation_image_sha256': sha256(ROOT / 'assets/arduino-install-v0.3/arduino_library_installation.png'),
        'python_example_included': False,
        'excluded_prior_ai_image': 'datasheet/assets/two-motor-connection-ai.png',
        'canonical_example_sha256': {entry['language']: entry['sha256'] for entry in provenance['examples']},
        'espressif_datasheet_link': ESPRESSIF_URL,
        'power_delivery_datasheet_link': PD_DATASHEET_URL,
        'schematic_source_sha256': sha256(SCHEMATIC),
        'preserved_v0.1_sha256': sha256(ROOT / 'rs485_controller_datasheet_v0.1_review.pdf'),
        'technical_geometry_sha256': sha256(technical_dir / 'pcb-geometry.json') if (technical_dir / 'pcb-geometry.json').exists() else None,
        'breakout_label_manifest_sha256': sha256(technical_dir / 'breakout-labels.json'),
        'breakout_detail_pages_removed': True,
        'cover_photo': 'images/rs485-controller/component-side.jpg',
        'additional_photo_page': s.page,
        'product_photo_sha256': {name: sha256(REPO / f'images/rs485-controller/{name}.jpg') for name in ['component-side', 'with-antenna', 'ports', 'label-side']},
    }
    (ROOT / 'review/build-v1.0.json').write_text(json.dumps(result, indent=2) + '\n')
    return result


if __name__ == '__main__':
    parser = argparse.ArgumentParser(description=__doc__)
    parser.add_argument('--output', type=Path, default=ROOT / 'rs485_controller_datasheet_v1.0.pdf')
    parser.add_argument('--technical-dir', type=Path, default=ROOT / 'assets/technical-v4')
    parser.add_argument('--connection-illustration', type=Path, default=ROOT / 'assets/connection-v0.4/two-motor-connection-v0.4.pdf', help='Path to the system connection illustration.')
    args = parser.parse_args()
    args.output.parent.mkdir(parents=True, exist_ok=True)
    result = build(args.output, args.technical_dir, False, args.connection_illustration)
    print(f"Built {args.output} ({len(result['pages'])} pages; {len(result['interim_placeholders'])} interim placeholders)")
