tomrodinger/RS485_Controller/(commit log)

2025-10-18 !!! CRITICAL ISSUE: D1, the 5V TVS that protects the USB lines must be removed before use. Otherwise if you connect USB-C power, and 20V is supplied, it will burn this chip and probably damage the US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
    [0.1.kicad_pcb, 0.1.kicad_sch, PowerBD.kicad_sch, index.kicad_sch, schTop.kicad_sch, signalBD.kicad_sch]
2025-11-23 Adding version 0.2 This adds a second USB-C connector Cleans up the board to make is clean looking Adds QR code Adds holes in the corners Fixes problem with 20V going to the TVS protection in the USB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
    [0.2.kicad_pcb, 0.2.kicad_sch, PowerBD.kicad_sch, index.kicad_sch, schTop.kicad_sch, signalBD.kicad_sch]
2026-10-26 Add PCB revision 0.5 and controller product photography
    Publish the v0.5 KiCad source, assembly outputs and schematic together with real product JPEG/WebP images and connector documentation. The product datasheet, firmware demos and unfinished V1 development archive are excluded from this upload.
2026-11-04 Mark controller documentation as Arduino-only without MCP
2026-11-05 Refresh datasheet photos, pin map, and power guidance
    Save the 14-page v1.0 PDF, white-background photo masters and derivatives, GPIO/PCB aliases, HASL PD-pad corrections, and programming/external-supply instructions. Extend verification and retain a context-reset handoff with source and build evidence.
